elsp02/cubes-platformIO/firmware/src/firmware_baseplate/README.md

main_baseplate_feedback2.cpp: mit predefined feedback data, kein pc steuerung und debug möglichkeit
uart_main_baseplate.cpp: mit originalem feedback data, pc steuerung, keine debug möglichkeit - fuktioniert
state_machine.cpp: baseplate als state machine
state_machine_debug: ohne pc control und mit vordifiniertem feedback payload
