elsp02/cubes-platformIO/docs/fehler.md

predefined: 3 laufen -> also sowohl payload korrekt als auch led
normal: die drei laufen auch nicht 
debug: alle laufen 

feedback payload len
