elsp02/cubes-platformIO/doc/firmware.md

#content
Ablaufdiagramm und Struktur der Software von baseplate

---
## generell
### child polling
### vlt auch main loop und frame reception

## baseplate
was macht die basplate im code?
###  role
The baseplate is the root of the system. It starts the communication and receives the complete serialized cube tree.

### main loop
1. Release all lines.
2. Send CMD_STATUS to child.
3. Wait for ACK_BUSY.
4. Receive DATA_FRAME.
5. Validate frame.
6. Parse payload.
7. Output tree.
### baseplate flowchart -optional

```mermaid
flowchart TD
    A[Start loop] --> B[Release child line]
    B --> C[Send CMD_STATUS]
    C --> D[Wait for ACK_BUSY]
    D -->|No ACK| A
    D -->|ACK received| E[Receive DATA_FRAME]
    E -->|Invalid frame| A
    E -->|Valid frame| F[Parse payload]
    F --> G[Print / forward tree]
    G --> A
```
### (frame reception and) payload parsing

### error behavior??

### pseudocode
void loop()
{
    send_status_command(child_0);

    if (!receive_ack_busy(child_0)) {
        return;
    }

    if (!receive_frame(child_0, payload, MAX_PAYLOAD_LEN, &payload_len)) {
        return;
    }

    parse_payload_to_tree(payload, payload_len, &root_index);
}
### payload parsing
nicht die Theorie, sondern wann die Baseplate den Parser benutzt.

After the baseplate receives and validates a complete data frame, it passes only the payload to the tree parser. The parser reconstructs the n-ary tree recursively.
---
## cube
### role
Each cube acts as a child toward its parent and as a parent toward its own children.

### state machine diagram
```mermaid
stateDiagram-v2
    [*] --> IDLE
    IDLE --> ORIENTATION_SCAN
    ORIENTATION_SCAN --> RECEIVE_CMD: LOW detected
    RECEIVE_CMD --> IDLE: byte != CMD_STATUS
    RECEIVE_CMD --> SEND_ACK: byte == CMD_STATUS
    SEND_ACK --> POLL_CHILDREN
    POLL_CHILDREN --> BUILD_PAYLOAD
    BUILD_PAYLOAD --> SEND_FRAME_UPSTREAM
    SEND_FRAME_UPSTREAM --> RELEASE_LINES
    RELEASE_LINES --> IDLE
```

### main loop

### pseudo code

```mermaid
sequenceDiagram
    participant P as Parent Cube / Baseplate
    participant C as Cube Node
    participant CC as Child Cubes

    P->>C: CMD_STATUS
    P-->>C: Release line

    C->>C: Detect active upstream pin
    C->>C: Store orientation
    C->>P: ACK_BUSY

    loop For each retry round and child port
        C->>CC: CMD_STATUS
        CC->>C: ACK_BUSY
        CC->>C: DATA_FRAME
        C->>C: Store child payload
    end

    C->>C: Build own payload
    C->>P: DATA_FRAME<br/>SYNC | LEN | PAYLOAD | CHECKSUM
```
