elsp02/cubes-platformIO/thesis/figures/blockdiagramm-baseplate.pdf

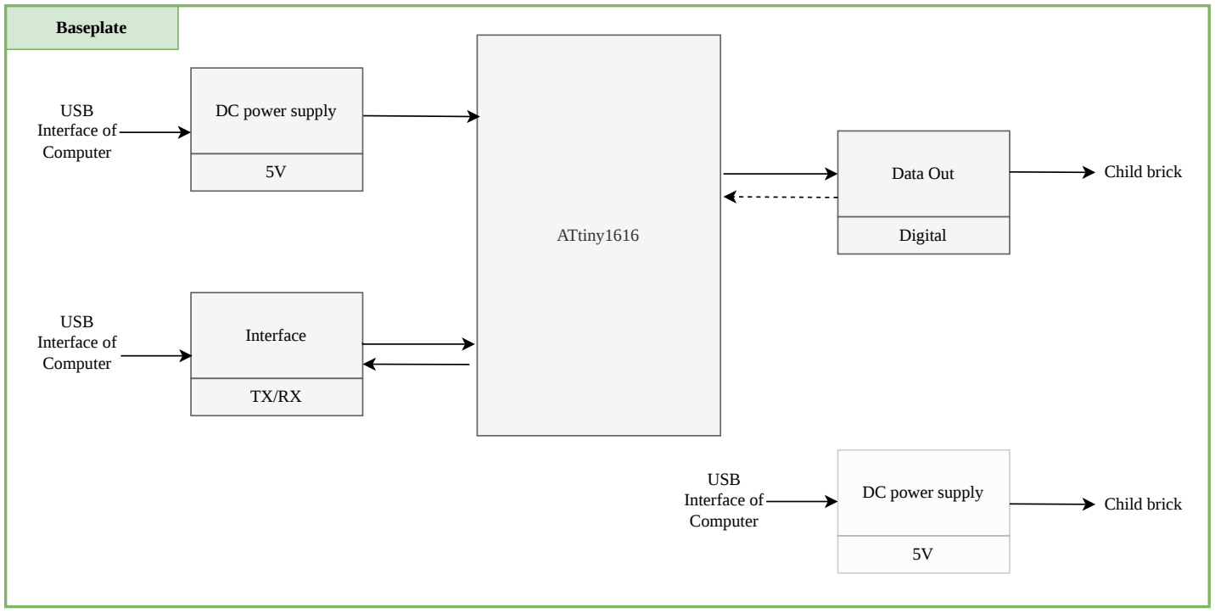
[picture p5: figure]
ATtiny1616; Data Out; DC power supply; Digital; USB Interface of Computer; Child brick; Interface; Baseplate
