elsp02/cubes-platformIO/thesis/figures/blockdiagramm-brick.pdf

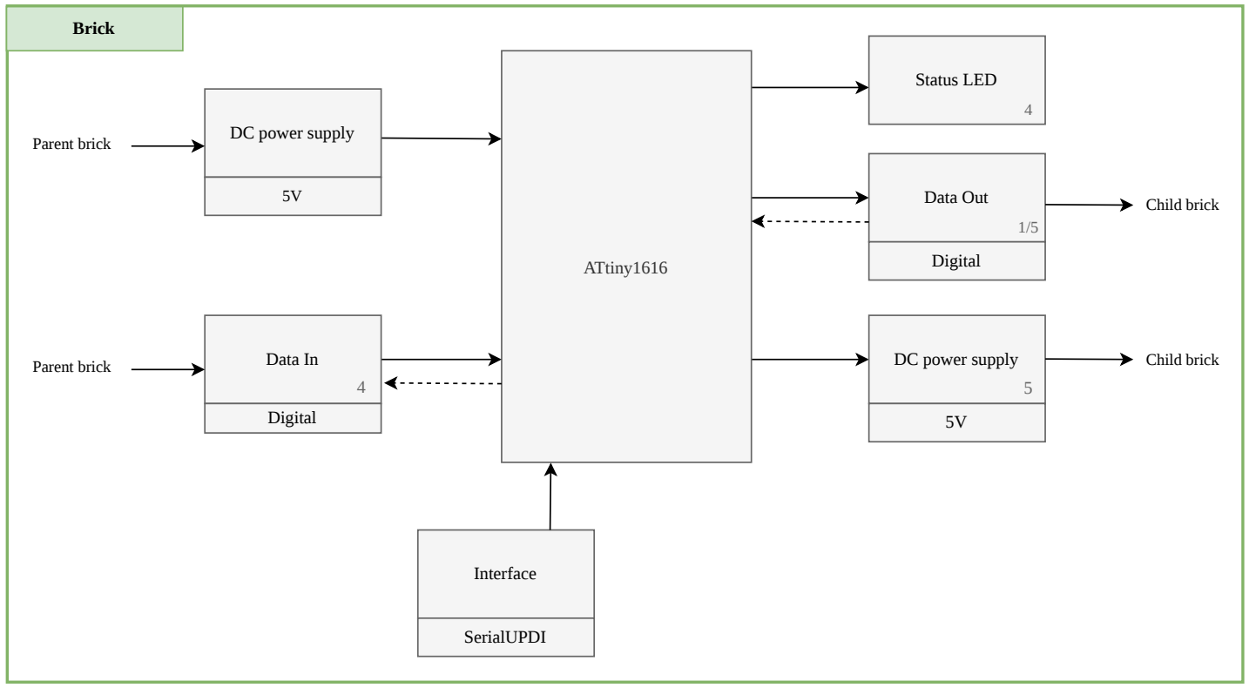
[picture p6: figure]
ATtiny1616; Status LED; Data Out; Data In; DC power supply; Digital; Interface; SerialUPDI; Parent brick; Child brick; Brick
