elsp02/cubes-platformIO/thesis/figures/concept-blockdiagramm.pdf

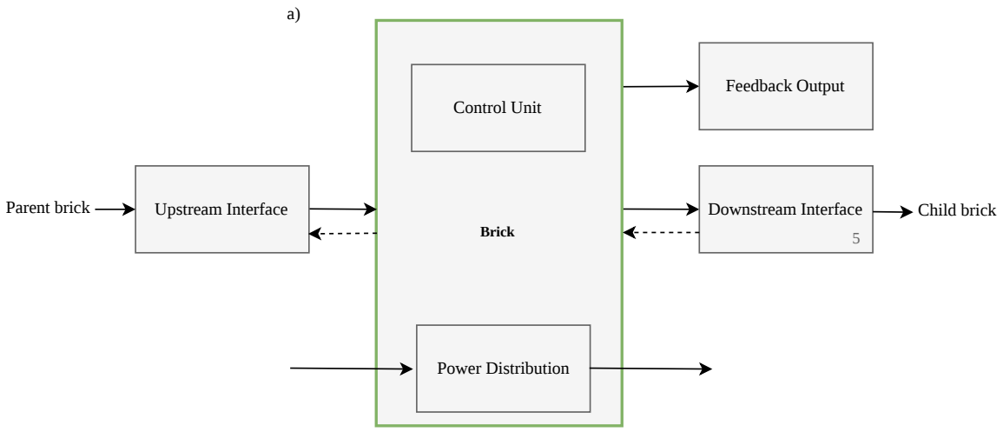
[picture p7: figure]
Feedback Output; Upstream Interface; Downstream Interface; Parent brick; Power Distribution; Control Unit; Brick; Child brick
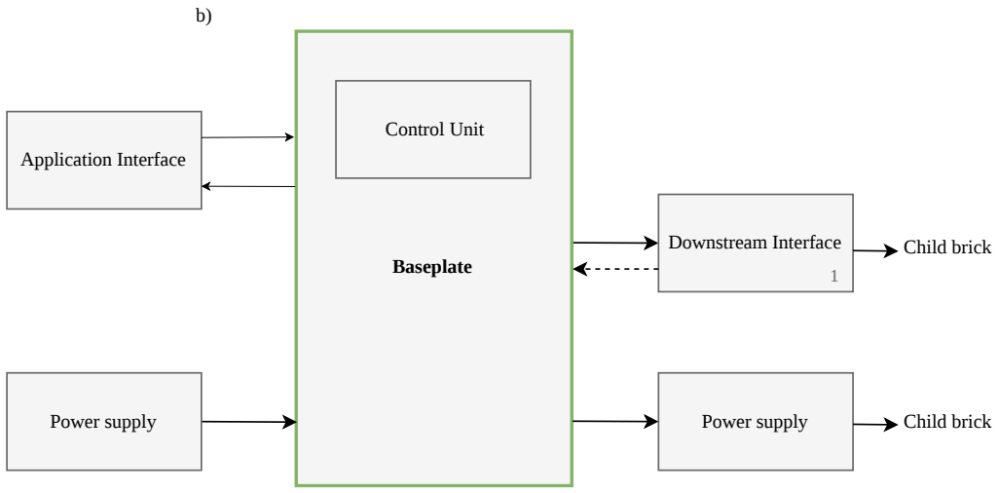
[picture p8: figure]
Downstream Interface; Child brick; Control Unit; Baseplate; Application Interface; Power supply
