elsp02/cubes-platformIO/comments/pdf/config.pdf

include\config.h

1 // Define configuration constants for the project 2 #ifndef CONFIG_H
3 #define CONFIG_H
4
5 #include <Arduino.h>
6 #include <avr/io.h>
7 #include <stdint.h>
8 #include <stdbool.h>
9
10 #ifndef F_CPU
11 | #define F_CPU 20000000UL | // better to define in .ini file: build_flags = -DF_CPU=20000000UL/board_build.f_cpu = 20000000L
12 #endif
13
14 // ----------------------------------------------------------
15 // Timing
16 // ----------------------------------------------------------17
18 | #define BAUD_US | 104
19 | #define TURNAROUND_US | (BAUD_US * 3)
20 | #define CHILD_TIMEOUT_US | 15000
21 | #define PARENT_TIMEOUT_US | 15000
22 | #define FRAME_TIMEOUT_US | 15000
23
24 // ----------------------------------------------------------25 // Counts / Limits
26 // ----------------------------------------------------------
27 | #define CHILD_COUNT | 2
28 | #define CHILD_RETRIES | 3
29 | #define UPSTREAM_FAIL_LIMIT | 3
30
31 // ???????????
32 | #define NODE_HEADER_LEN | 3
config.h | http://localhost:54352/4e486bd0-b9ec-40f0-b269-f2023e1451f3/
1 von 2 | 06.06.2026, 12:30

33 //macht so nicht so viel sinn, weil letztes child in upstream reihe ja eigentliche alle payloads von allen anderen bekommt -> child payload lenght kann nicht einfach so mit max_length durch anzahl kinder berechnet werden
34 | #define MAX_PAYLOAD_LEN | 128 // must be <256 for 1 byte LEN field, but should also be limited to avoid long transmission
times and large buffers. For prototype_v3, we can set it to 128 as a reasonable limit for testing.
35 | #define MAX_CHILD_PAYLOAD_LEN | 128 //I don´t need this
36
37 // ----------------------------------------------------------
38 // Protocol bytes
39 // ----------------------------------------------------------40
41 | #define CMD_STATUS | 0xAA
42 | #define ACK_BUSY | 0x55
43 | #define DATA_BYTE | 0x42
44 | #define SYNC_BYTE | 0xA5
45
46 // ----------------------------------------------------------47 // Node data
48 // ----------------------------------------------------------49
50 | #define NODE_ID | 0x10
51
52 #endif // CONFIG_H
config.h | http://localhost:54352/4e486bd0-b9ec-40f0-b269-f2023e1451f3/
2 von 2 | 06.06.2026, 12:30
