elsp02/cubes-platformIO/firmware/src/firmware_cube/README.md

old_uart_main_cube.cpp: sollte so sein wie in code_improved branch
final_uart_main_cube.cpp: angepasst auf code_improved branch und aktueller firmware struktur (aufgeteilt in unterordner) - funktioniert
