elsp02/cubes-platformIO/doc/visualization.md

# Visualization
(noch zu machen)

## Data Pipeline

Serialized payload
→ Parsed tree
→ Coordinate/orientation interpreter
→ JSON structure
→ Three.js or MeshCat visualization

## Coordinate Interpreter

The absolute position of a cube is calculated recursively from the parent position, parent rotation, child port direction, and local orientation.

## visualization und gaming -> bedürfnisse von special needs kindern berücksichtigen (tui designanforderungen)
physische representation der steine/abstrakheit
- die bausteine schauen physisch als auch visualiziert gleich aus

komplexität:
- Design zu einfach (langweilig) vs Design zu komplex (überfordernd)
