elsp02/cubes-platformIO/thesis/figures/systemarchitektur_komponenten.pdf

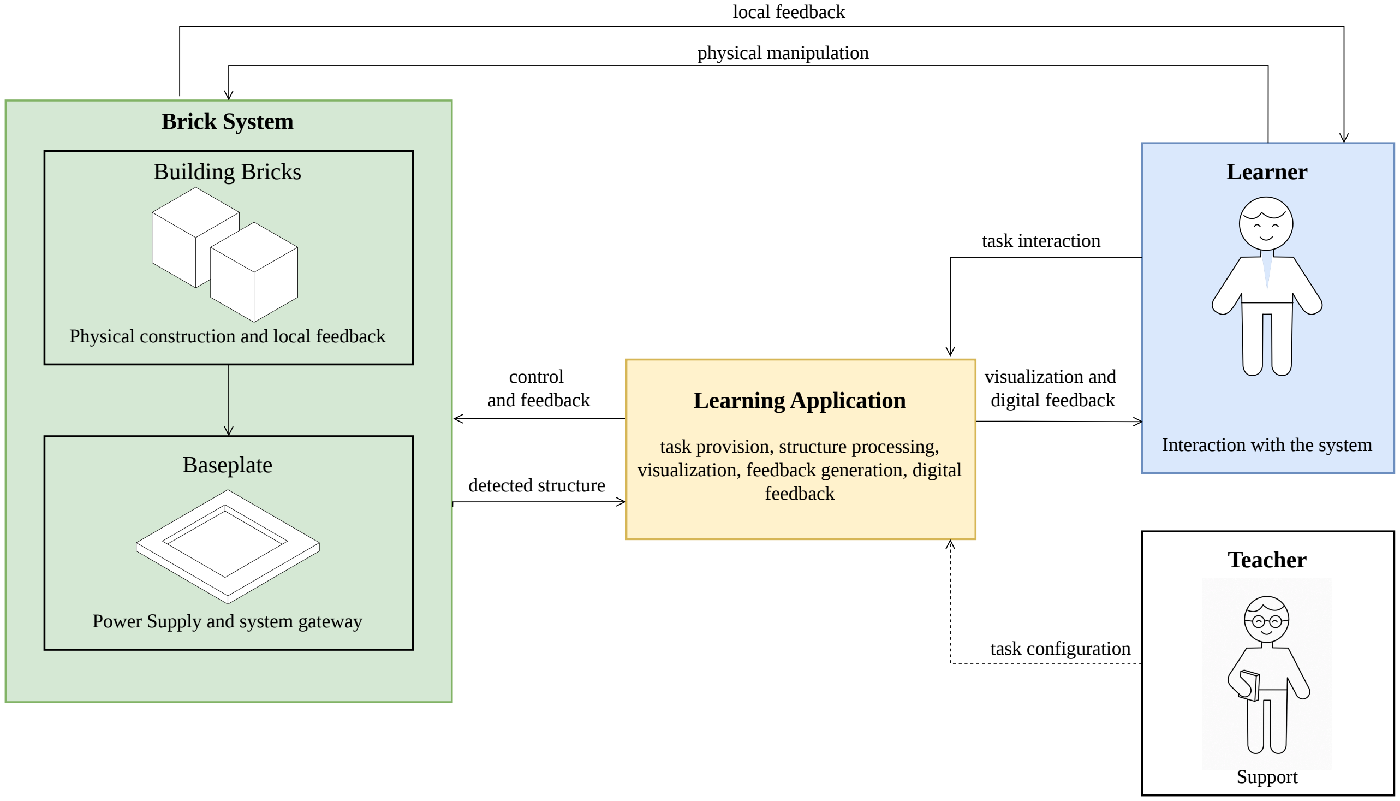
[picture p9: figure]
task configuration; Power Supply and system gateway; Baseplate; Building Bricks; Learning Application; task provision, structure processing,; feedback; Interaction with the system; physical manipulation; Learner; local feedback; task interaction; visualization and digital feedback; detected structure; control and feedback; Brick System; Teacher; Support

Physical construction and local feedback

visualization, feedback generation, digital
