elsp02/cubes-platformIO/doc/diagrams/generated/systemarchitecture_diagramm_v2_preview.png

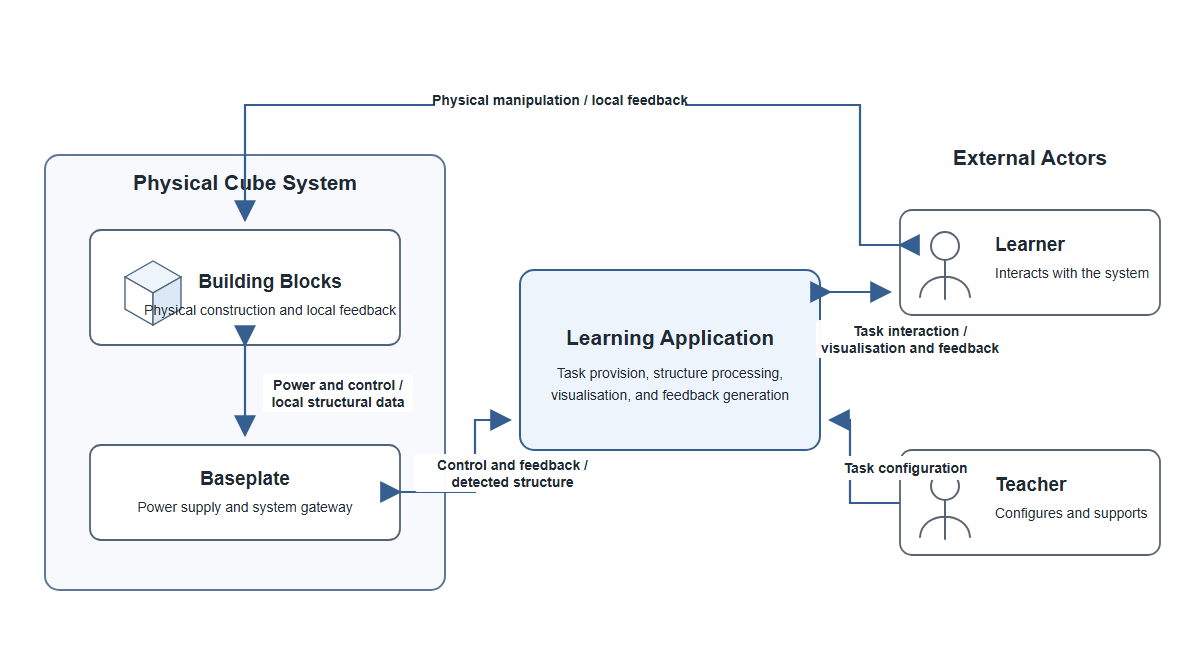
doc/diagrams/generated/systemarchitecture_diagramm_v2_preview.png
