elsp02/cubes-platformIO/figures/brick-orientation.jpg

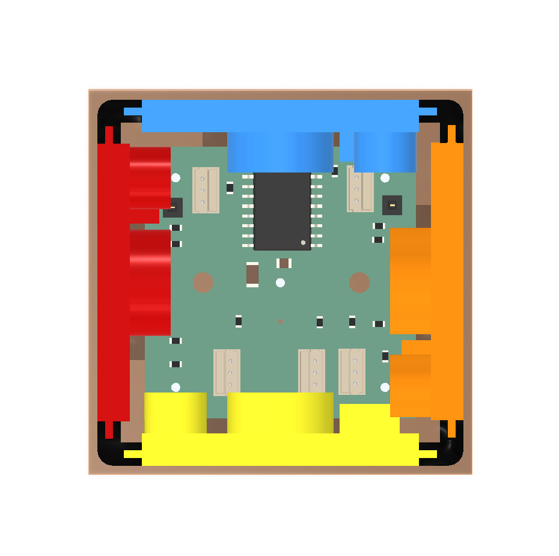
figures/brick-orientation.jpg
