elsp02/cubes-platformIO/figures/faces-ohne-hintergrund.png

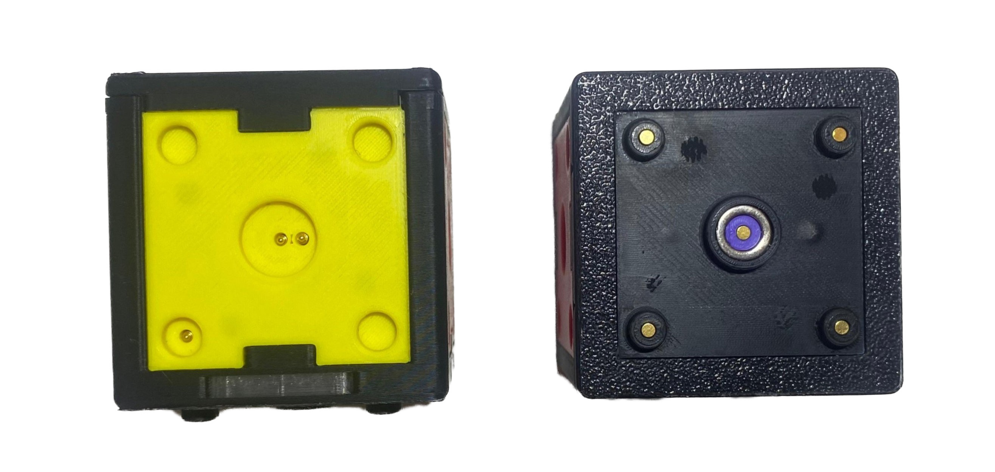
figures/faces-ohne-hintergrund.png
