elsp02/cubes-platformIO/figures/Hintergrund.jpg

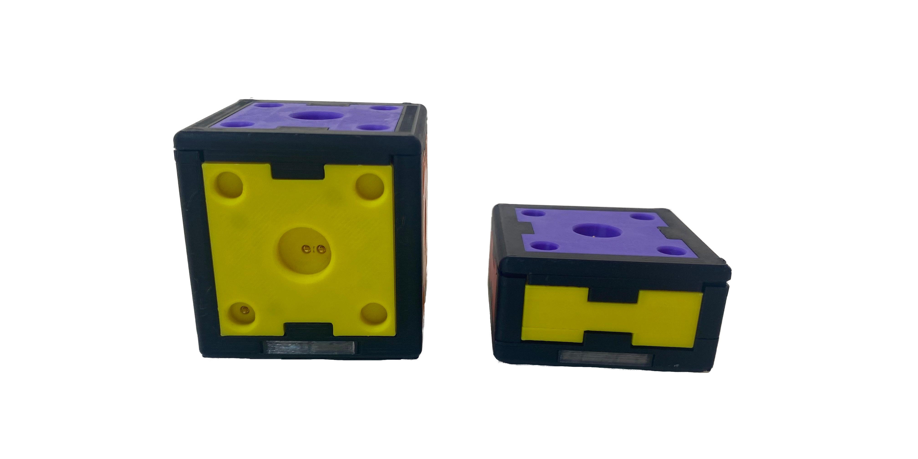
figures/Hintergrund.jpg
