elsp02/cubes-platformIO/software/threejs_visualization/frontend/img/gif/brick_loader.gif

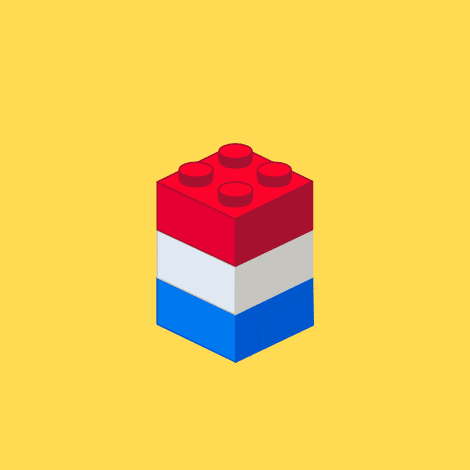
software/threejs_visualization/frontend/img/gif/brick_loader.gif
