elsp02/cubes-platformIO/thesis/figures/activecube.png

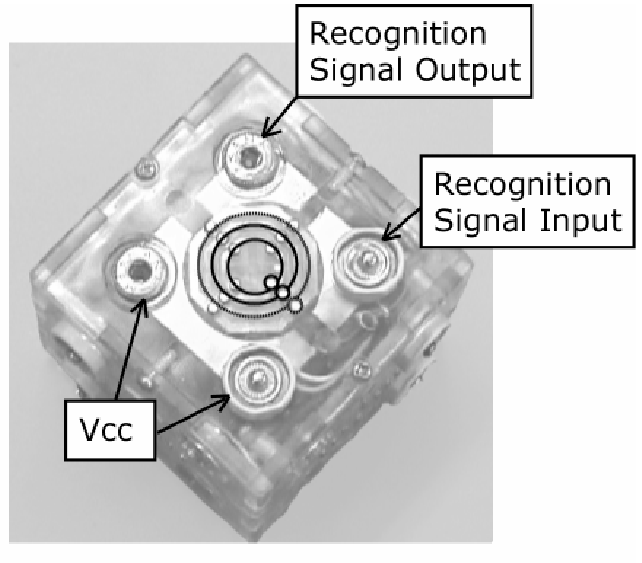
thesis/figures/activecube.png
