elsp02/cubes-platformIO/thesis/figures/baseplate.jpg

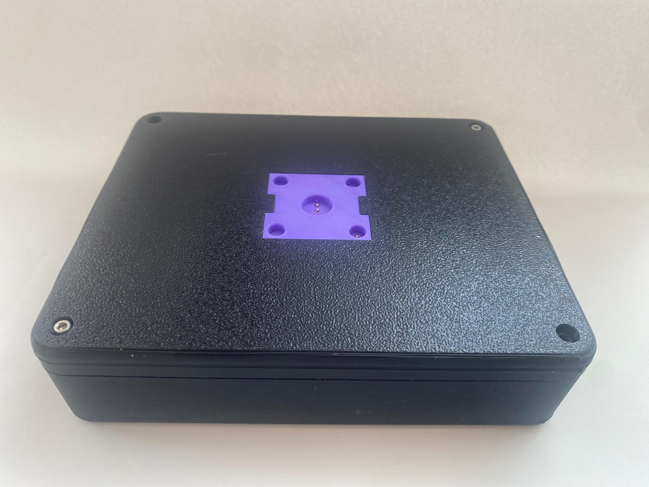
thesis/figures/baseplate.jpg
