elsp02/cubes-platformIO/thesis/figures/baseplate@3x.png

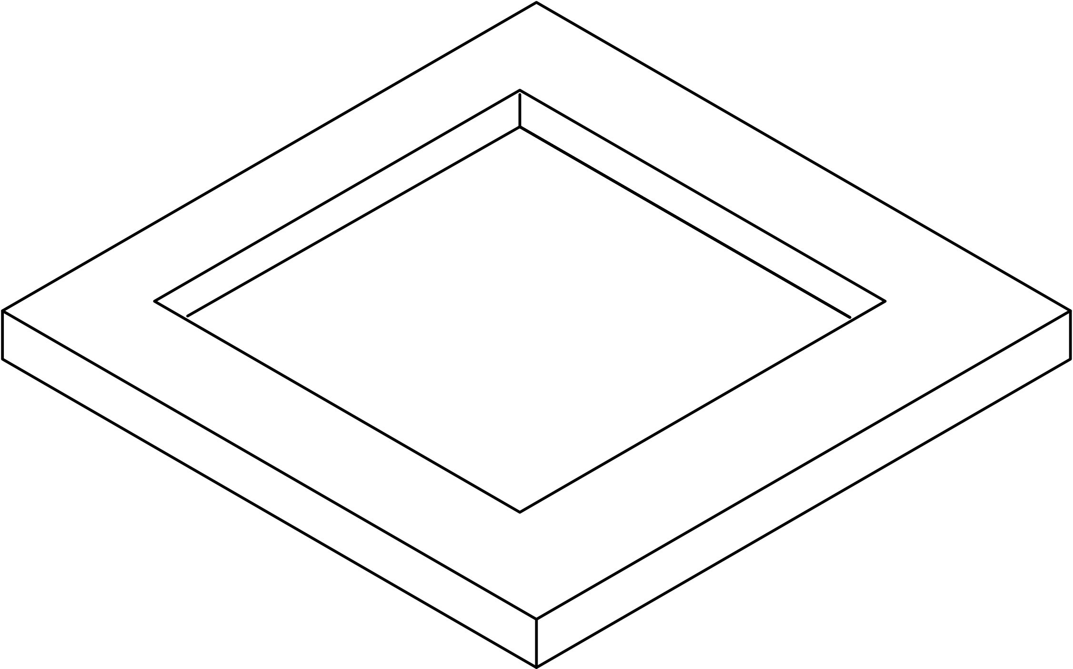
thesis/figures/baseplate@3x.png
