elsp02/cubes-platformIO/thesis/figures/bauen2.png

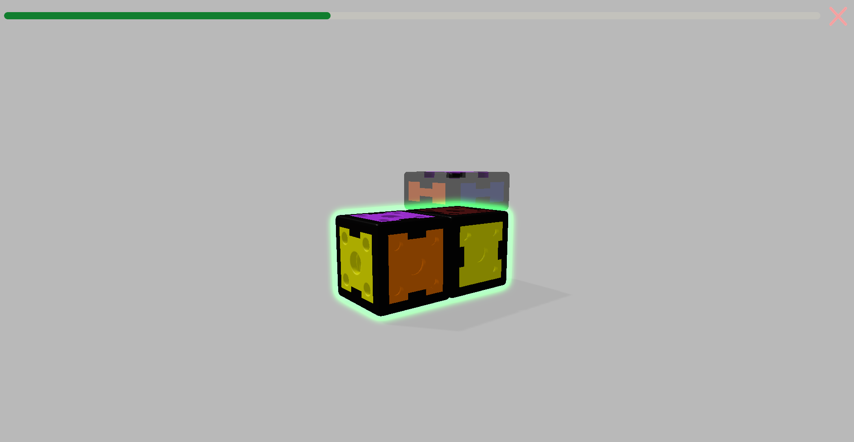
thesis/figures/bauen2.png
