elsp02/cubes-platformIO/thesis/figures/bricks-and-visualization.jpg

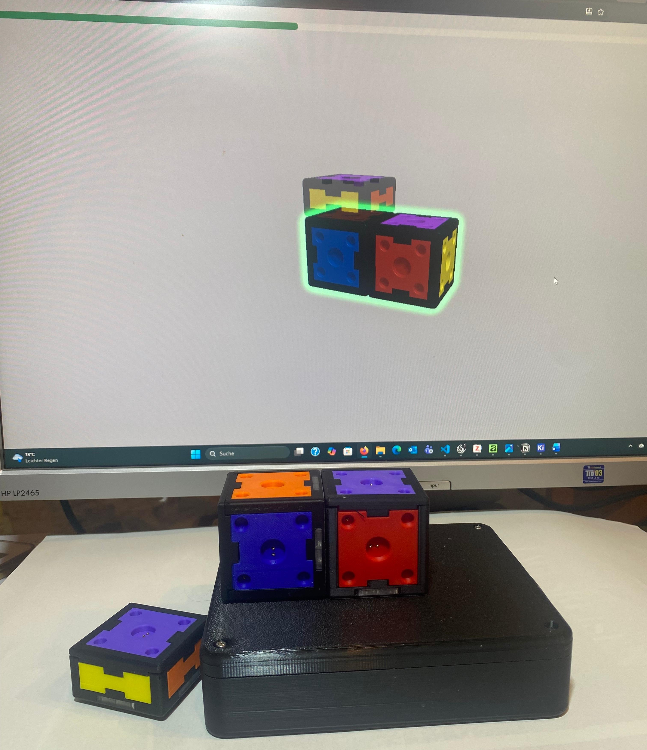
thesis/figures/bricks-and-visualization.jpg
