elsp02/cubes-platformIO/thesis/figures/bricks-konstruktion.jpg

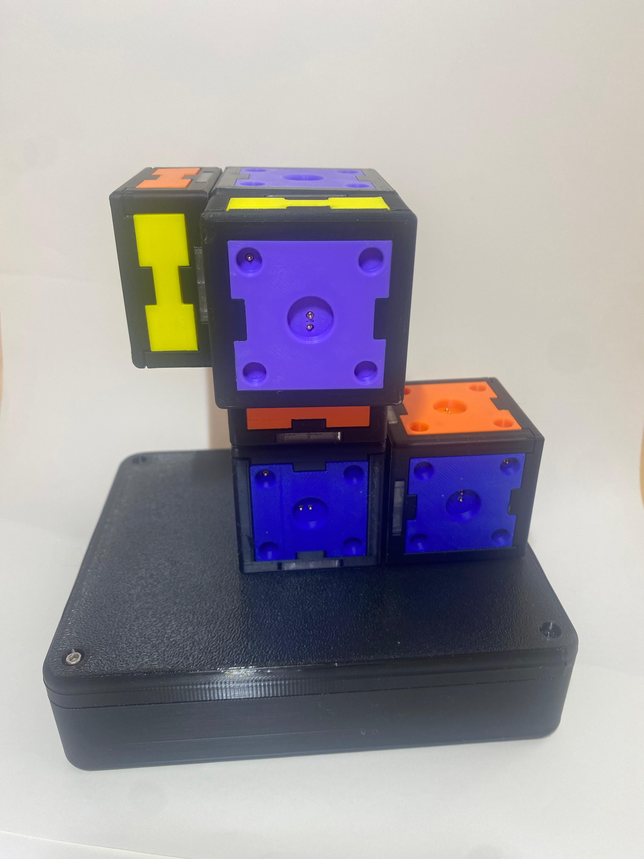
thesis/figures/bricks-konstruktion.jpg
