elsp02/cubes-platformIO/thesis/figures/bricks-physisch.jpg

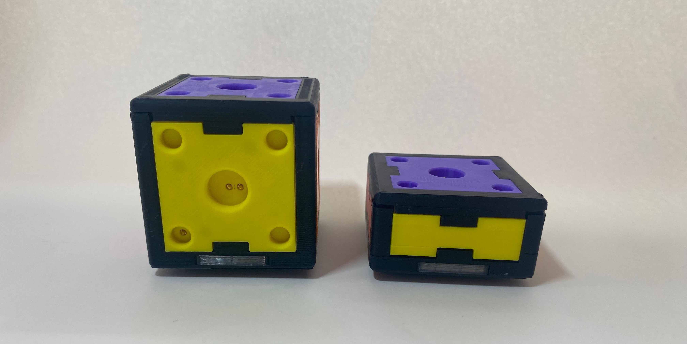
thesis/figures/bricks-physisch.jpg
