elsp02/cubes-platformIO/thesis/figures/bricks.png

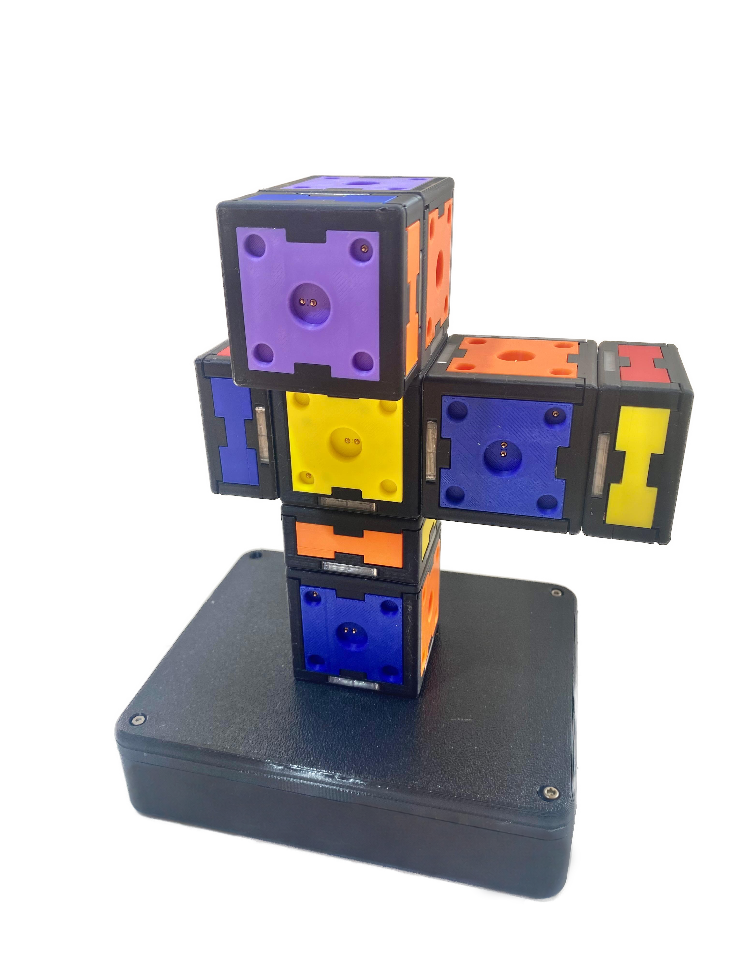
thesis/figures/bricks.png
