elsp02/cubes-platformIO/thesis/figures/contact-arrangement@3x.png

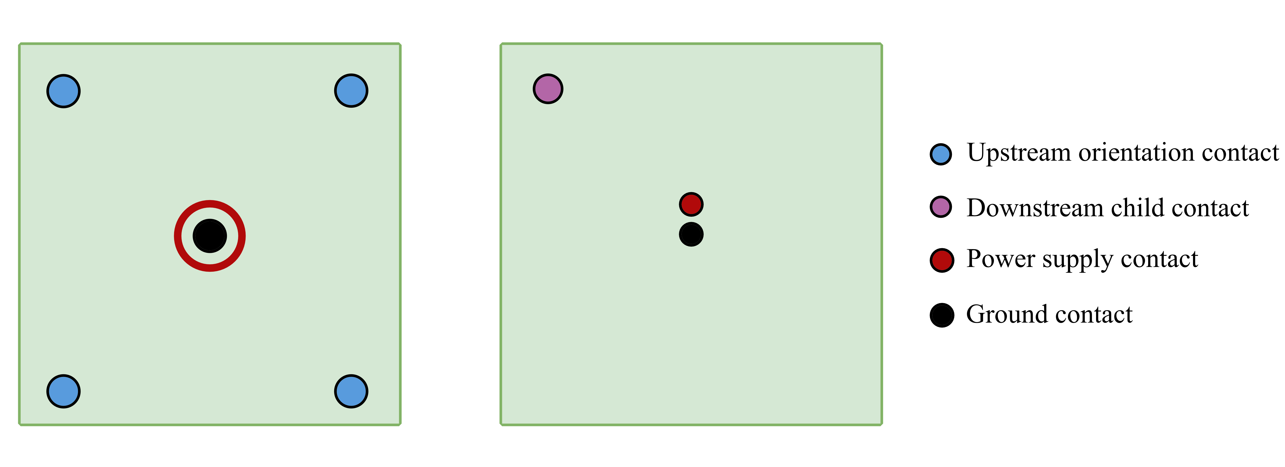
thesis/figures/contact-arrangement@3x.png
