elsp02/cubes-platformIO/thesis/figures/correct-brick.png

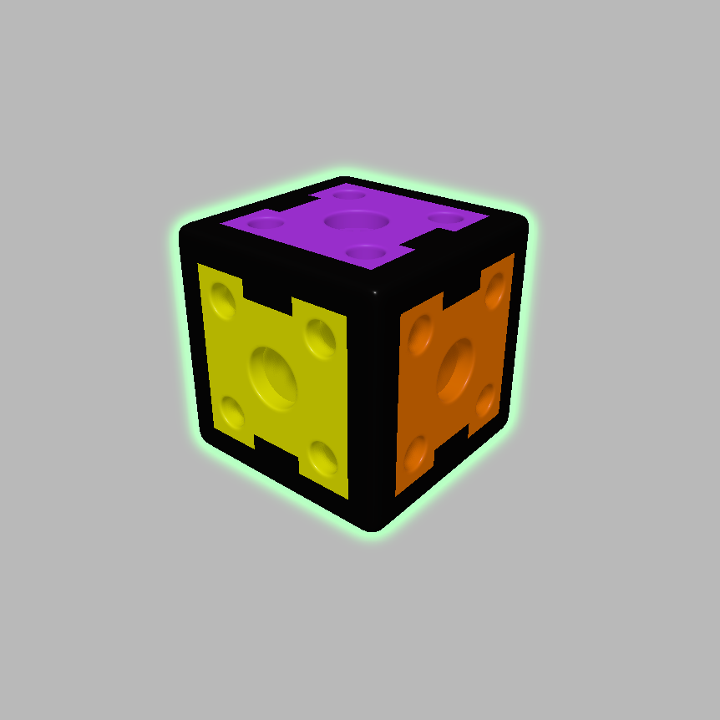
thesis/figures/correct-brick.png
