elsp02/cubes-platformIO/thesis/figures/coupling@3x.png

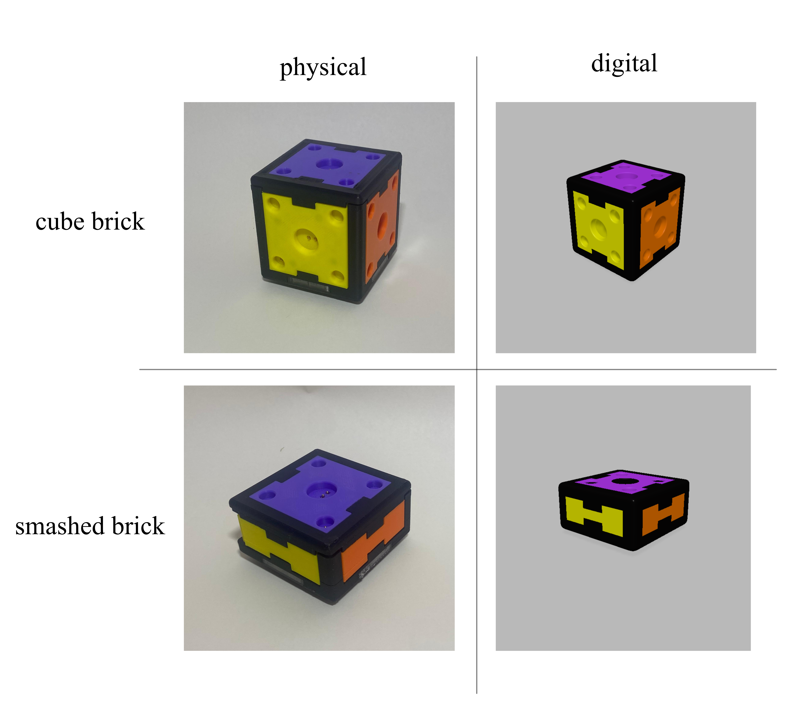
thesis/figures/coupling@3x.png
