elsp02/cubes-platformIO/thesis/figures/cube-brick2.png

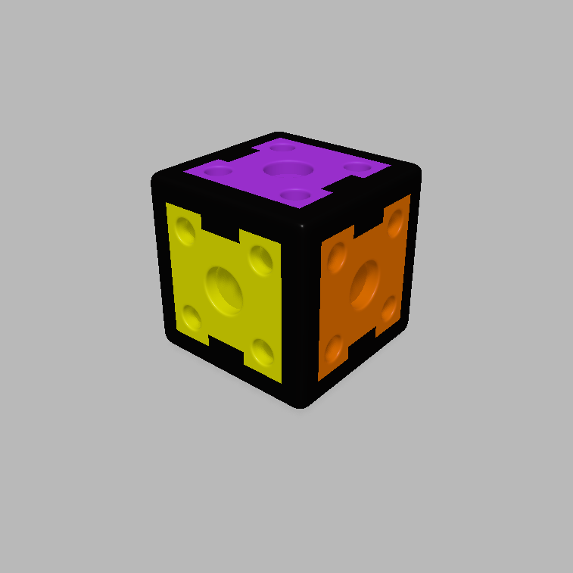
thesis/figures/cube-brick2.png
