elsp02/cubes-platformIO/thesis/figures/cube-brick-physisch.jpg

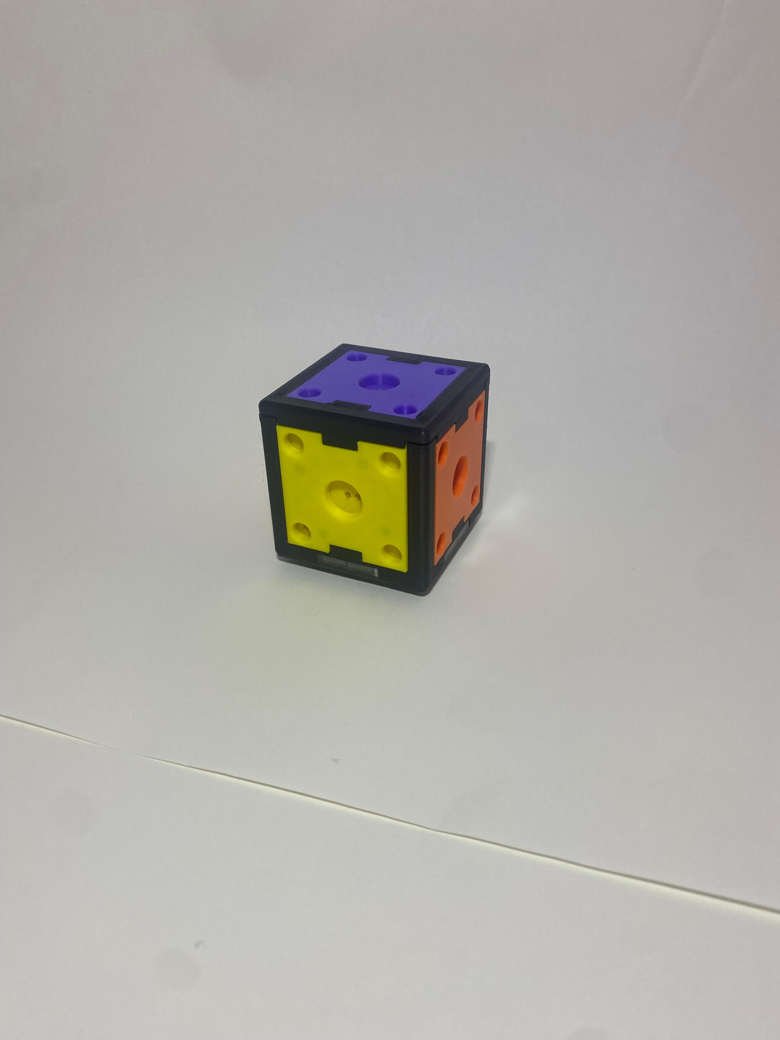
thesis/figures/cube-brick-physisch.jpg
