elsp02/cubes-platformIO/thesis/figures/cube-exploded.jpg

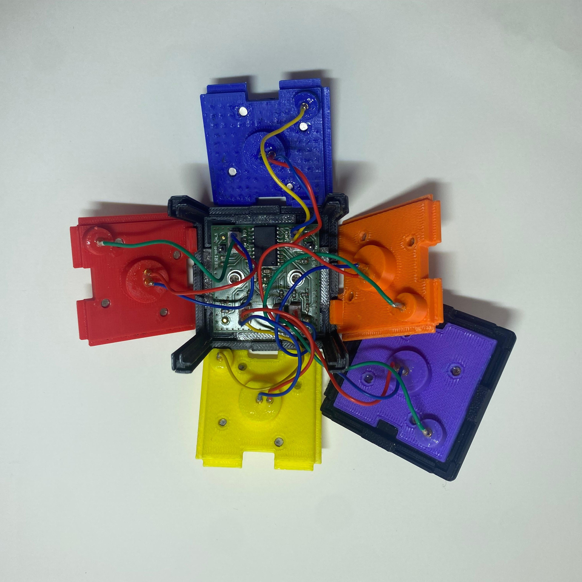
thesis/figures/cube-exploded.jpg
