elsp02/cubes-platformIO/thesis/figures/cube@3x.png

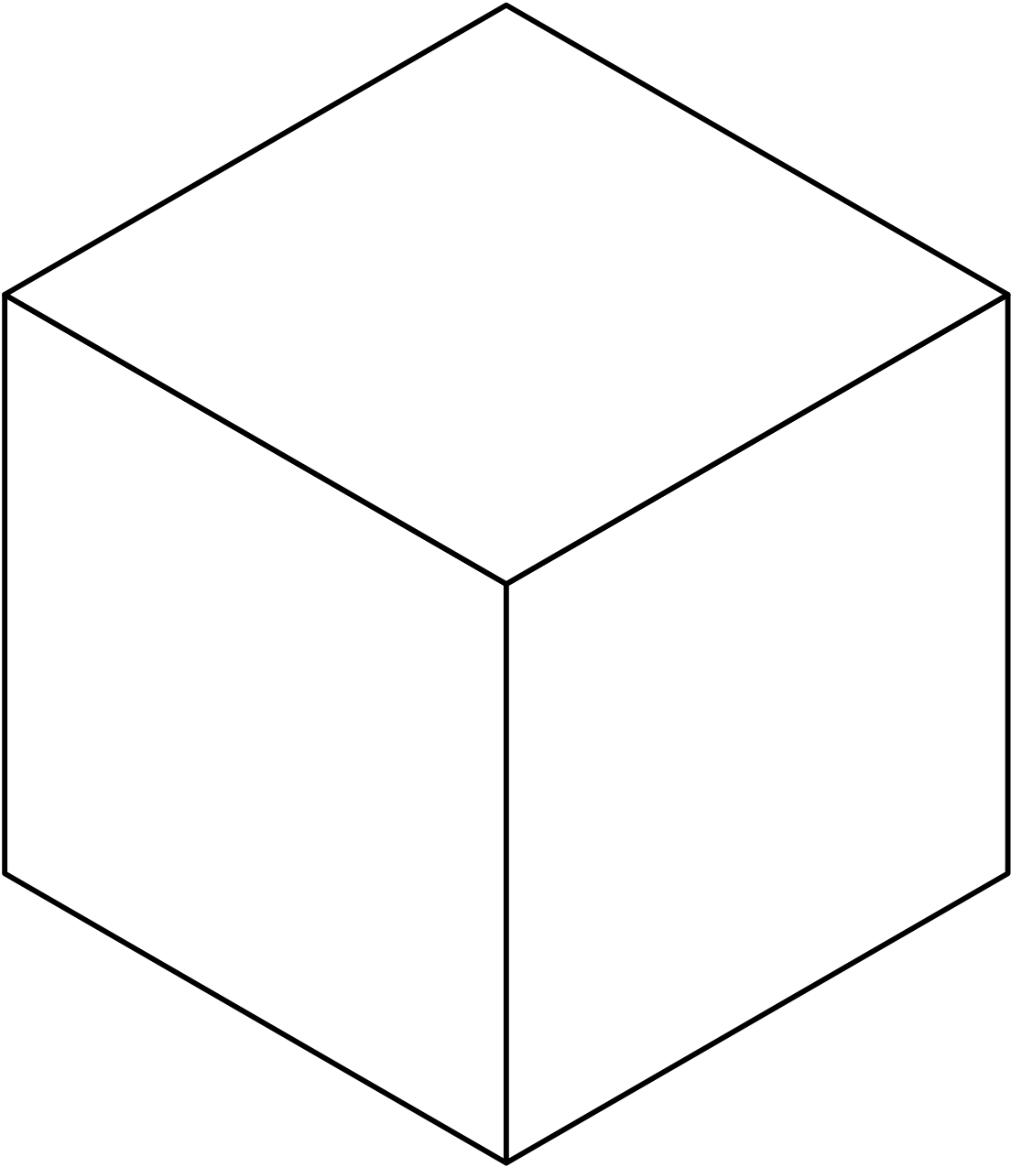
thesis/figures/cube@3x.png
