elsp02/cubes-platformIO/thesis/figures/digital-feedback@3x.png

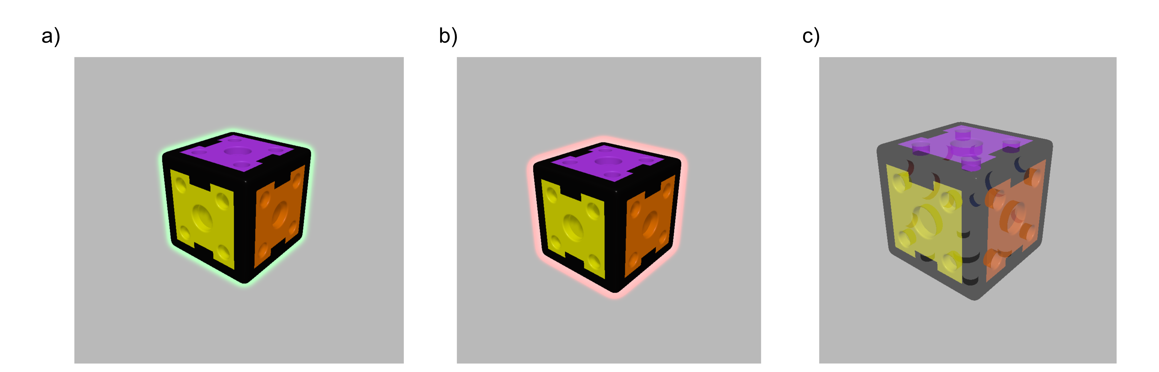
thesis/figures/digital-feedback@3x.png
