elsp02/cubes-platformIO/thesis/figures/exploded@3x.png

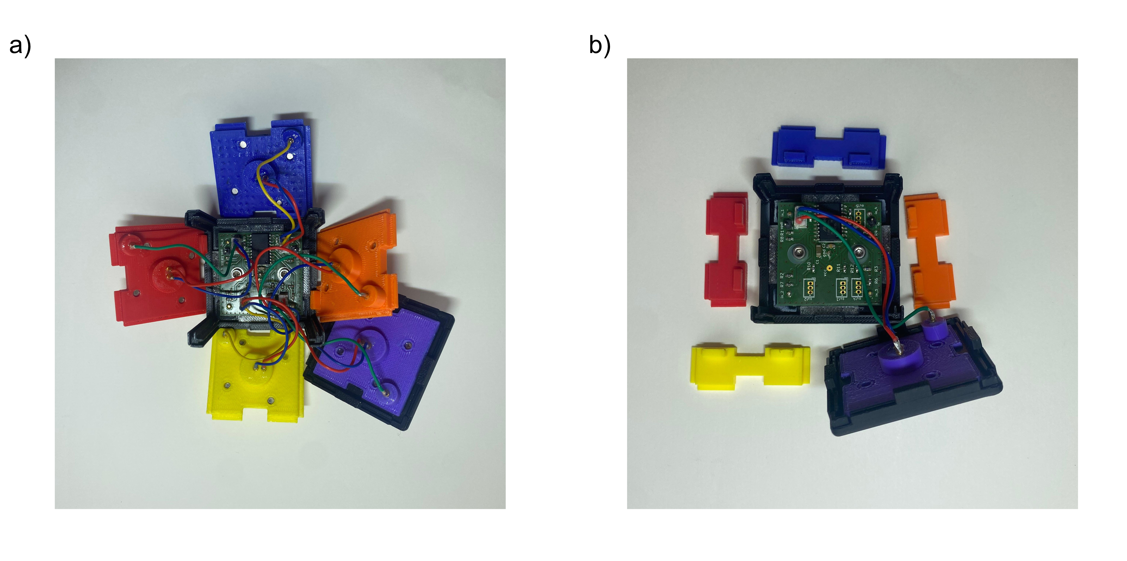
thesis/figures/exploded@3x.png
