elsp02/cubes-platformIO/thesis/figures/gui-vs-tui.jpg

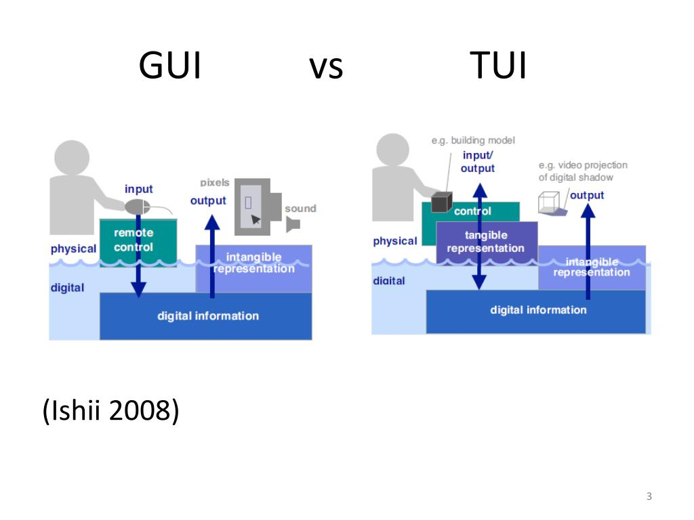
thesis/figures/gui-vs-tui.jpg
