elsp02/cubes-platformIO/thesis/figures/i-cube.png

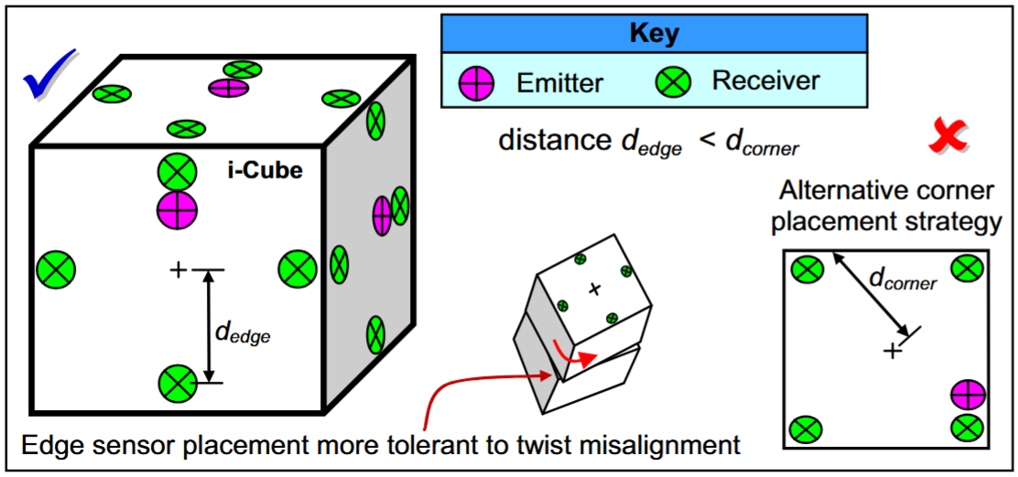
thesis/figures/i-cube.png
