elsp02/cubes-platformIO/thesis/figures/incorrect-brick.png

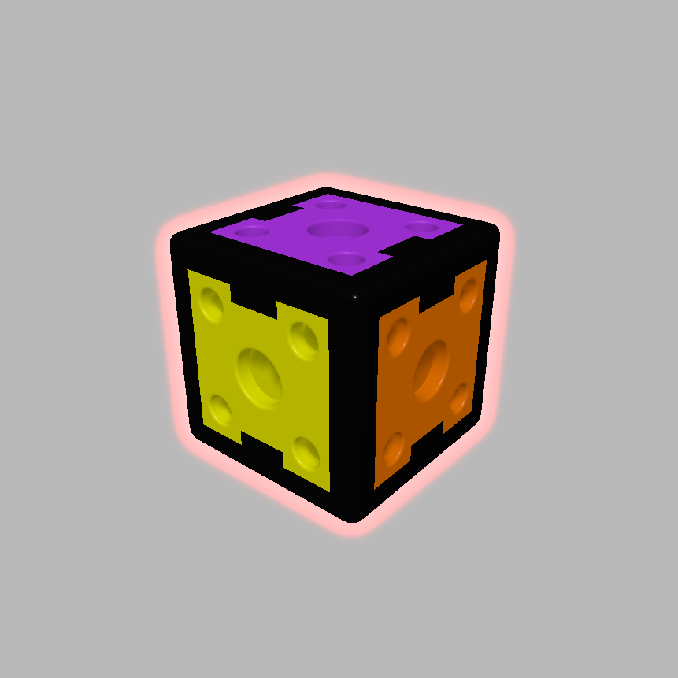
thesis/figures/incorrect-brick.png
