elsp02/cubes-platformIO/thesis/figures/kontakt-arrangement.jpg

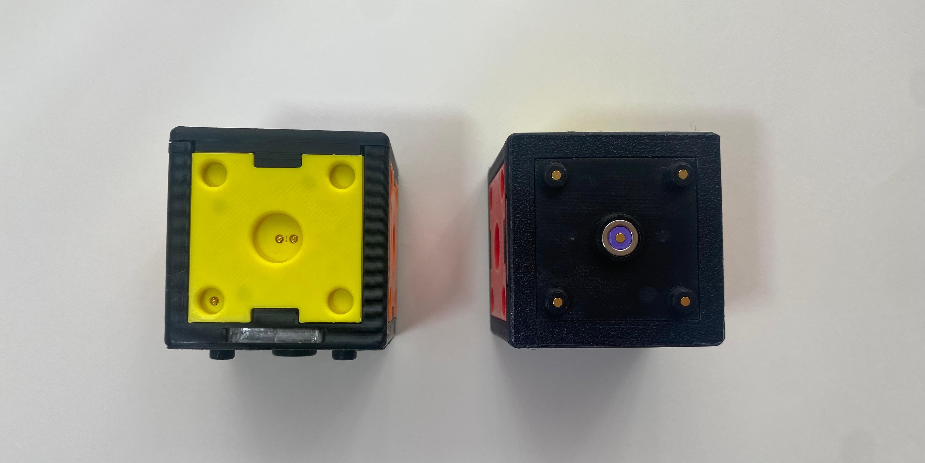
thesis/figures/kontakt-arrangement.jpg
