elsp02/cubes-platformIO/thesis/figures/learner@3x.png

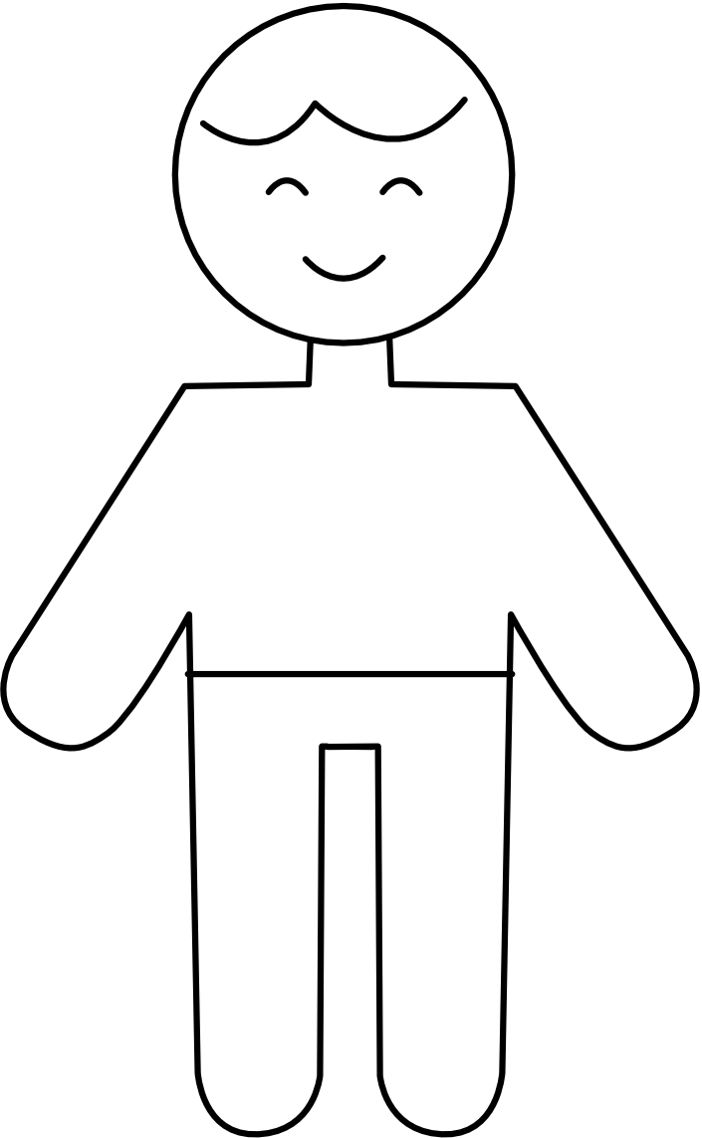
thesis/figures/learner@3x.png
