elsp02/cubes-platformIO/thesis/figures/learners1.jpg

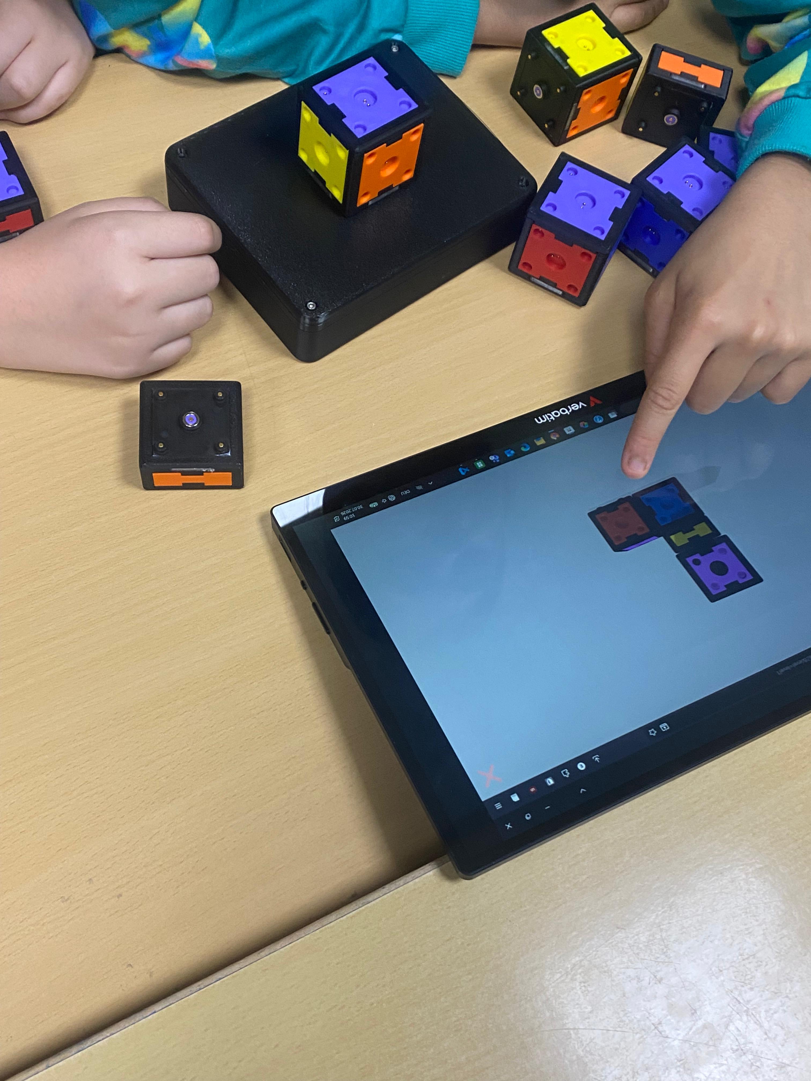
thesis/figures/learners1.jpg
