elsp02/cubes-platformIO/thesis/figures/learners.jpg

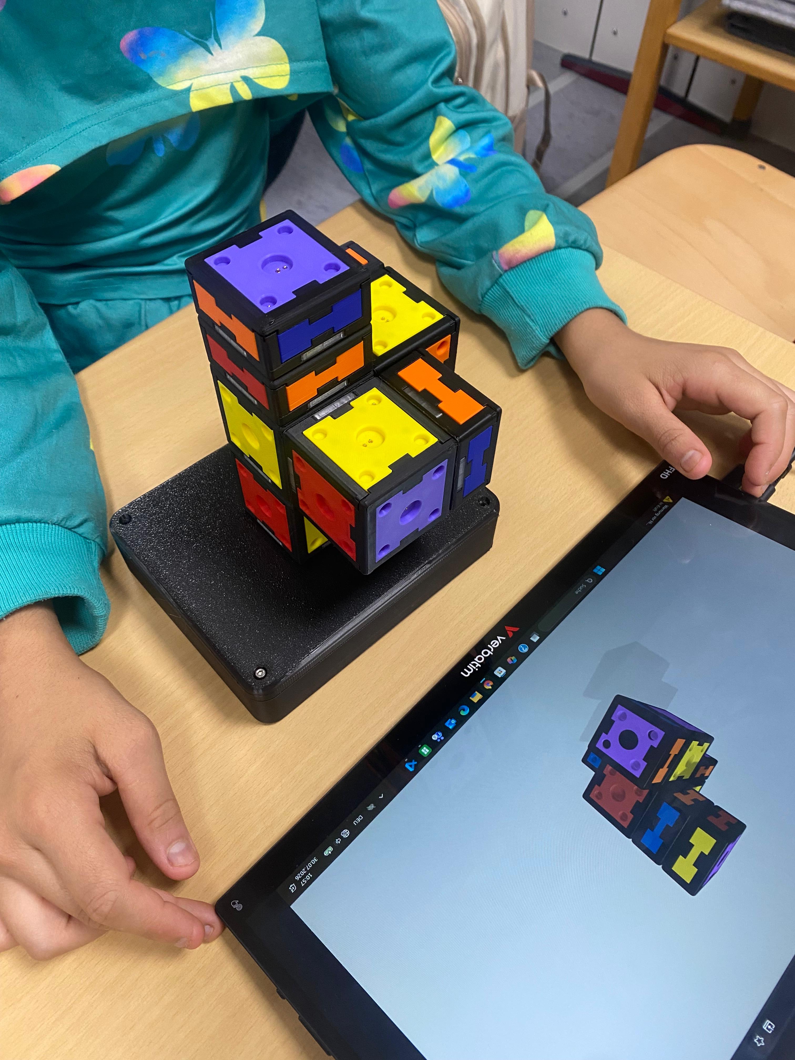
thesis/figures/learners.jpg
