elsp02/cubes-platformIO/thesis/figures/learners@3x.png

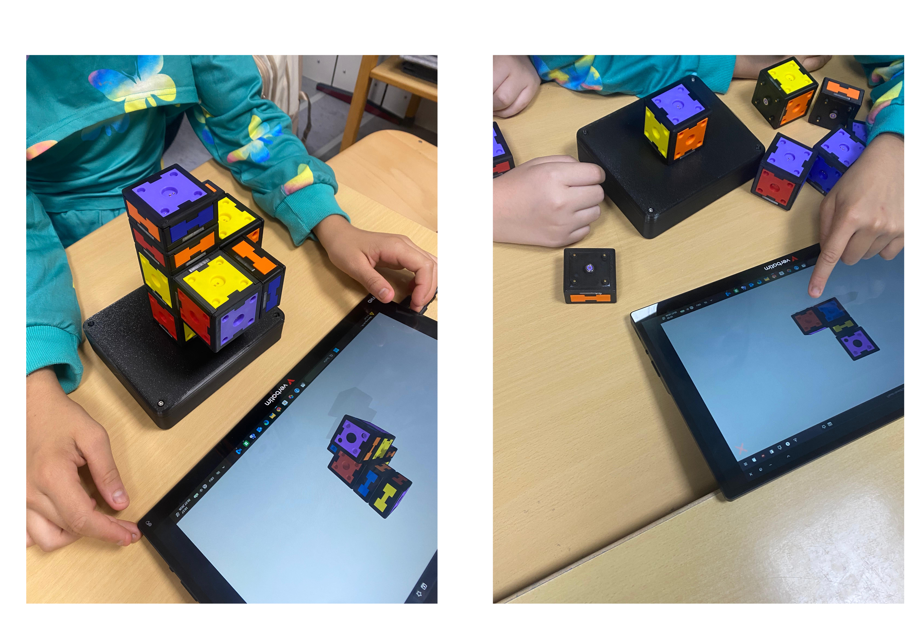
thesis/figures/learners@3x.png
