elsp02/cubes-platformIO/thesis/figures/lehrer-weisser-hintergrund.png

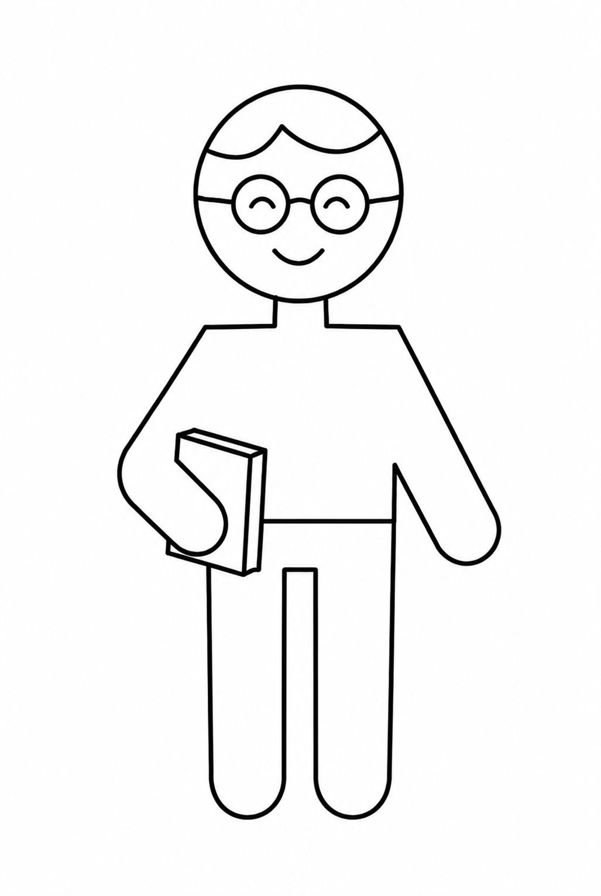
thesis/figures/lehrer-weisser-hintergrund.png
