elsp02/cubes-platformIO/thesis/figures/level-easy.png

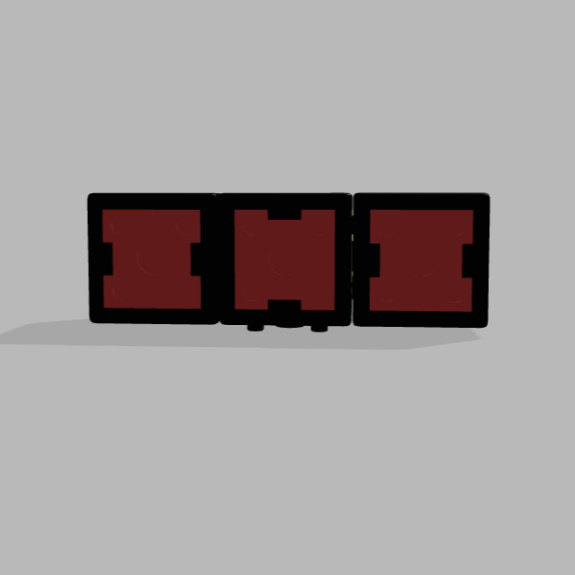
thesis/figures/level-easy.png
