elsp02/cubes-platformIO/thesis/figures/level-komplex.png

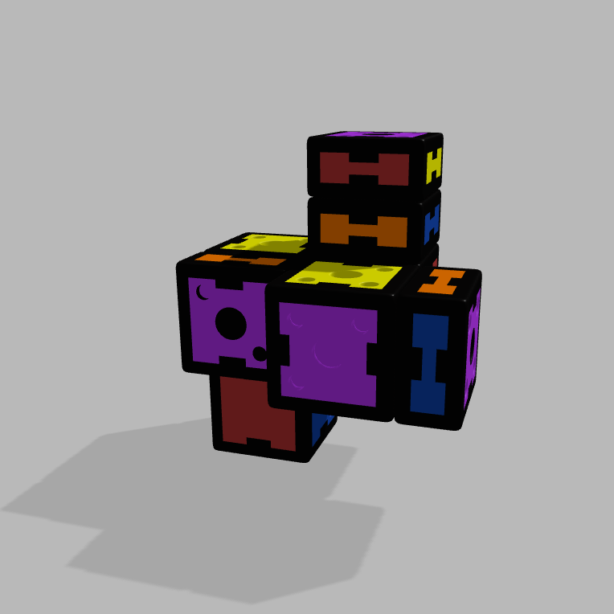
thesis/figures/level-komplex.png
