elsp02/cubes-platformIO/thesis/figures/level-middle.png

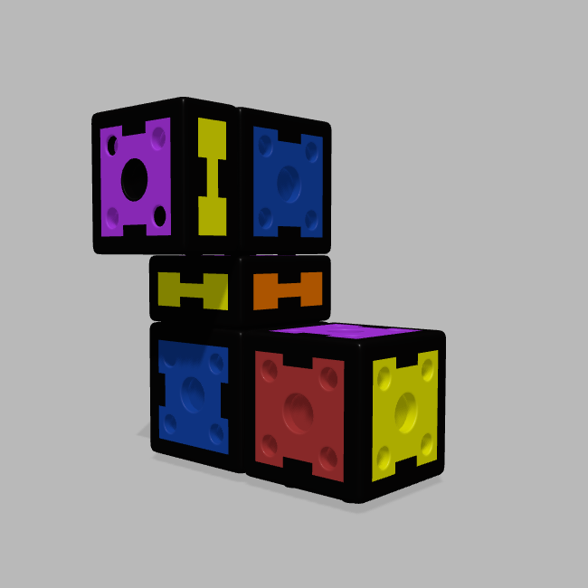
thesis/figures/level-middle.png
