elsp02/cubes-platformIO/thesis/figures/level@3x.png

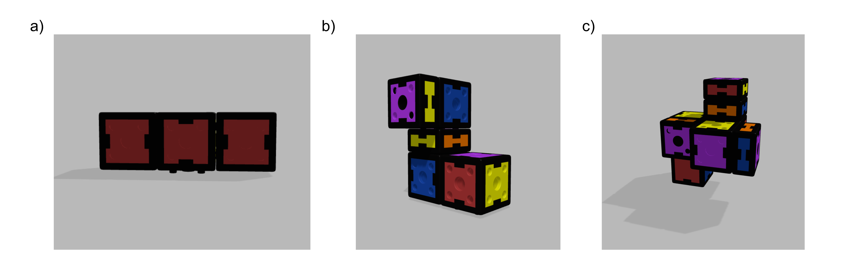
thesis/figures/level@3x.png
