elsp02/cubes-platformIO/thesis/figures/MVC-MCRpd-Model.png

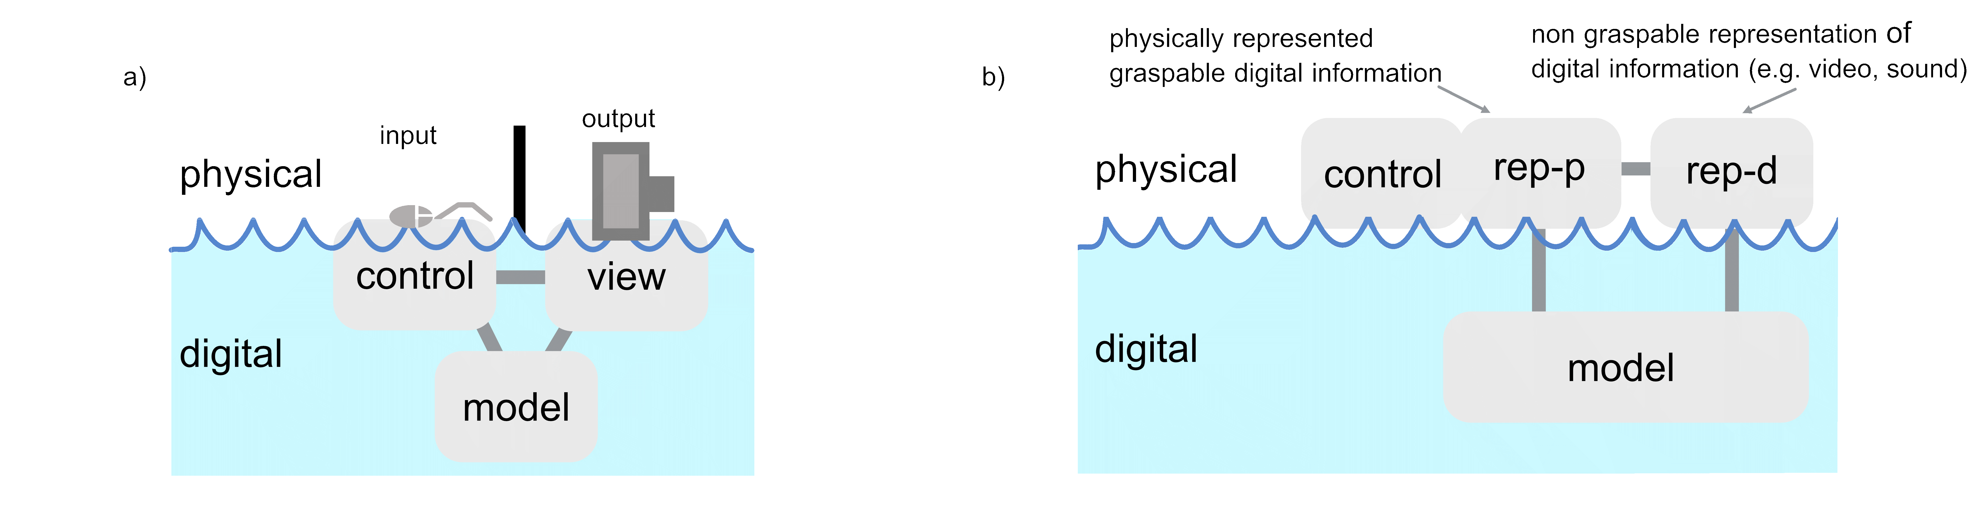
thesis/figures/MVC-MCRpd-Model.png
