elsp02/cubes-platformIO/thesis/figures/preview2.png

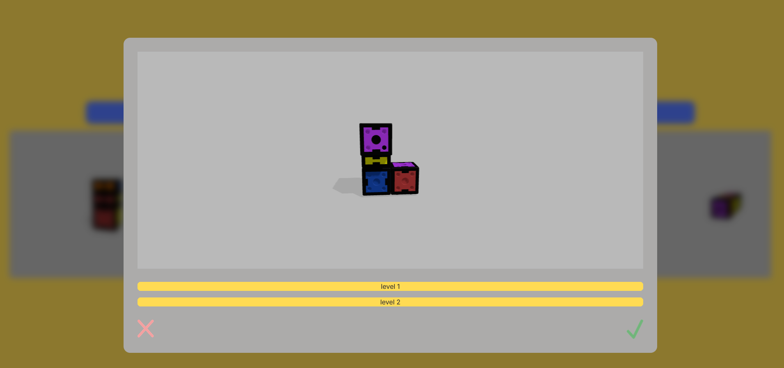
thesis/figures/preview2.png
