elsp02/cubes-platformIO/thesis/figures/preview.png

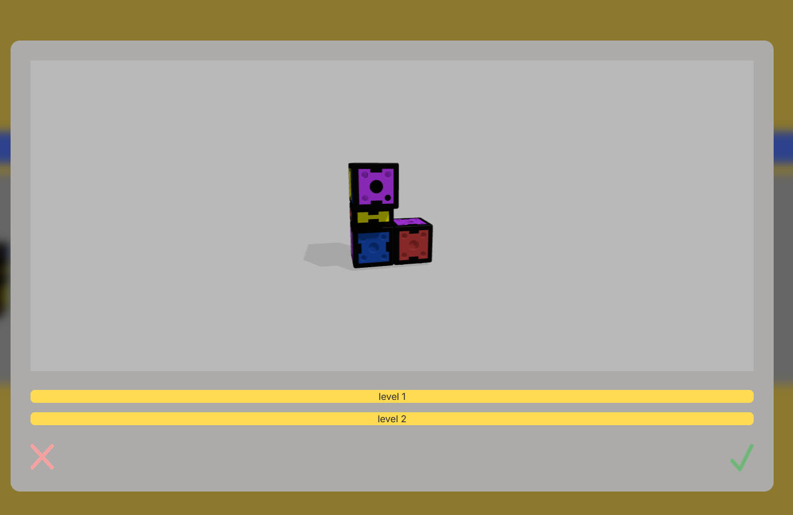
thesis/figures/preview.png
