elsp02/cubes-platformIO/thesis/figures/probrick2.jpg

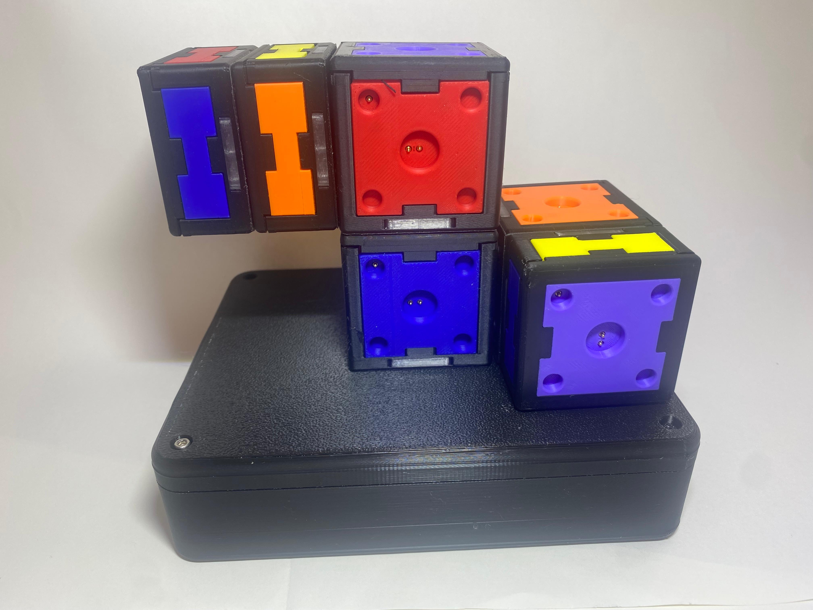
thesis/figures/probrick2.jpg
