elsp02/cubes-platformIO/thesis/figures/probrick.jpg

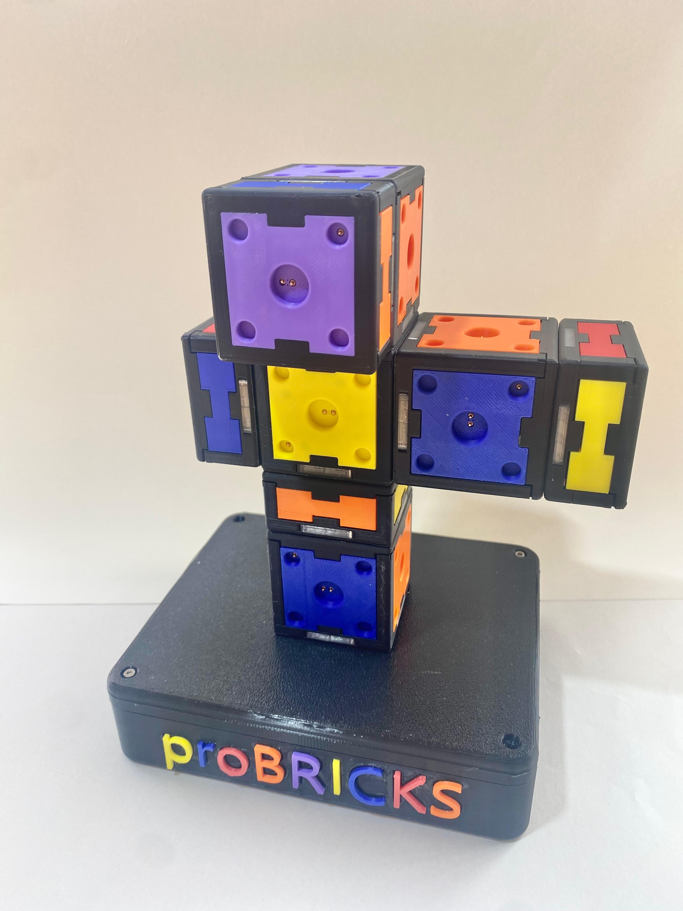
thesis/figures/probrick.jpg
