elsp02/cubes-platformIO/thesis/figures/quadrat@3x.png

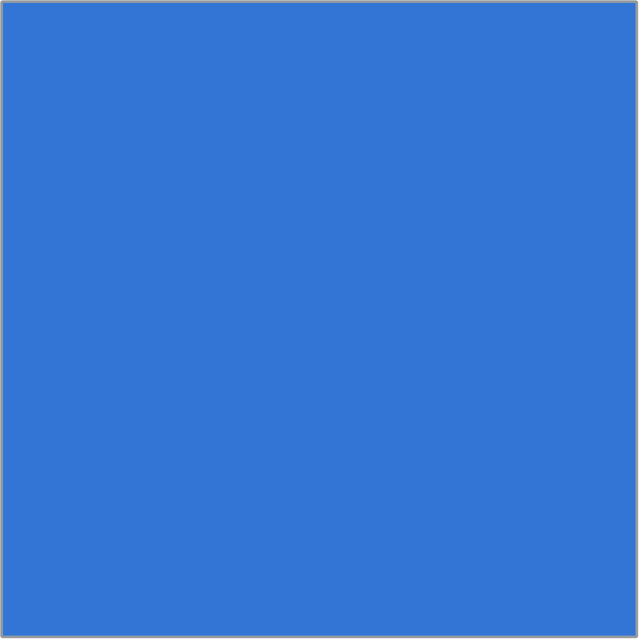
thesis/figures/quadrat@3x.png
