elsp02/cubes-platformIO/thesis/figures/rechteck_hoch@3x.png

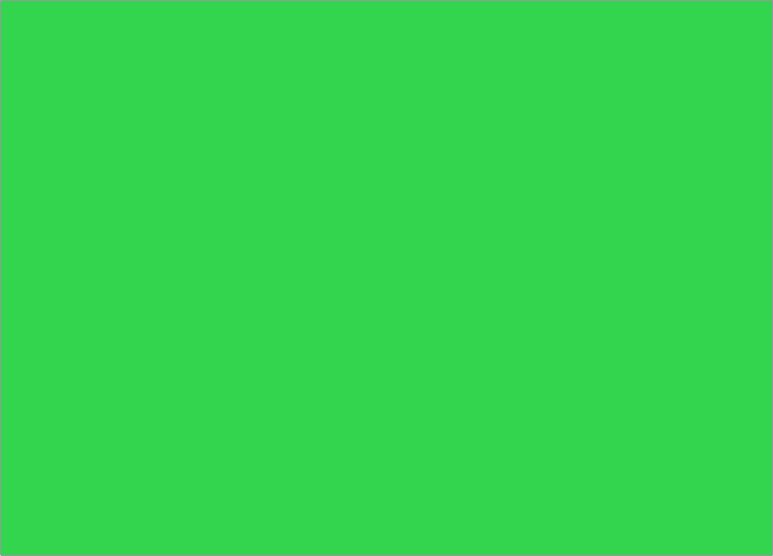
thesis/figures/rechteck_hoch@3x.png
