elsp02/cubes-platformIO/thesis/figures/related-work@3x.png

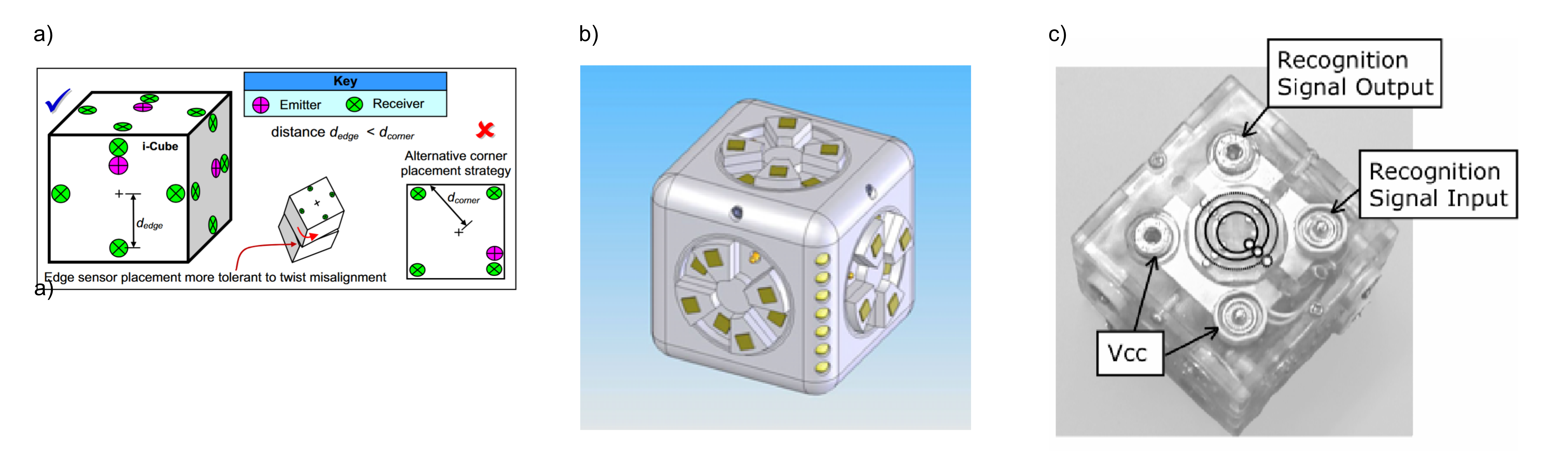
thesis/figures/related-work@3x.png
