elsp02/cubes-platformIO/thesis/figures/roblock.png

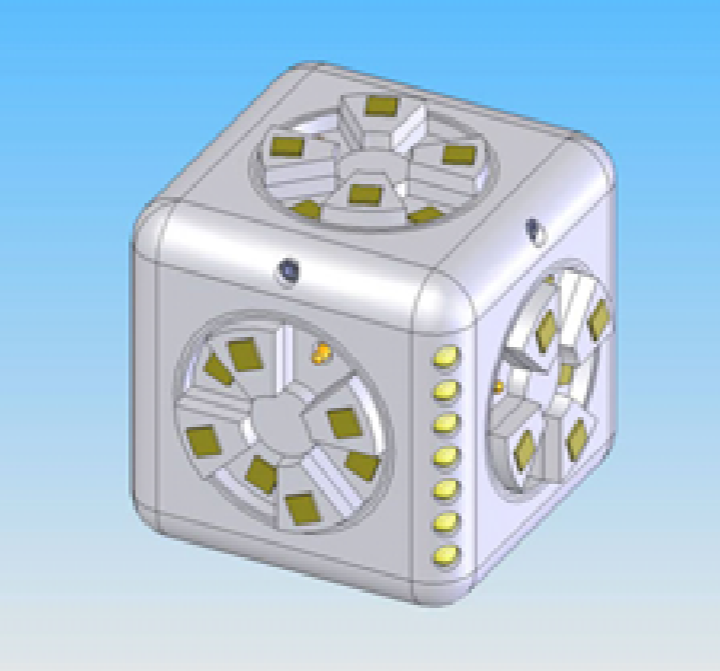
thesis/figures/roblock.png
