elsp02/cubes-platformIO/thesis/figures/smashed-exploded.jpg

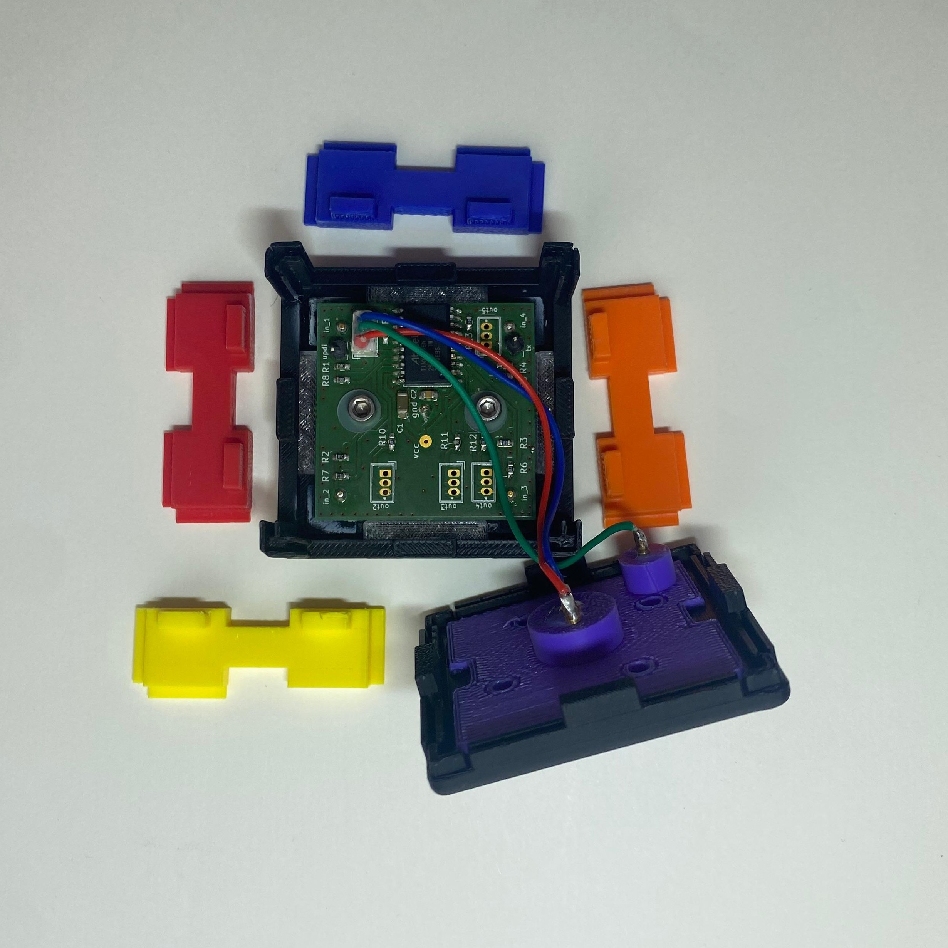
thesis/figures/smashed-exploded.jpg
