elsp02/cubes-platformIO/thesis/figures/smashed_brick.png

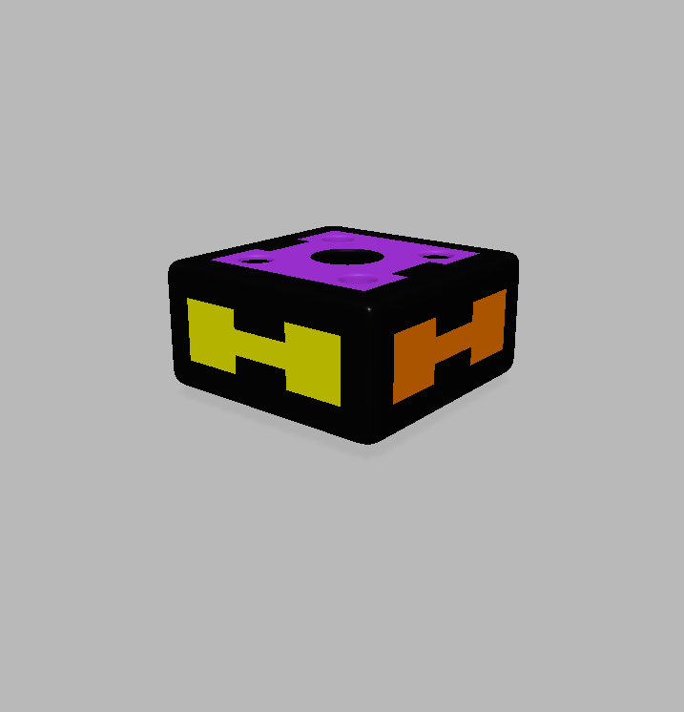
thesis/figures/smashed_brick.png
