elsp02/cubes-platformIO/thesis/figures/smashed_brick_physisch.jpg

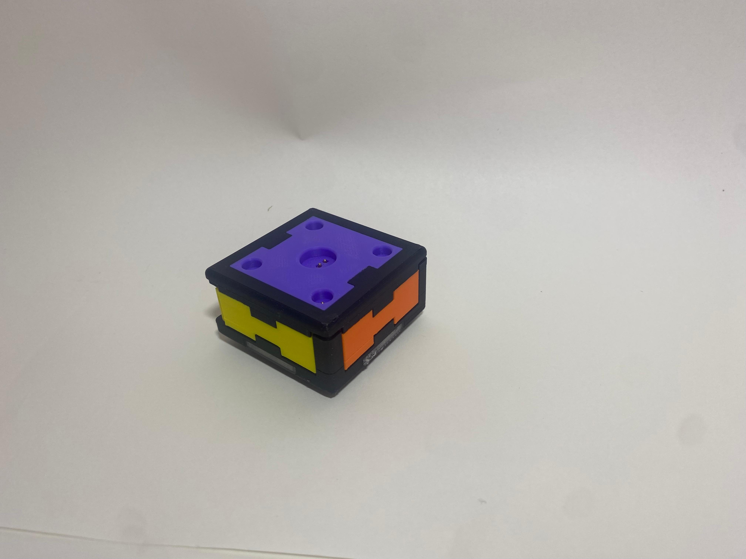
thesis/figures/smashed_brick_physisch.jpg
