elsp02/cubes-platformIO/thesis/figures/target-selection.png

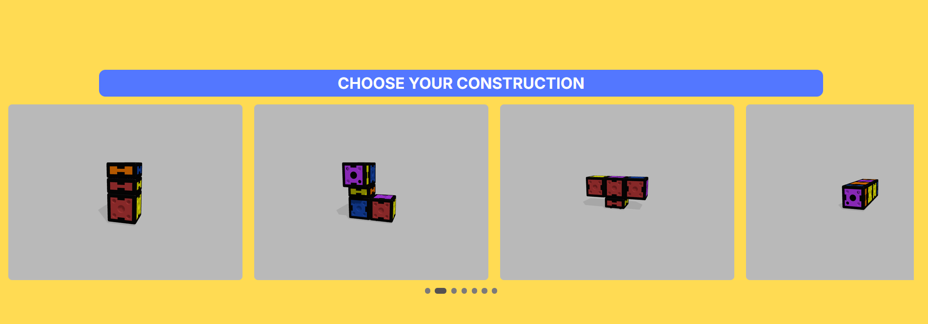
thesis/figures/target-selection.png
