elsp02/cubes-platformIO/thesis/figures/target.png

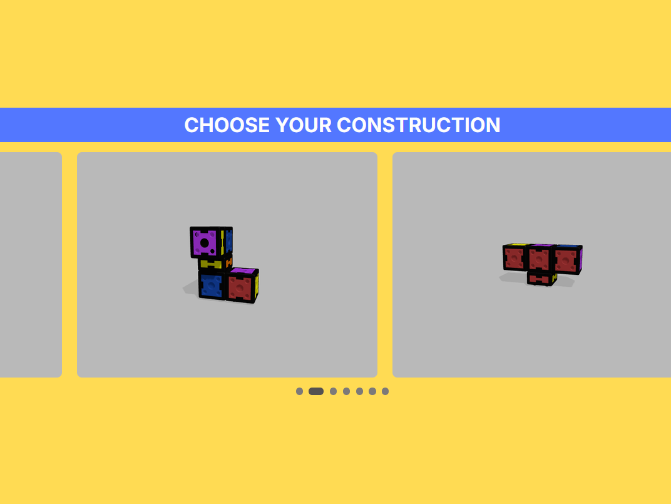
thesis/figures/target.png
