elsp02/cubes-platformIO/thesis/figures/token-constraint-physical-syntax-v2.png

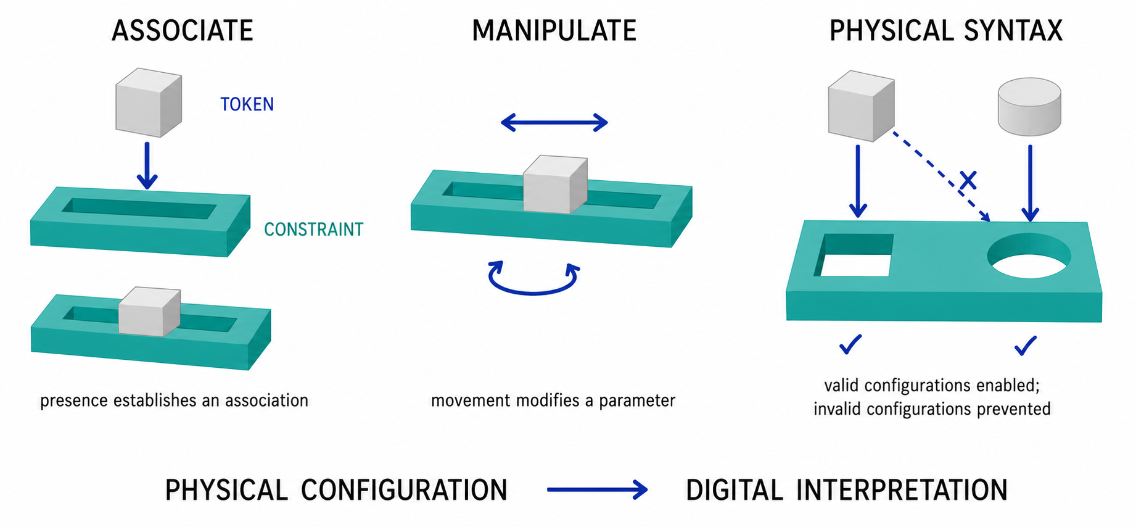
thesis/figures/token-constraint-physical-syntax-v2.png
