elsp02/cubes-platformIO/thesis/figures/token-constraint-physical-syntax.png

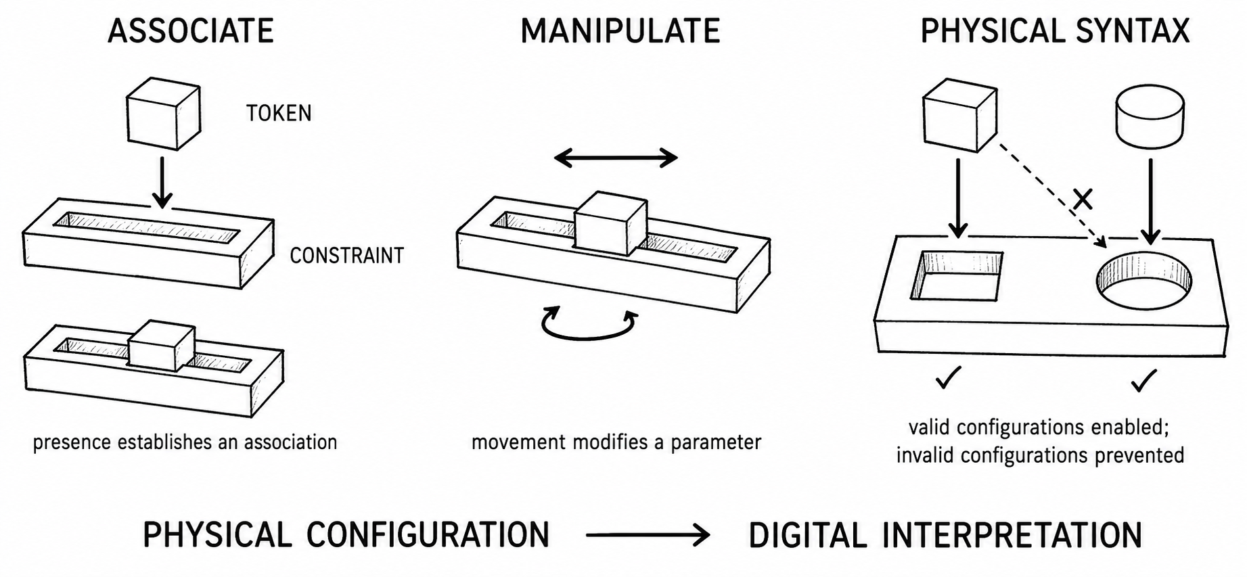
thesis/figures/token-constraint-physical-syntax.png
