elsp02/cubes-platformIO/thesis/figures/tree@3x.png

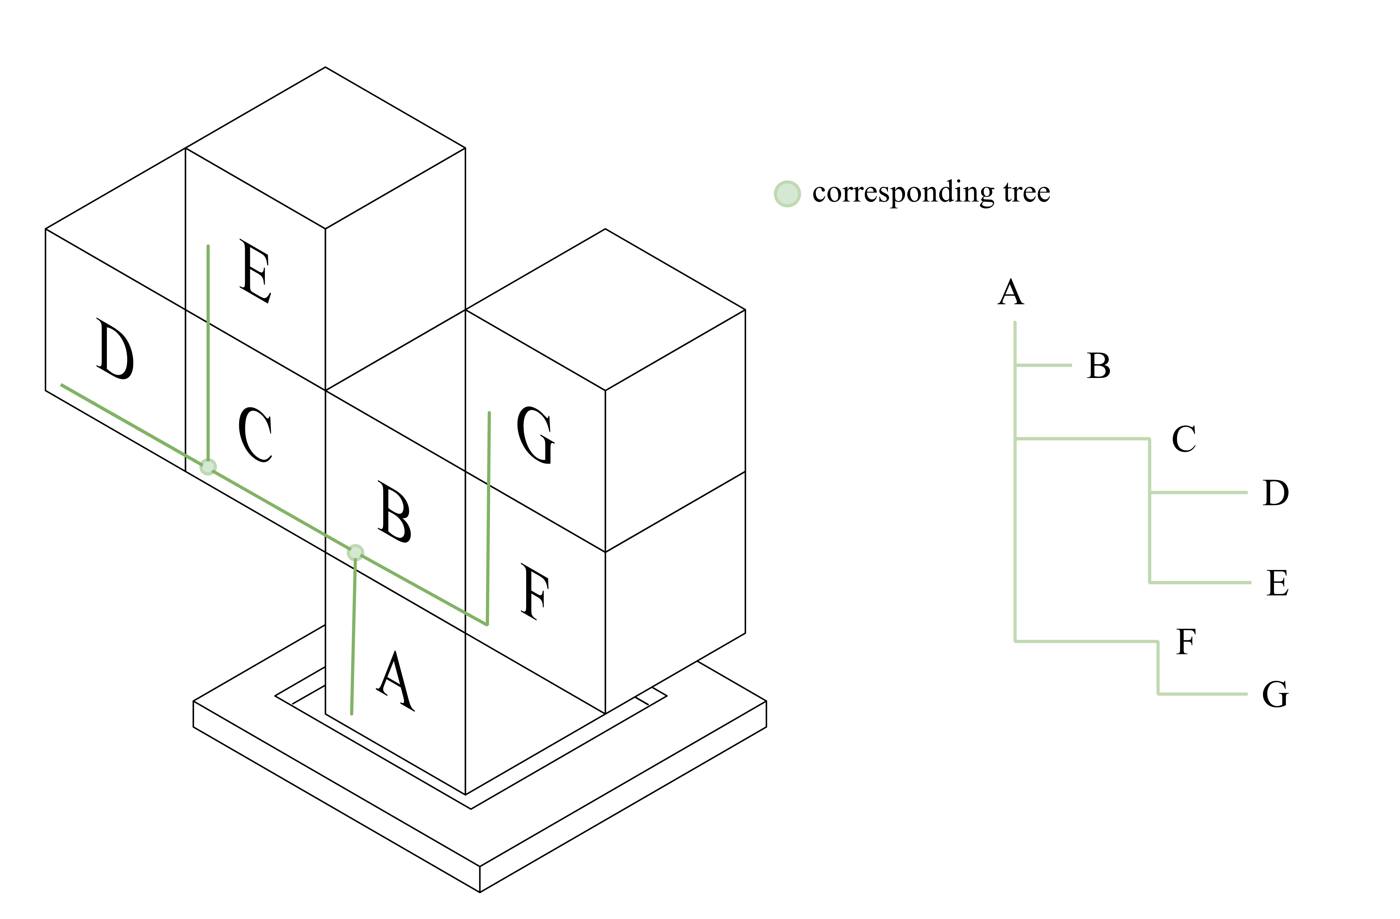
thesis/figures/tree@3x.png
