elsp02/cubes-platformIO/hardware/pcb_files/baseplate/14-09-26_baseplate_BOM_total.xlsx

Sheet: baseplate_circuit_diagram
Reference | Qty | Value | Footprint | Datasheet
C2 | 1 | 100nF | Capacitor_SMD:C_0805_2012Metric_Pad1.18x1.45mm_HandSolder
J1-PC-Interface1 | 1 | - | Connector_PinHeader_2.54mm:PinHeader_1x04_P2.54mm_Vertical | https://www.we-online.com/components/products/datasheet/61300311821.pdf
J2-VCC1 | 1 | VCC | Connector_PinSocket_2.54mm:PinSocket_1x01_P2.54mm_Vertical | https://www.we-online.com/components/products/datasheet/61300111121.pdf
J3 | 1 | DATA_OUT1_for_1_Wire_Communication | Connector_PinHeader_2.54mm:PinHeader_1x03_P2.54mm_Vertical | https://www.we-online.com/components/products/datasheet/61300311821.pdf
R1 | 1 | 33 | Resistor_SMD:R_0603_1608Metric_Pad0.98x0.95mm_HandSolder
U1 | 1 | ATtiny1616-S | Package_SO:SOIC-20W_7.5x12.8mm_P1.27mm | http://ww1.microchip.com/downloads/en/DeviceDoc/ATtiny3216_ATtiny1616-data-sheet-40001997B.pdf

Sheet: baseplate_BOM
Reference | Qty | Value | DNP | Exclude from BOM | Exclude from Board | Footprint | Datasheet
C2 | 1 | 100nF |  |  |  | Capacitor_SMD:C_0805_2012Metric_Pad1.18x1.45mm_HandSolder
J1-PC-Interface? | 1
J2-VCC? | 1 | PC Interface?
J3 | 1 | DATA_OUT1_for_1_Wire_Communication
R1 | 1 | 33
U1 | 1 | ATtiny1616-S |  |  |  | Package_SO:SOIC-20W_7.5x12.8mm_P1.27mm | http://ww1.microchip.com/downloads/en/DeviceDoc/ATtiny3216_ATtiny1616-data-sheet-40001997B.pdf
