elsp02/cubes-platformIO/hardware/pcb_files/brick/brick_BOM.csv

Reference | Qty | Value | DNP | Exclude from BOM | Exclude from Board | Footprint | Datasheet
C1 | 1 | 100uF |  |  |  | Capacitor_SMD:C_1206_3216Metric_Pad1.33x1.80mm_HandSolder
C2,C3,C4,C5,C6 | 5 | 100nF |  |  |  | Capacitor_SMD:C_0805_2012Metric_Pad1.18x1.45mm_HandSolder
D1,D2,D3,D4 | 4 | grb |  |  |  | ICLED_SMD_Wurth:U_Wurth_WL-ICLED_1313210530000 | https://cdn.sparkfun.com/datasheets/Components/LED/COM-12877.pdf
J1 | 1 | UPDI |  |  |  | Connector_PinSocket_2.54mm:PinSocket_1x01_P2.54mm_Vertical
J2 | 1 | TX |  |  |  | Connector_PinSocket_2.54mm:PinSocket_1x01_P2.54mm_Vertical
J_GND1 | 1 | GND |  |  |  | BA_footprint_Library:pogo_pad_IN
J_IN1 | 1 | DATA_IN1 |  |  |  | BA_footprint_Library:pogo_pad_IN
J_IN2 | 1 | DATA_IN2 |  |  |  | BA_footprint_Library:pogo_pad_IN
J_IN3 | 1 | DATA_IN3 |  |  |  | BA_footprint_Library:pogo_pad_IN
J_IN4 | 1 | DATA_IN4 |  |  |  | BA_footprint_Library:pogo_pad_IN
J_OUT1 | 1 | DATA_OUT1_for_1_Wire_Communication2 |  |  |  | BA_footprint_Library:Wuerth_WR-WTB_64800311622_1x03_P1.50mm_Vertical
J_OUT2 | 1 | DATA_OUT2_for_1_Wire_Communication2 |  |  |  | BA_footprint_Library:Wuerth_WR-WTB_64800311622_1x03_P1.50mm_Vertical
J_OUT3 | 1 | DATA_OUT3_for_1_Wire_Communication2 |  |  |  | BA_footprint_Library:Wuerth_WR-WTB_64800311622_1x03_P1.50mm_Vertical
J_OUT5 | 1 | DATA_OUT5_for_1_Wire_Communication2 |  |  |  | BA_footprint_Library:Wuerth_WR-WTB_64800311622_1x03_P1.50mm_Vertical
J_OUT_4 | 1 | DATA_OUT4_for_1_Wire_Communication2 |  |  |  | BA_footprint_Library:Wuerth_WR-WTB_64800311622_1x03_P1.50mm_Vertical
J_VCC1 | 1 | VCC_IN |  |  |  | BA_footprint_Library:pogo_pin_magnet
J_VCC2 | 1 | VCC_IN_smd |  |  |  | BA_footprint_Library:pogo_pin_smd
R1,R2,R3,R4 | 4 | 10k |  |  |  | Resistor_SMD:R_0603_1608Metric_Pad0.98x0.95mm_HandSolder
R5,R6,R7,R8,R9,R10,R11,R12,R13,R14,R15,R16,R17 | 13 | 33 |  |  |  | Resistor_SMD:R_0603_1608Metric_Pad0.98x0.95mm_HandSolder
U1 | 1 | ATtiny1616-S |  |  |  | Package_SO:SOIC-20W_7.5x12.8mm_P1.27mm | http://ww1.microchip.com/downloads/en/DeviceDoc/ATtiny3216_ATtiny1616-data-sheet-40001997B.pdf
