elsp02/cubes-platformIO/hardware/pcb_files/brick/brick_kicad/production/bom.csv

Designator | Footprint | Quantity | Value | LCSC Part #
AT1616 | SOIC-20W_7.5x12.8mm_P1.27mm | 1 | ATtiny1616-S
C1 | 0805 | 1 | 100uF
C2 | 0805 | 1 | 100nF
D1, D2, D3, D4 | 0603 | 4 | LED_Small
J_GND1 | pogo_pad_IN | 1 | GND
J_IN1 | pogo_pad_IN | 1 | DATA_IN1
J_IN2 | pogo_pad_IN | 1 | DATA_IN2
J_IN3 | pogo_pad_IN | 1 | DATA_IN3
J_IN4 | pogo_pad_IN | 1 | DATA_IN4
J_OUT1 | PinHeader_1x03_P2.54mm_Vertical | 1 | DATA_OUT1_for_1_Wire_Communication2
J_OUT2 | PinHeader_1x03_P2.54mm_Vertical | 1 | DATA_OUT2_for_1_Wire_Communication2
J_OUT3 | PinHeader_1x03_P2.54mm_Vertical | 1 | DATA_OUT3_for_1_Wire_Communication2
J_OUT5 | PinHeader_1x03_P2.54mm_Vertical | 1 | DATA_OUT5_for_1_Wire_Communication2
J_OUT_4 | PinHeader_1x03_P2.54mm_Vertical | 1 | DATA_OUT4_for_1_Wire_Communication2
J_VCC1 | pogo_pin_magnet | 1 | VCC_IN
R1, R2, R3, R4 | 0603 | 4 | 10k
R10, R11, R12, R13, R5, R6, R7, R8, R9 | 0603 | 9 | 33
R14, R15, R16, R17 | 0603 | 4 | R
