elsp02/cubes-platformIO/hardware/CAD_files/baseplate_files/baseplate-deckel_17-09_v4.stp

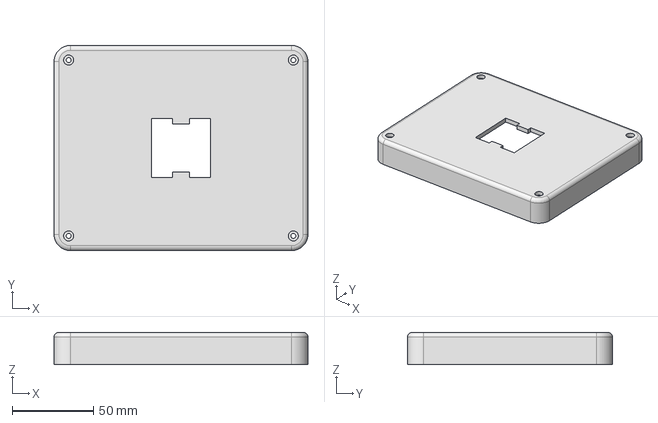
[picture p62: CAD file, 2026-09-21]
hardware/CAD_files/baseplate_files/baseplate-deckel_17-09_v4.stp
156.0 x 126.0 x 19.9 mm
