elsp02/cubes-platformIO/hardware/CAD_files/brick_files/both/magnethalter_23-09-26.stp

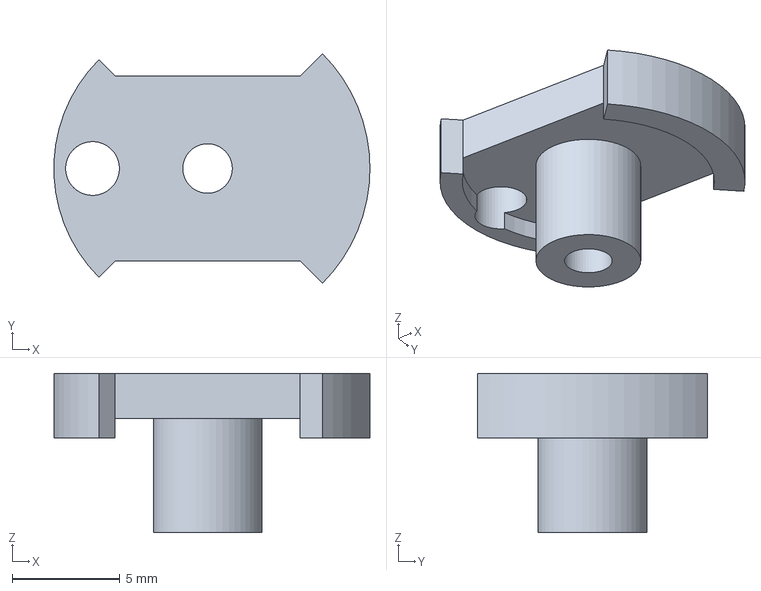
[picture p63: CAD file, 2026-09-27]
hardware/CAD_files/brick_files/both/magnethalter_23-09-26.stp
14.7 x 10.7 x 7.40 mm
