elsp02/cubes-platformIO/hardware/CAD_files/brick_files/cube/wand_andere-orientierung_29-08.stp

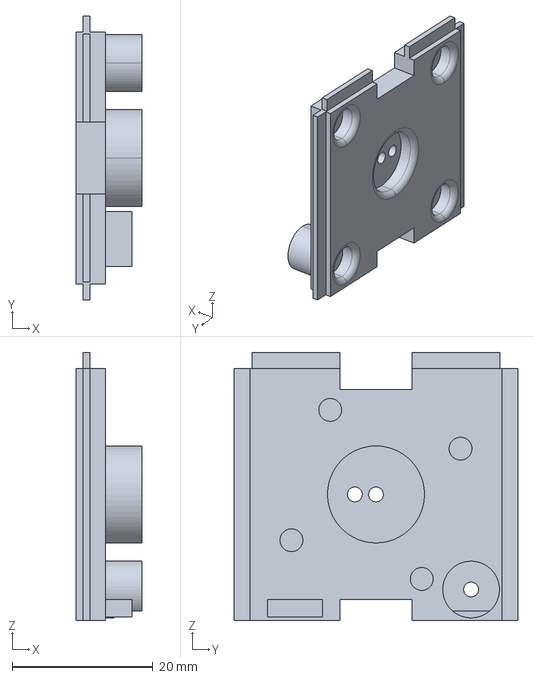
[picture p64: CAD file, 2026-09-05]
hardware/CAD_files/brick_files/cube/wand_andere-orientierung_29-08.stp
9.43 x 40.3 x 38.1 mm
