elsp02/cubes-platformIO/hardware/CAD_files/brick_files/smashed/rahmen_27_07_geteilt_rahmen_transparent.stp

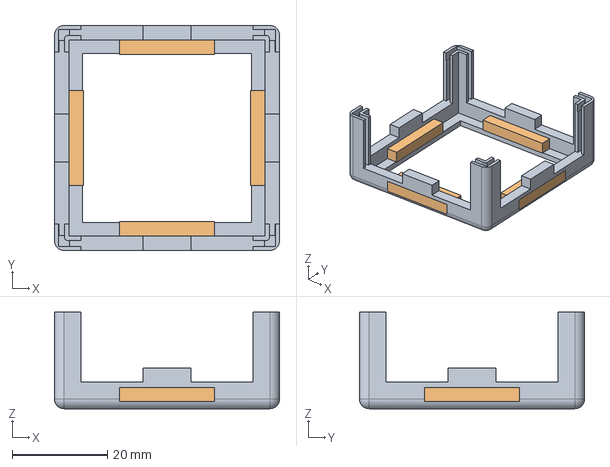
[picture p65: CAD file, 2026-09-05]
hardware/CAD_files/brick_files/smashed/rahmen_27_07_geteilt_rahmen_transparent.stp
47.2 x 47.2 x 20.2 mm
