elsp02/cubes-platformIO/hardware/pcb_files/brick/15-09-26_brick_pcb_v4.step

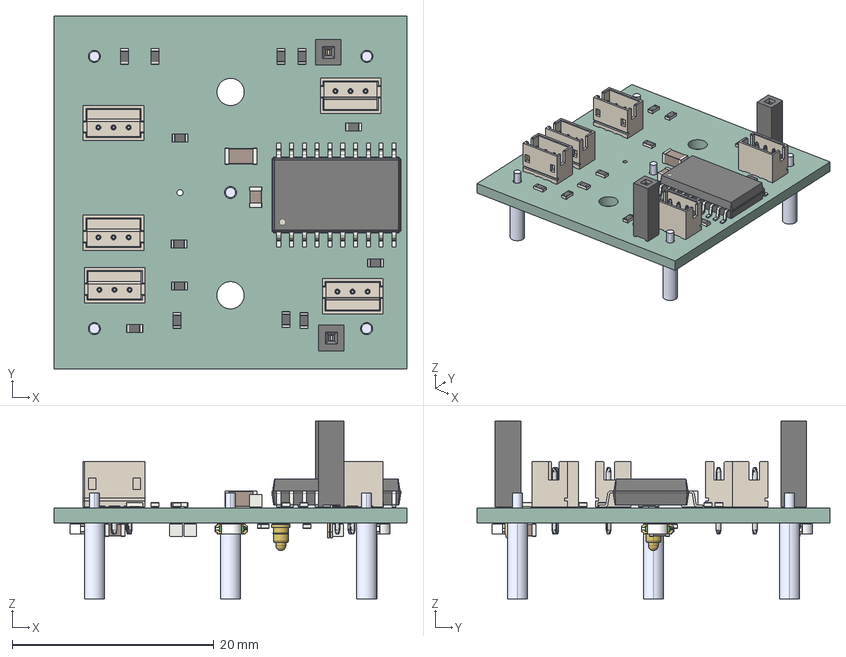
[picture p66: CAD file, 2026-09-27]
hardware/pcb_files/brick/15-09-26_brick_pcb_v4.step
35.0 x 35.0 x 17.6 mm
PinSocket_1x01_P2.54mm_Vertical x 2
R_0603_1608Metric x 17
6480xx11622_PIN x 15
6480xx11622_PIN2 x 15
C_1206_3216Metric
SOIC-20W_7.5x12.8mm_P1.27mm
C_0805_2012Metric x 5
Same_Sky_CPG-04-N-B x 5
Contacts x 48
Resin x 4
Same_Sky_CPG-64-SMT-B
brick_kicad_PCB
