elsp02/cubes-platformIO/hardware/pcb_files/connectors_WR-WTB_1.50/connectors_WR-WTB-1.5_064800311622 (rev1).stp

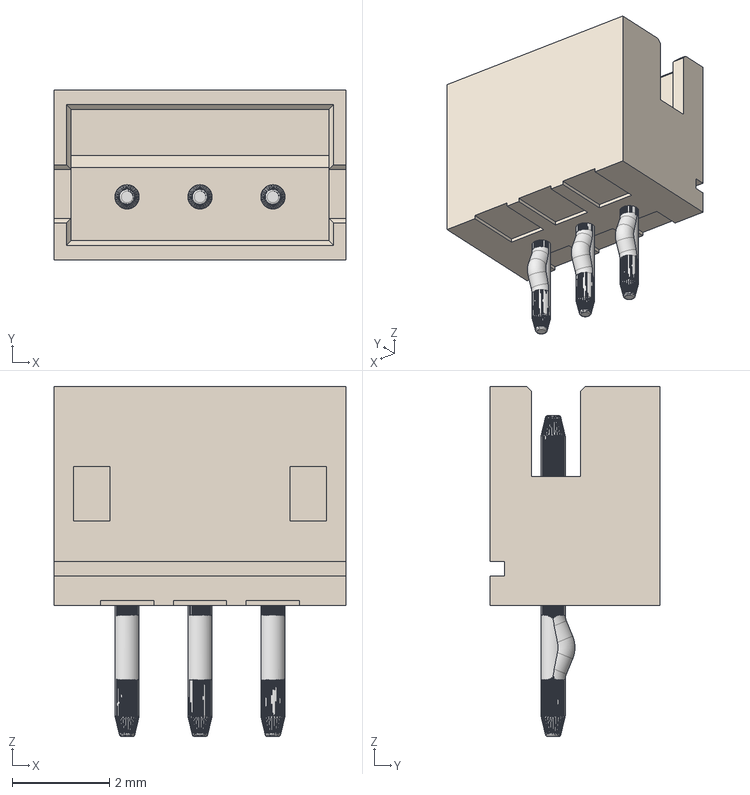
[picture p68: CAD file, 2026-08-31]
hardware/pcb_files/connectors_WR-WTB_1.50/connectors_WR-WTB-1.5_064800311622 (rev1).stp
6.00 x 3.50 x 7.20 mm
6480xx11622_PIN x 3
6480xx11622_PIN2 x 3
