elsp02/cubes-platformIO/hardware/pcb_files/female_pogo_pin_LIB_CPG-04-N-B/CPG-04-N-B.stp

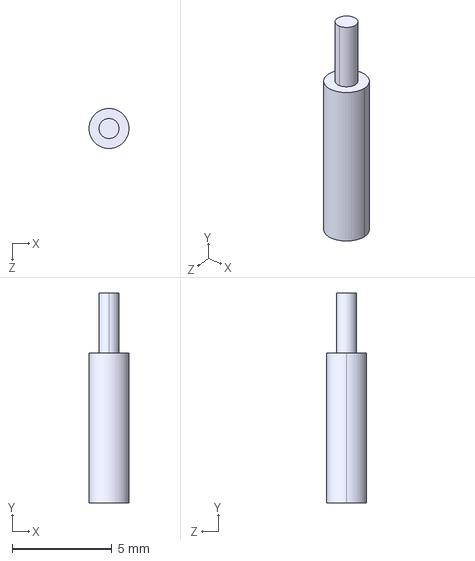
[picture p69: CAD file, 2026-08-31]
hardware/pcb_files/female_pogo_pin_LIB_CPG-04-N-B/CPG-04-N-B.stp
2.00 x 10.5 x 2.00 mm
