elsp02/cubes-platformIO/hardware/pcb_files/smd_pogo_pin_LIB_CPG-64-SMT-B/CPG-64-SMT-B.stp

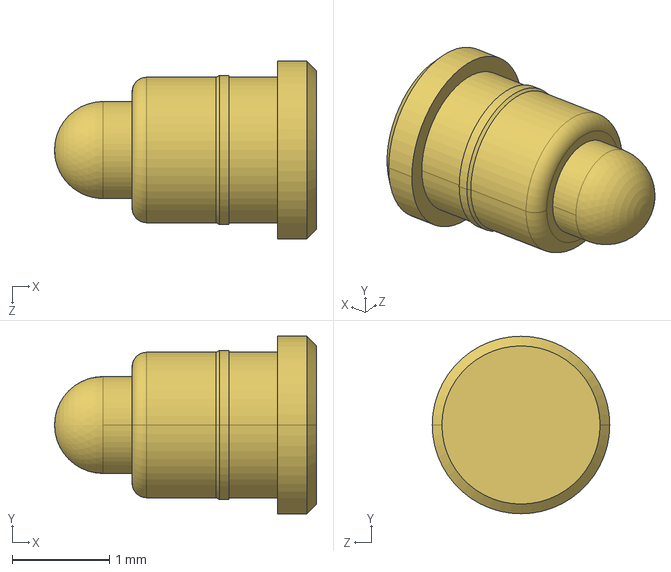
[picture p70: CAD file, 2026-08-31]
hardware/pcb_files/smd_pogo_pin_LIB_CPG-64-SMT-B/CPG-64-SMT-B.stp
2.70 x 1.83 x 1.83 mm
