elsp02/cubes-platformIO/hardware/pcb_files/solder_cup_pogo_pin_LIB_0933-0-15-20-75-14-11-0(1)/0933-0-15-20-75-14-11-0.stp

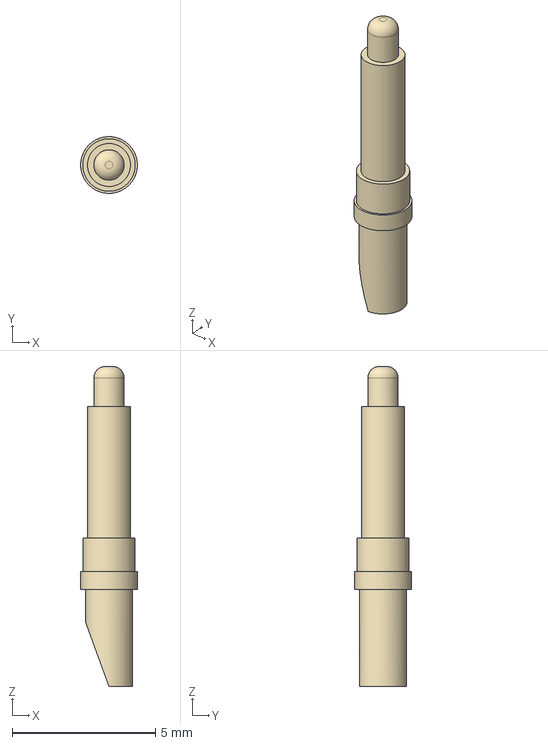
[picture p71: CAD file, 2026-08-31]
hardware/pcb_files/solder_cup_pogo_pin_LIB_0933-0-15-20-75-14-11-0(1)/0933-0-15-20-75-14-11-0.stp
1.98 x 1.98 x 11.2 mm
