elsp02/cubes-platformIO/hardware/pcb_files/WL-ICLED_wuerth/WL-ICLED_1313210530000.stp

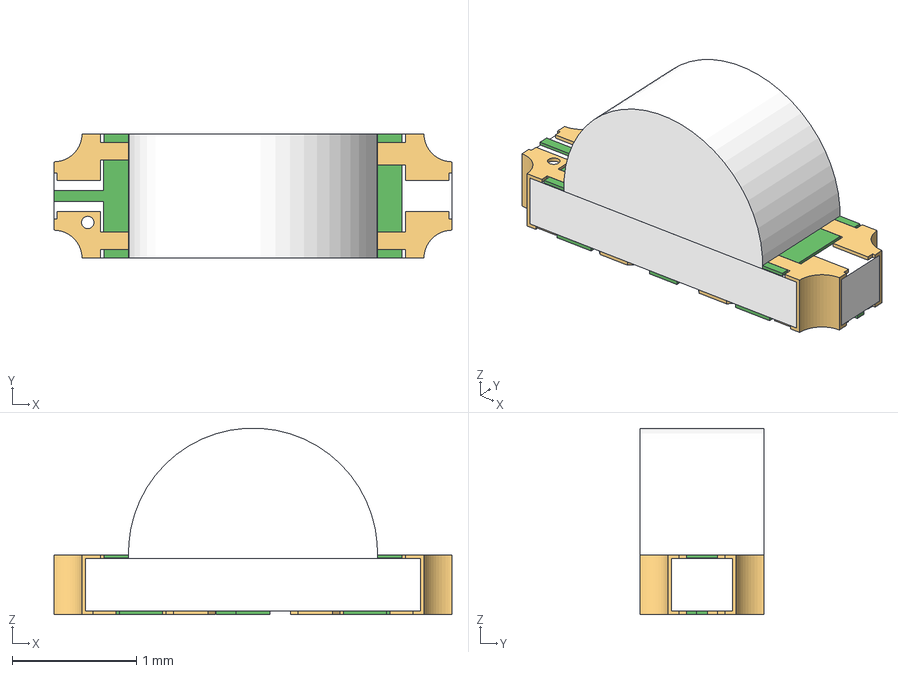
[picture p72: CAD file, 2026-09-18]
hardware/pcb_files/WL-ICLED_wuerth/WL-ICLED_1313210530000.stp
3.20 x 1.00 x 1.50 mm
Contacts x 12
Resin
