elsp02/cubes-platformIO/hardware/CAD_files/baseplate_files/updi_halter.stp

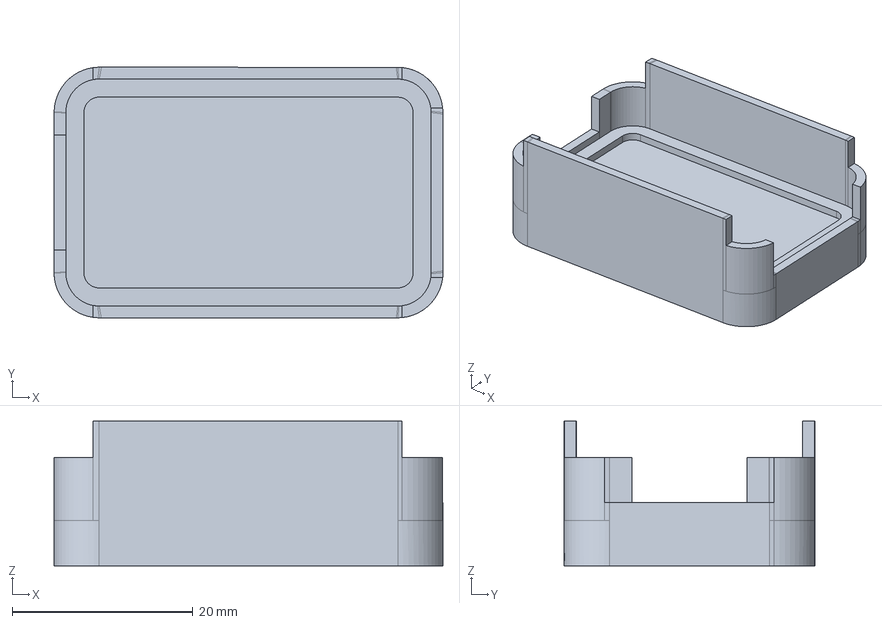
[picture p73: CAD file, 2026-09-07]
hardware/CAD_files/baseplate_files/updi_halter.stp
43.0 x 27.7 x 16.0 mm
