elsp02/cubes-platformIO/hardware/CAD_files/brick_files/both/baseplate-deckel_17-09.stp

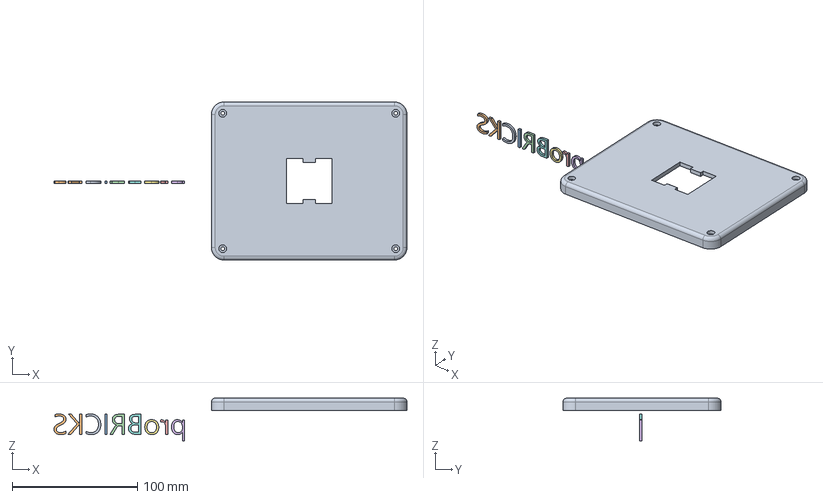
[picture p74: CAD file, 2026-09-18]
hardware/CAD_files/brick_files/both/baseplate-deckel_17-09.stp
281.5 x 126.0 x 34.1 mm
