elsp02/cubes-platformIO/hardware/CAD_files/brick_files/cube/wand_22.07.stp

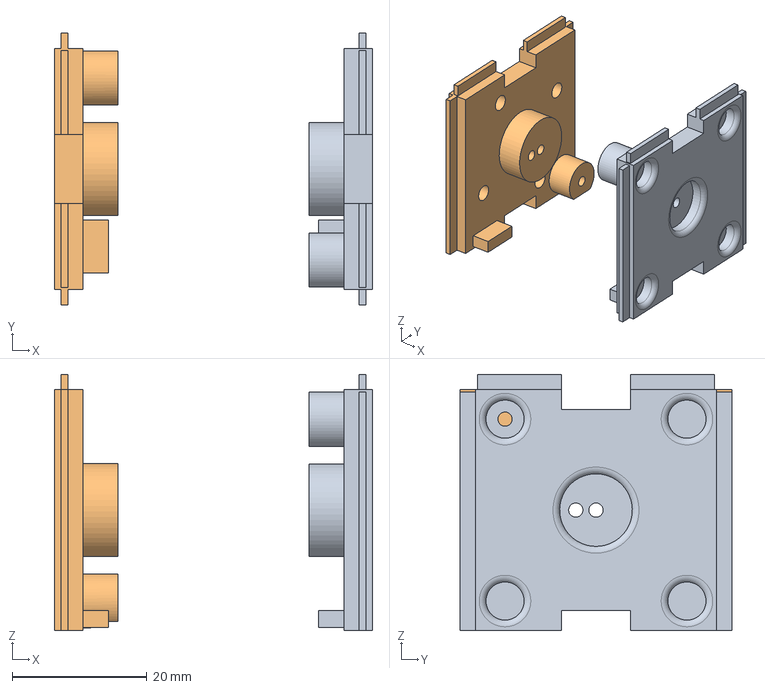
[picture p75: CAD file, 2026-09-05]
hardware/CAD_files/brick_files/cube/wand_22.07.stp
47.2 x 40.3 x 38.1 mm
