elsp02/cubes-platformIO/hardware/CAD_files/brick_files/smashed/wand_21_07.stp

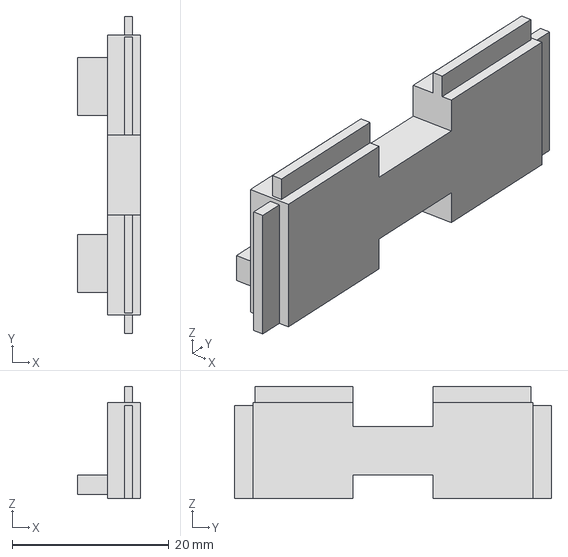
[picture p76: CAD file, 2026-09-05]
hardware/CAD_files/brick_files/smashed/wand_21_07.stp
8.00 x 40.5 x 14.3 mm
