elsp02/cubes-platformIO/hardware/CAD_files/baseplate_files/baseplate_deckel.stp

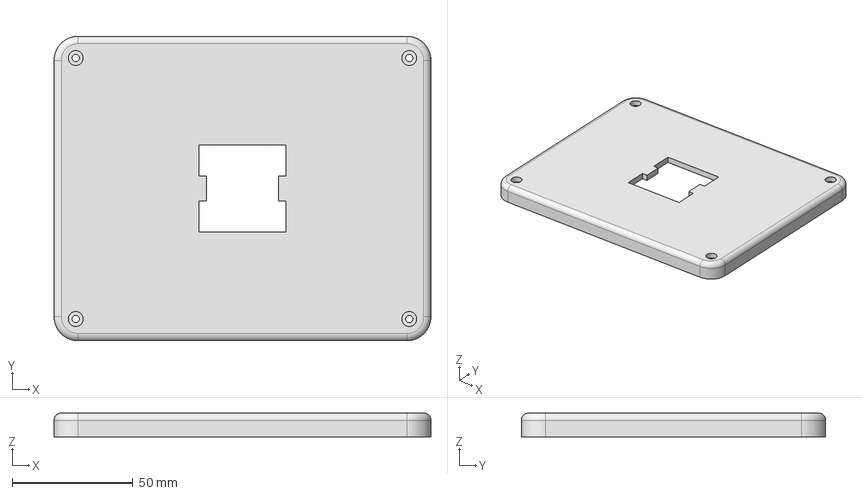
[picture p77: CAD file, 2026-09-07]
hardware/CAD_files/baseplate_files/baseplate_deckel.stp
156.0 x 126.0 x 9.90 mm
