elsp02/cubes-platformIO/hardware/CAD_files/brick_files/both/deckel_26-07_geteilt_rahmen.stp

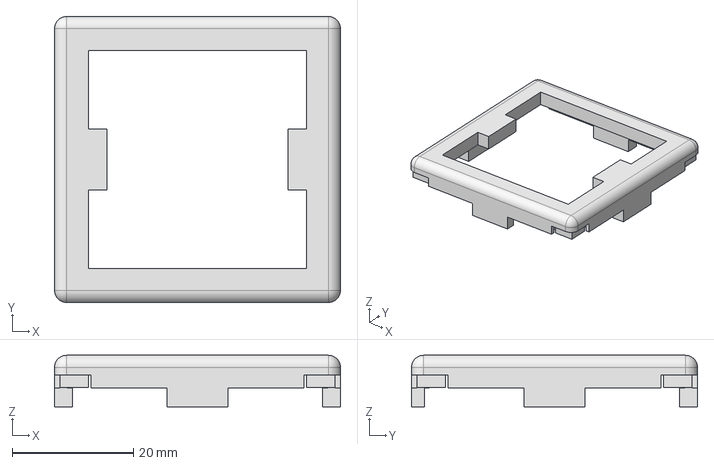
[picture p78: CAD file, 2026-09-05]
hardware/CAD_files/brick_files/both/deckel_26-07_geteilt_rahmen.stp
47.2 x 47.2 x 8.50 mm
