elsp02/cubes-platformIO/hardware/CAD_files/brick_files/cube/rahmen_27_07_geteilt_transparenz.stp

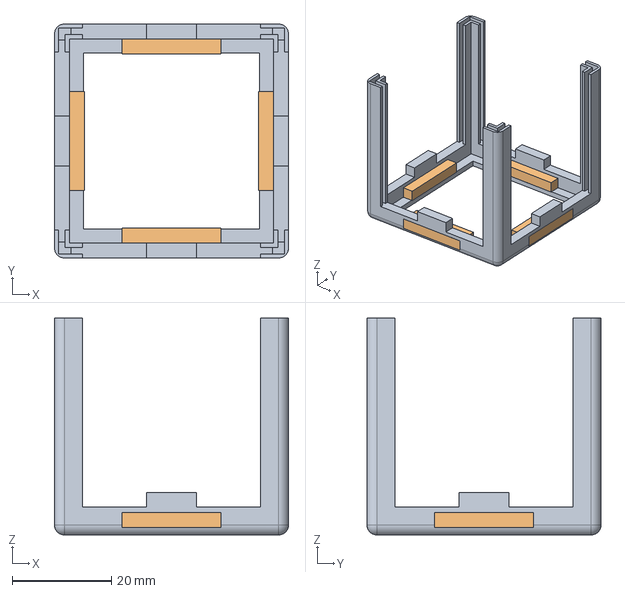
[picture p79: CAD file, 2026-09-05]
hardware/CAD_files/brick_files/cube/rahmen_27_07_geteilt_transparenz.stp
47.2 x 47.2 x 43.8 mm
