elsp02/cubes-platformIO/hardware/CAD_files/baseplate_files/baseplate_28_07.stp

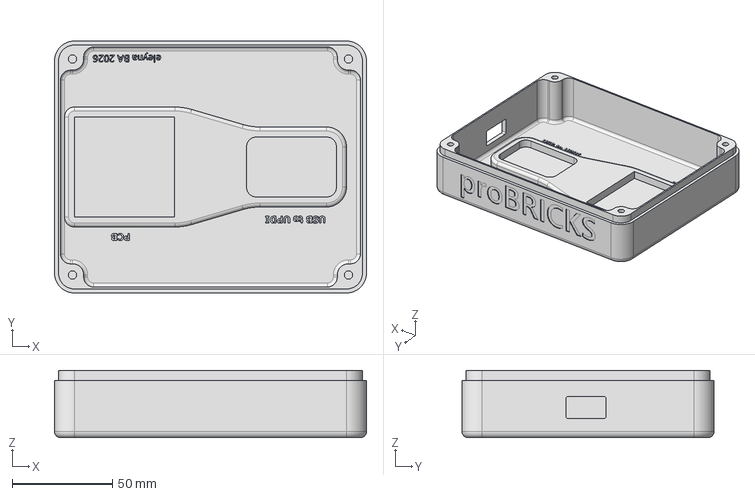
[picture p80: CAD file, 2026-09-07]
hardware/CAD_files/baseplate_files/baseplate_28_07.stp
156.0 x 126.0 x 33.6 mm
