elsp02/cubes-platformIO/hardware/CAD_files/brick_files/both/rahmen_28_07_geteilt_wand.stp

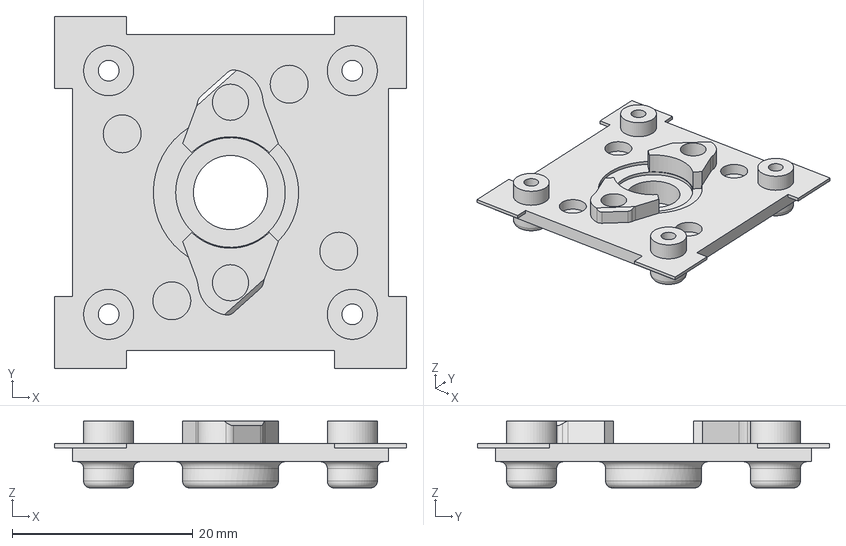
[picture p81: CAD file, 2026-09-05]
hardware/CAD_files/brick_files/both/rahmen_28_07_geteilt_wand.stp
39.0 x 39.0 x 7.40 mm
