elsp02/cubes-platformIO/hardware/CAD_files/brick_files/both/deckel_27-07_geteilt_wand.stp

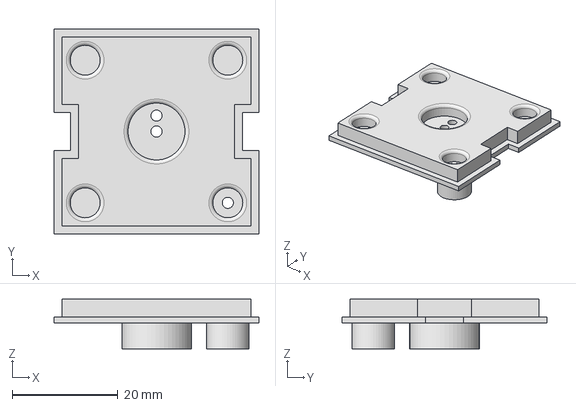
[picture p82: CAD file, 2026-09-05]
hardware/CAD_files/brick_files/both/deckel_27-07_geteilt_wand.stp
38.8 x 38.8 x 9.43 mm
