elsp02/cubes-platformIO/(list of files, cad)

Other CAD files:
hardware/CAD_files/brick_files/both/magnethalter_23-09-26/magnethalter_23-09-26/magnethalter_23-09-26.ipt
hardware/pcb_files/brick/15-09-26_brick_pcb_v4/15-09-26_brick_pcb_v4/15-09-26_brick_pcb_v4.iam
hardware/pcb_files/brick/15-09-26_brick_pcb_v4/15-09-26_brick_pcb_v4/64800311622.ipt
hardware/pcb_files/brick/15-09-26_brick_pcb_v4/15-09-26_brick_pcb_v4/6480xx11622.iam
hardware/pcb_files/brick/15-09-26_brick_pcb_v4/15-09-26_brick_pcb_v4/6480xx11622_PIN.ipt
hardware/pcb_files/brick/15-09-26_brick_pcb_v4/15-09-26_brick_pcb_v4/6480xx11622_PIN2.ipt
hardware/pcb_files/brick/15-09-26_brick_pcb_v4/15-09-26_brick_pcb_v4/Assem1.iam
hardware/pcb_files/brick/15-09-26_brick_pcb_v4/15-09-26_brick_pcb_v4/Body.ipt
hardware/pcb_files/brick/15-09-26_brick_pcb_v4/15-09-26_brick_pcb_v4/CPG-04-N-B.iam
hardware/pcb_files/brick/15-09-26_brick_pcb_v4/15-09-26_brick_pcb_v4/CPG-64-SMT-B.iam
hardware/pcb_files/brick/15-09-26_brick_pcb_v4/15-09-26_brick_pcb_v4/C_0805_2012Metric.iam
hardware/pcb_files/brick/15-09-26_brick_pcb_v4/15-09-26_brick_pcb_v4/C_0805_2012Metric.ipt
hardware/pcb_files/brick/15-09-26_brick_pcb_v4/15-09-26_brick_pcb_v4/C_1206_3216Metric.iam
hardware/pcb_files/brick/15-09-26_brick_pcb_v4/15-09-26_brick_pcb_v4/C_1206_3216Metric.ipt
hardware/pcb_files/brick/15-09-26_brick_pcb_v4/15-09-26_brick_pcb_v4/Contacts.ipt
hardware/pcb_files/brick/15-09-26_brick_pcb_v4/15-09-26_brick_pcb_v4/Contacts_1.ipt
hardware/pcb_files/brick/15-09-26_brick_pcb_v4/15-09-26_brick_pcb_v4/Contacts_10.ipt
hardware/pcb_files/brick/15-09-26_brick_pcb_v4/15-09-26_brick_pcb_v4/Contacts_11.ipt
hardware/pcb_files/brick/15-09-26_brick_pcb_v4/15-09-26_brick_pcb_v4/Contacts_2.ipt
hardware/pcb_files/brick/15-09-26_brick_pcb_v4/15-09-26_brick_pcb_v4/Contacts_3.ipt
hardware/pcb_files/brick/15-09-26_brick_pcb_v4/15-09-26_brick_pcb_v4/Contacts_4.ipt
hardware/pcb_files/brick/15-09-26_brick_pcb_v4/15-09-26_brick_pcb_v4/Contacts_5.ipt
hardware/pcb_files/brick/15-09-26_brick_pcb_v4/15-09-26_brick_pcb_v4/Contacts_6.ipt
hardware/pcb_files/brick/15-09-26_brick_pcb_v4/15-09-26_brick_pcb_v4/Contacts_7.ipt
hardware/pcb_files/brick/15-09-26_brick_pcb_v4/15-09-26_brick_pcb_v4/Contacts_8.ipt
hardware/pcb_files/brick/15-09-26_brick_pcb_v4/15-09-26_brick_pcb_v4/Contacts_9.ipt
hardware/pcb_files/brick/15-09-26_brick_pcb_v4/15-09-26_brick_pcb_v4/PinSocket_1x01_P2.54mm_Vertical.iam
hardware/pcb_files/brick/15-09-26_brick_pcb_v4/15-09-26_brick_pcb_v4/PinSocket_1x01_P2.54mm_Vertical.ipt
hardware/pcb_files/brick/15-09-26_brick_pcb_v4/15-09-26_brick_pcb_v4/R_0603_1608Metric.iam
hardware/pcb_files/brick/15-09-26_brick_pcb_v4/15-09-26_brick_pcb_v4/R_0603_1608Metric.ipt
hardware/pcb_files/brick/15-09-26_brick_pcb_v4/15-09-26_brick_pcb_v4/Resin.ipt
hardware/pcb_files/brick/15-09-26_brick_pcb_v4/15-09-26_brick_pcb_v4/SOIC-20W_7.5x12.8mm_P1.27mm.iam
hardware/pcb_files/brick/15-09-26_brick_pcb_v4/15-09-26_brick_pcb_v4/SOIC-20W_7.5x12.8mm_P1.27mm.ipt
hardware/pcb_files/brick/15-09-26_brick_pcb_v4/15-09-26_brick_pcb_v4/Same_Sky_CPG-04-N-B.ipt
hardware/pcb_files/brick/15-09-26_brick_pcb_v4/15-09-26_brick_pcb_v4/Same_Sky_CPG-64-SMT-B.ipt
hardware/pcb_files/brick/15-09-26_brick_pcb_v4/15-09-26_brick_pcb_v4/WL-ICLED_1313210530000.iam
hardware/pcb_files/brick/15-09-26_brick_pcb_v4/15-09-26_brick_pcb_v4/brick_kicad_PCB.ipt
hardware/pcb_files/brick/15-09-26_brick_pcb_v4/15-09-26_brick_pcb_v4/connectors_WR-WTB-1.5_064800311622 (rev1).iam
hardware/pcb_files/solder_cup_pogo_pin_LIB_0933-0-15-20-75-14-11-0(1)/0933-0-15-20-75-14-11-0/3D/0933-0-15-20-75-14-11-0/0933-0-15-20.ipt
hardware/pcb_files/solder_cup_pogo_pin_LIB_0933-0-15-20-75-14-11-0(1)/0933-0-15-20-75-14-11-0/3D/0933-0-15-20-75-14-11-0/OldVersions/0933-0-15-20.0001.ipt
hardware/pcb_files/solder_cup_pogo_pin_LIB_0933-0-15-20-75-14-11-0(1)/0933-0-15-20-75-14-11-0/3D/0933-0-15-20-75-14-11-0/OldVersions/0933-0-15-20.0002.ipt
