elsp02/cubes-platformIO/hardware/CAD_files/3D-print_settings.md

# 3D Printing Settings
- **Printers:** Bambu Lab H2D and H2S
- **Nozzle:** 0.4 mm
- **Support material:** PETG
- **Layer height:** 0.1 mm
- **Wall order:** Outer → inner
