elsp02/cubes-platformIO/tools/threejs_visualization/frontend/test/ideas.md

### ideas
- es soll sich von selber langsam drehen und sobald man einmal berührt hat soll es aufhören
- zuerst ganzes construct und dan nirgendwie ok, dann geht es zu fenster links unten und zegit irgendwie auch imm den aktuellen cube an/bzw die aktuellen (hebt sie hervor) und man kann auf das fenster drauf klicken, dann sieht man links die konstruktion und rechts dreht sich der cube den man grad dran machen soll (vlt noch ein vertgleich, also target cube und actual cube)
- fenster mit wirklich beenden
- fenster mit hast du auseinandergebaut 
- auswahlmöglichekien lego
