elsp02/cubes-platformIO/software/threejs_visualization/frontend/test/img/arrow_left.png

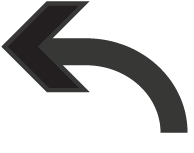
software/threejs_visualization/frontend/test/img/arrow_left.png
