elsp02/cubes-platformIO/software/threejs_visualization/frontend/test/img/pongo_dance.gif

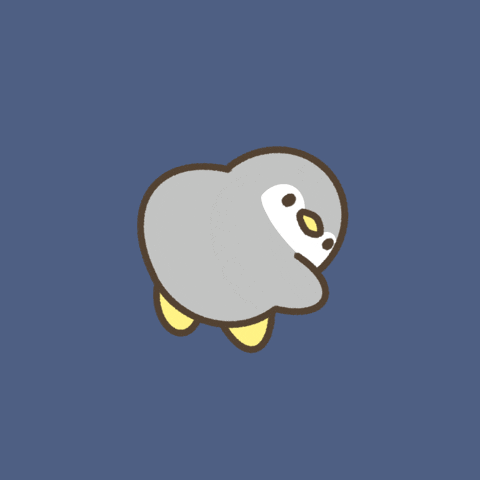
software/threejs_visualization/frontend/test/img/pongo_dance.gif
