elsp02/cubes-platformIO/thesis/Schaltplan.pdf

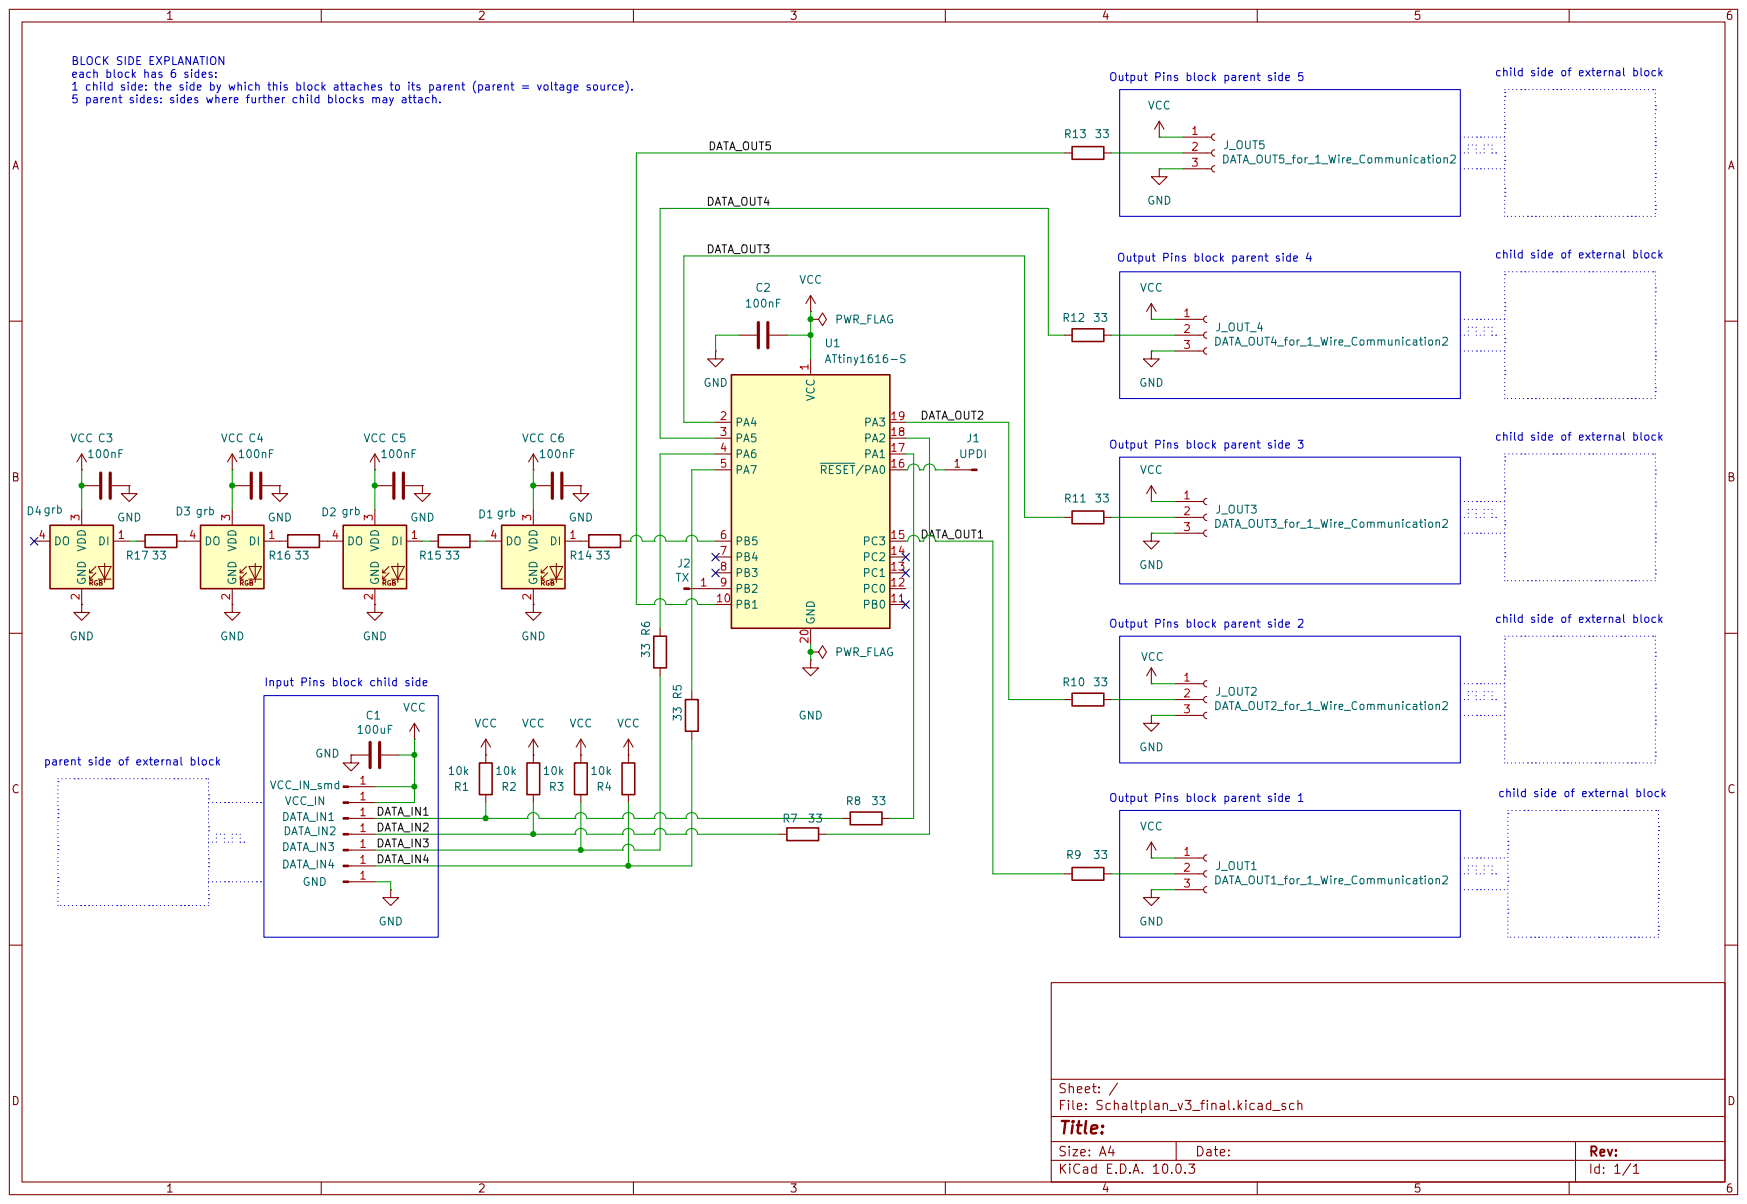
[picture p85: page 1]
