elsp02/cubes-platformIO/thesis/figures/gesamt-kommunikationssequenz.drawio.pdf

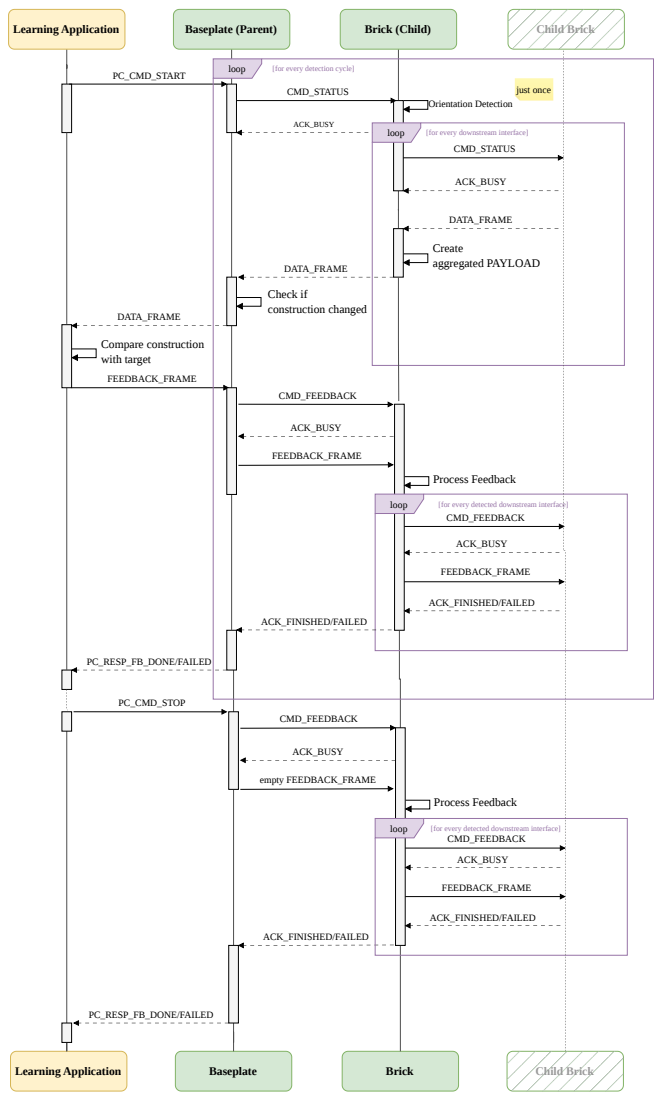
[picture p86: page 1]
Baseplate (Parent); Brick (Child); Child Brick; Baseplate; Brick; Learning Application; PC_CMD_START; CMD_STATUS; Orientation Detection; just once; ACK_BUSY; loop; [for every downstream interface]; DATA_FRAME; Create aggregated PAYLOAD DATA_FRAME; Check if construction changed DATA_FRAME; Compare construction with target; FEEDBACK_FRAME; CMD_FEEDBACK; Process Feedback; [for every detected downstream interface]; ACK_FINISHED/FAILED; PC_RESP_FB_DONE/FAILED; PC_CMD_STOP; empty FEEDBACK_FRAME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
