elsp02/cubes-platformIO/thesis/figures/aktivitätsdiagramm.pdf

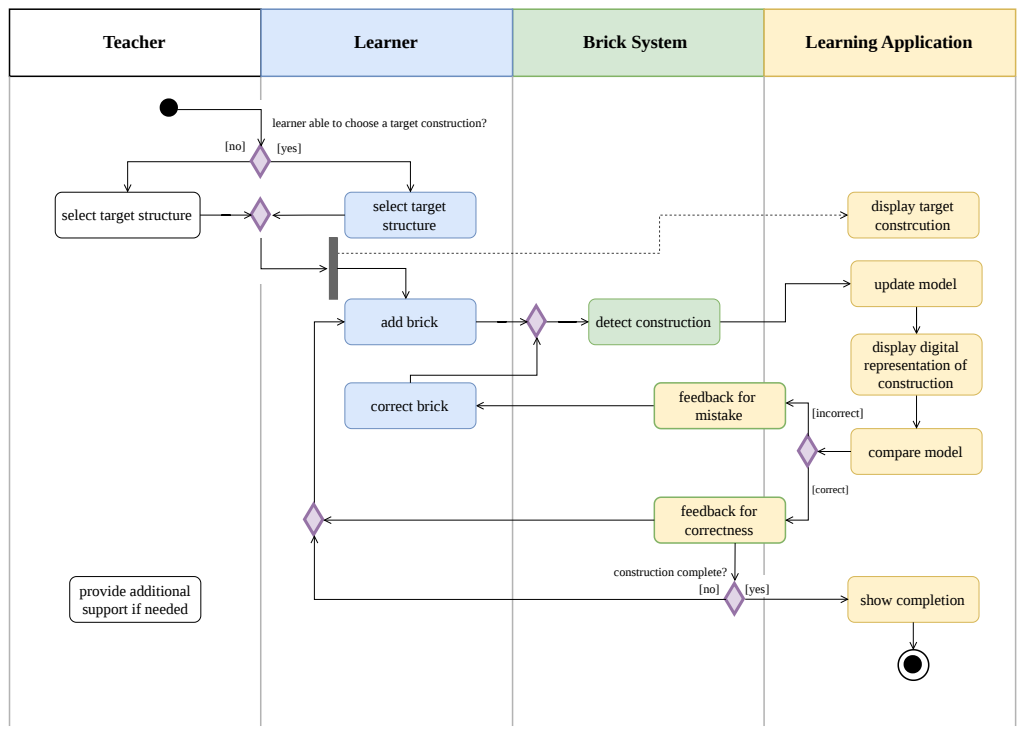
[picture p87: page 1]
Teacher; Learner; Brick System; Learning Application; display target constrcution; select target structure; add brick; detect construction; update model; compare model; feedback for mistake; feedback for correctness; show completion; correct brick; [correct]; [incorrect]; [yes]; construction complete?; display digital representation of construction

learner able to choose a target construction?
[yes]

select target structure

provide additional
support if needed
