elsp02/cubes-platformIO/thesis/figures/architektur-sequenzdiagramm.pdf

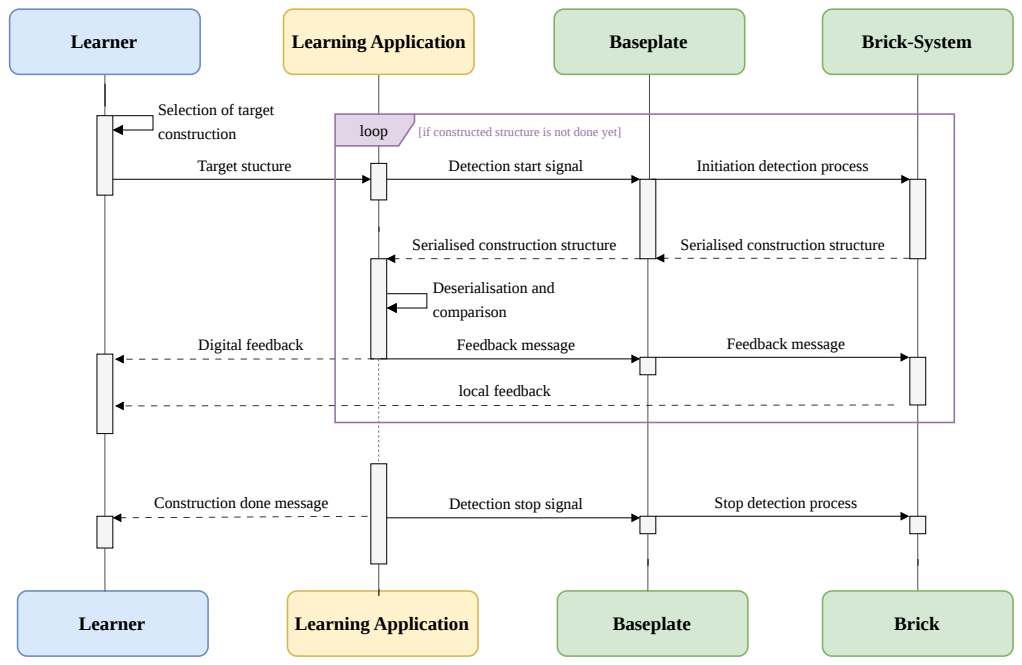
[picture p88: page 1]
Learner; Learning Application; Baseplate; Brick-System; Detection start signal; Initiation detection process; Serialised construction structure; Deserialisation and comparison; Digital feedback; Feedback message; local feedback; Construction done message; Detection stop signal; Stop detection process; Brick; loop; [if constructed structure is not done yet]

Selection of target
construction
Target stucture
