elsp02/cubes-platformIO/thesis/figures/zustandsdiagram-baseplate.pdf

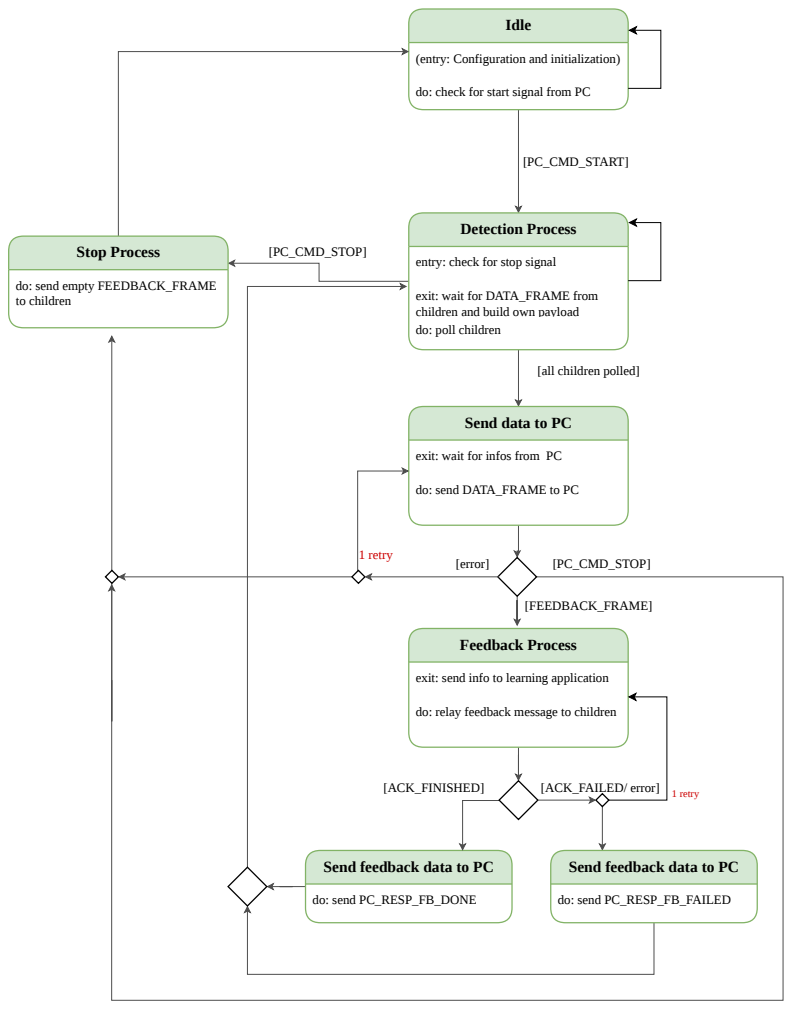
[picture p89: page 1]
Idle; Detection Process; [PC_CMD_START]; Feedback Process; [FEEDBACK_FRAME]; do: send PC_RESP_FB_DONE; do: send PC_RESP_FB_FAILED; [ACK_FINISHED]; [ACK_FAILED/ error] 1 retry; 1 retry; Stop Process; [PC_CMD_STOP]; [error]

(entry: Configuration and initialization)

do: check for start signal from PC

entry: check for stop signal

do: send empty FEEDBACK_FRAME
to children

exit: wait for DATA_FRAME from
children and build own payload
do: poll children

[all children polled]

Send data to PC

exit: wait for infos from PC

do: send DATA_FRAME to PC

exit: send info to learning application

do: relay feedback message to children

Send feedback data to PC
