elsp02/cubes-platformIO/thesis/figures/zustandsdiagram-brick.pdf

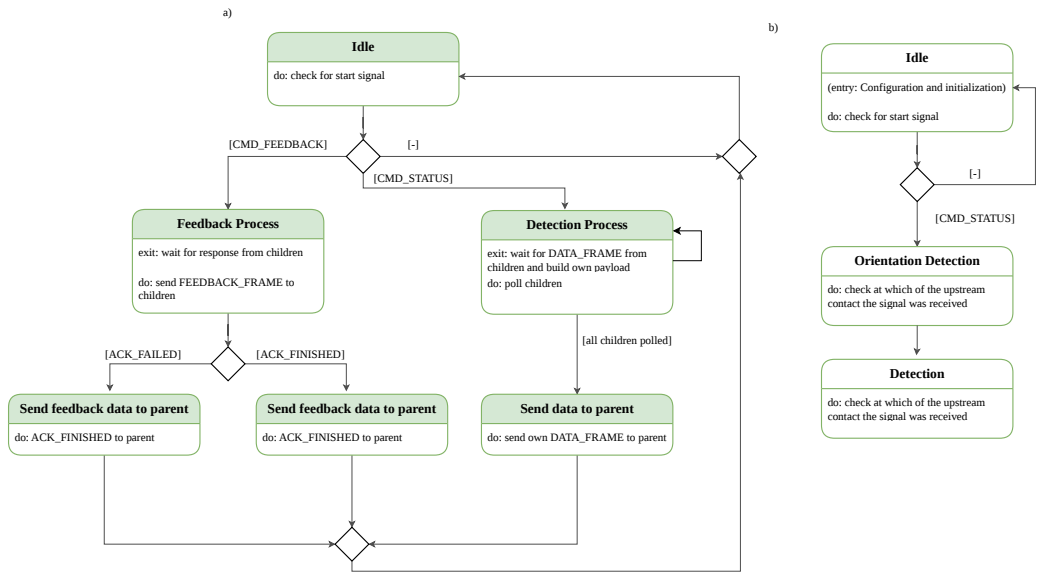
[picture p90: page 1]
Idle; Detection Process; Feedback Process; [ACK_FAILED]; [ACK_FINISHED]; [CMD_STATUS]; [CMD_FEEDBACK]; Orientation Detection; Detection

do: check for start signal

(entry: Configuration and initialization)

exit: wait for response from children

exit: wait for DATA_FRAME from
children and build own payload
do: poll children

do: send FEEDBACK_FRAME to
children

do: check at which of the upstream
contact the signal was received

[all children polled]

Send feedback data to parent

Send data to parent

do: ACK_FINISHED to parent

do: send own DATA_FRAME to parent
