elsp02/cubes-platformIO/hardware/pcb_files/baseplate/14-09-26_baseplate_circuit_schematic.pdf

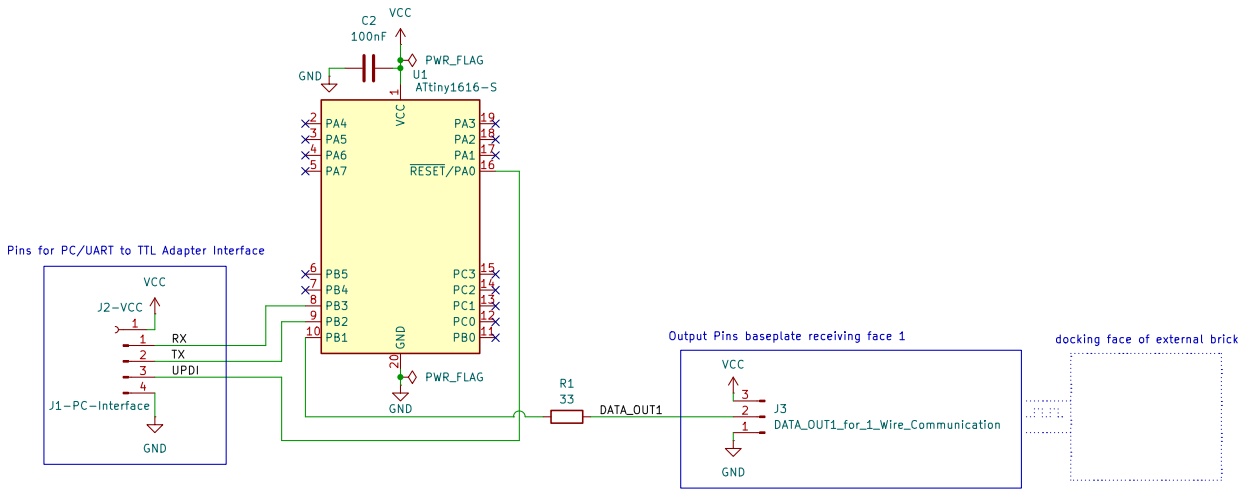
[picture p91: page 1]
