elsp02/cubes-platformIO/hardware/pcb_files/brick/14-09-26_brick_circuit_schematic.pdf

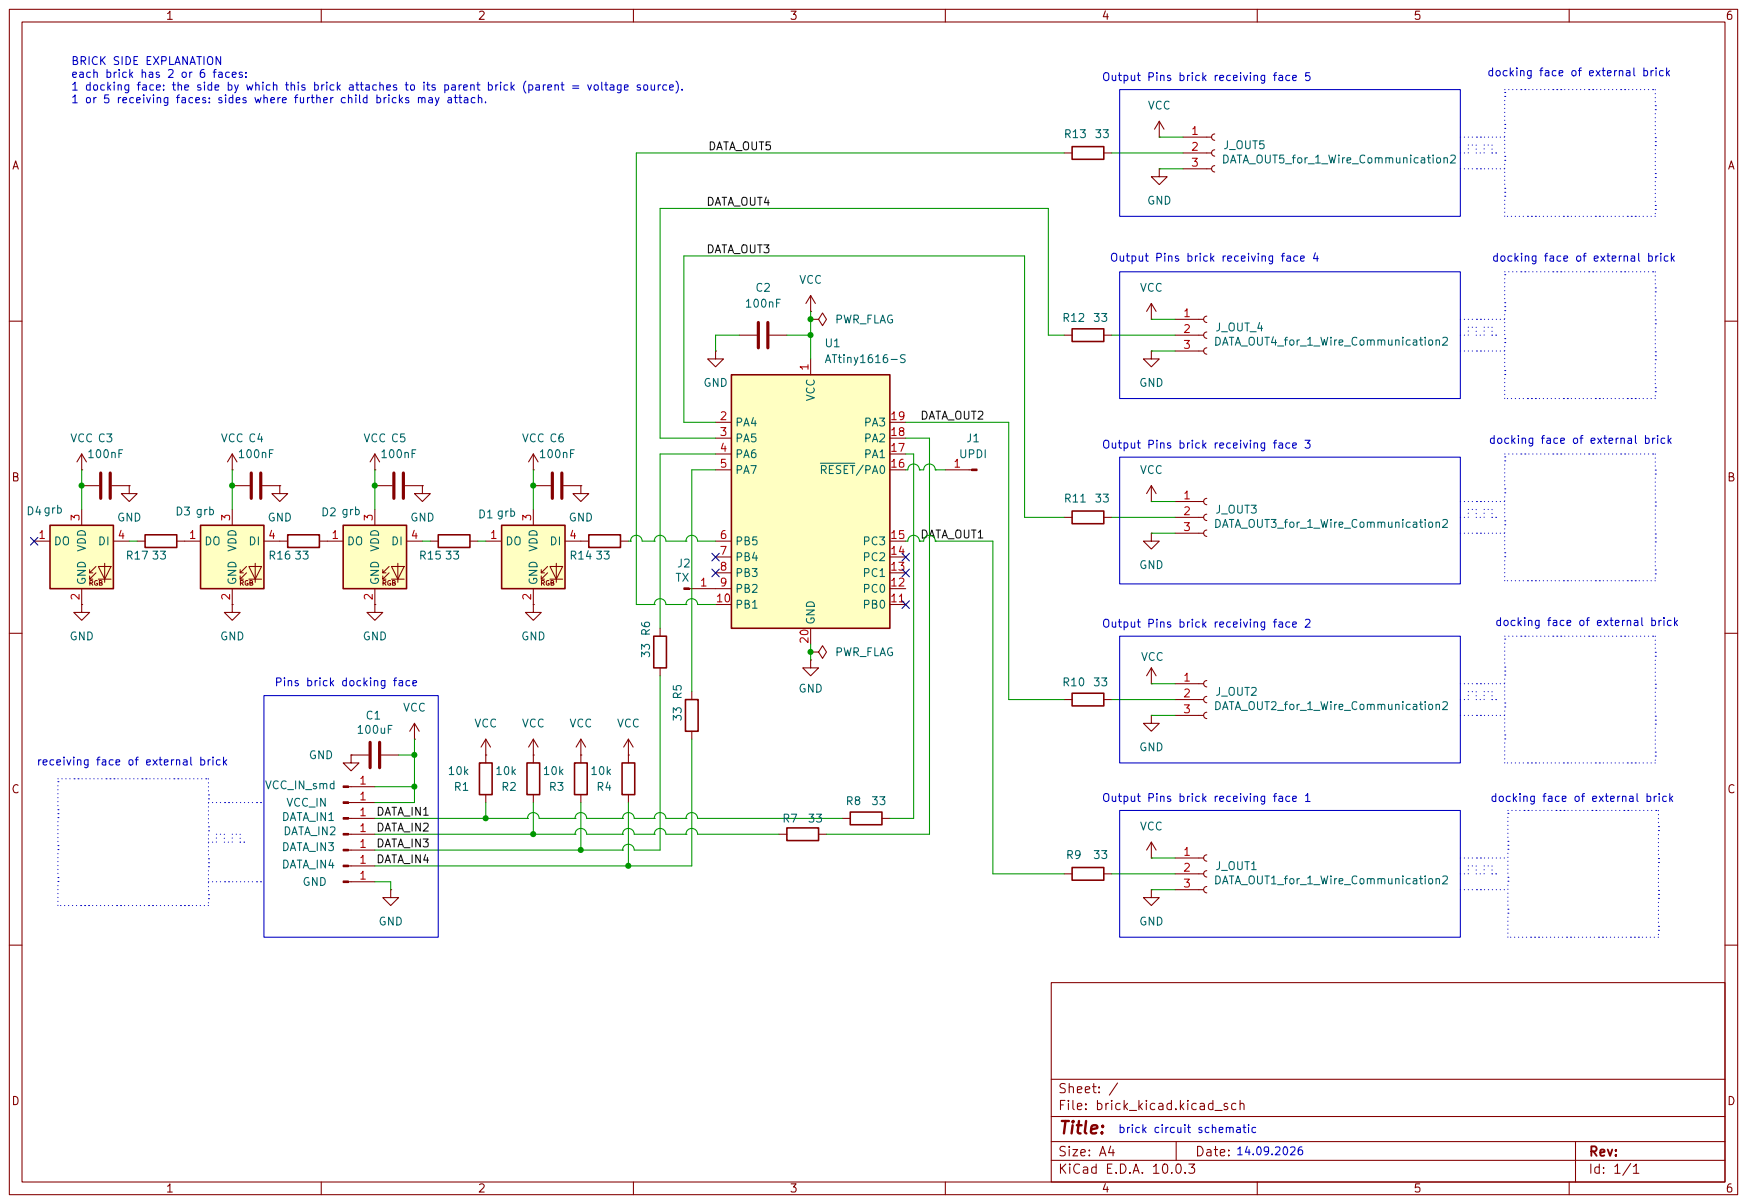
[picture p92: page 1]
