elsp02/cubes-platformIO/hardware/pcb_files/baseplate/baseplate_circuit_diagram.pdf

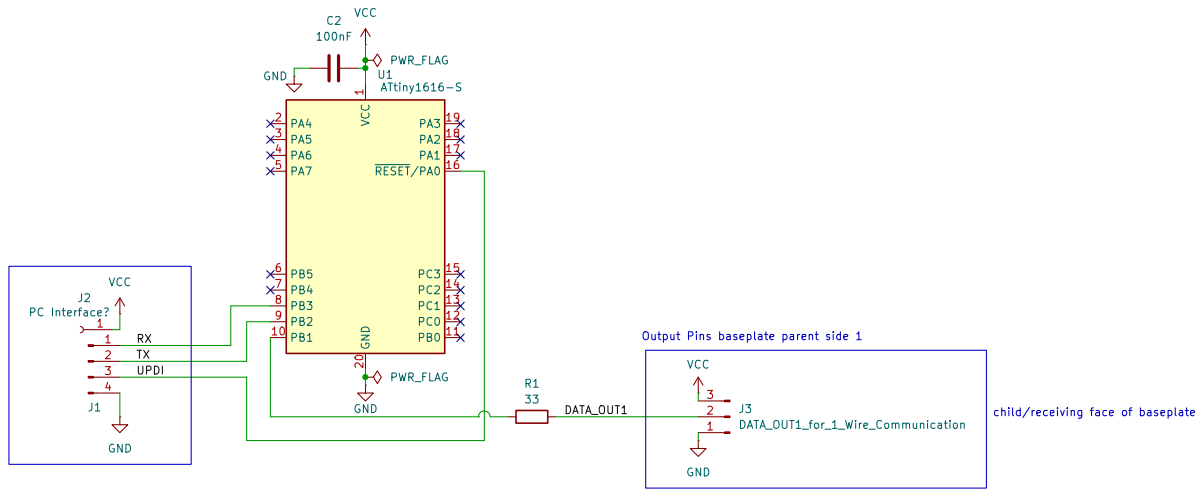
[picture p93: page 1]
