elsp02/cubes-platformIO/hardware/pcb_files/brick/brick_circuit_diagram.pdf

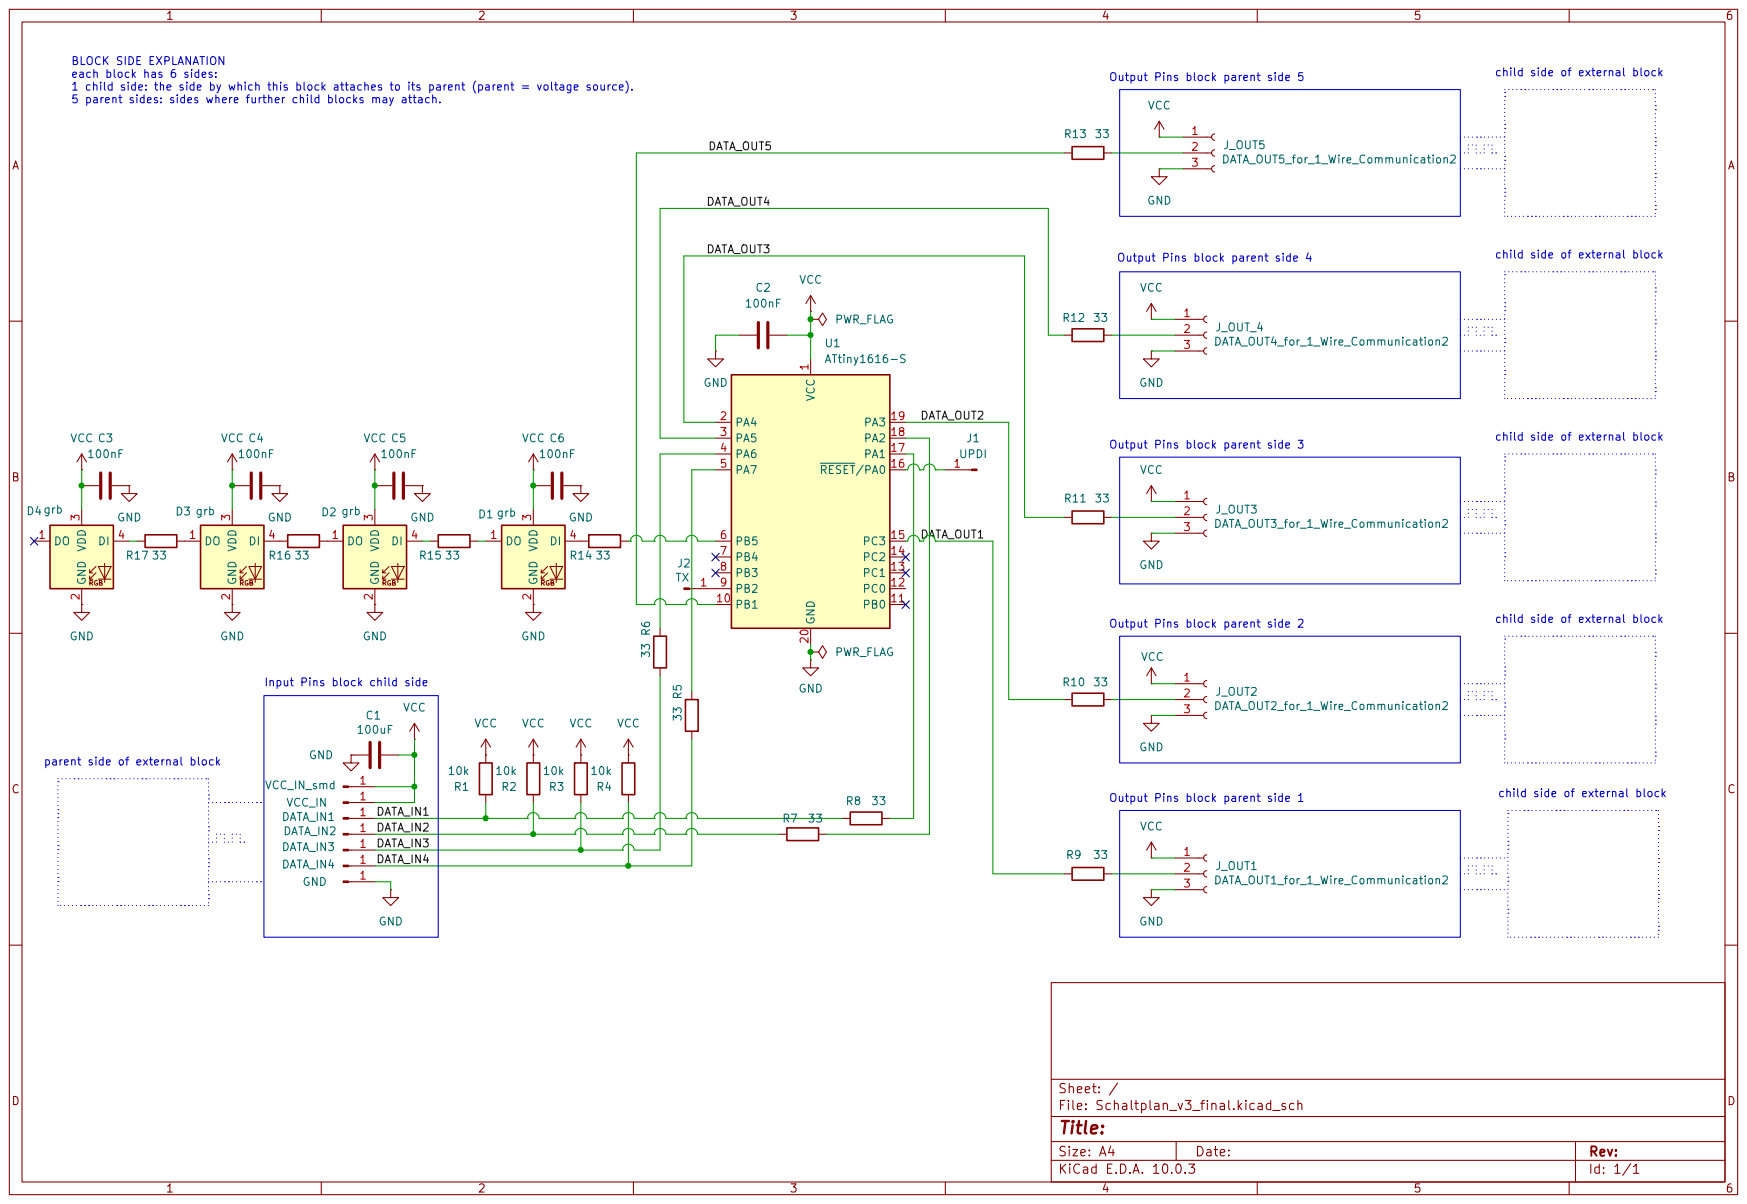
[picture p94: page 1]
