elsp02/cubes-platformIO/hardware/pcb_files/brick/brick_kicad/brick_kicad.kicad_pcb

## KiCad design hardware/pcb_files/brick/brick_kicad/brick_kicad.kicad_pcb (2026-09-18)

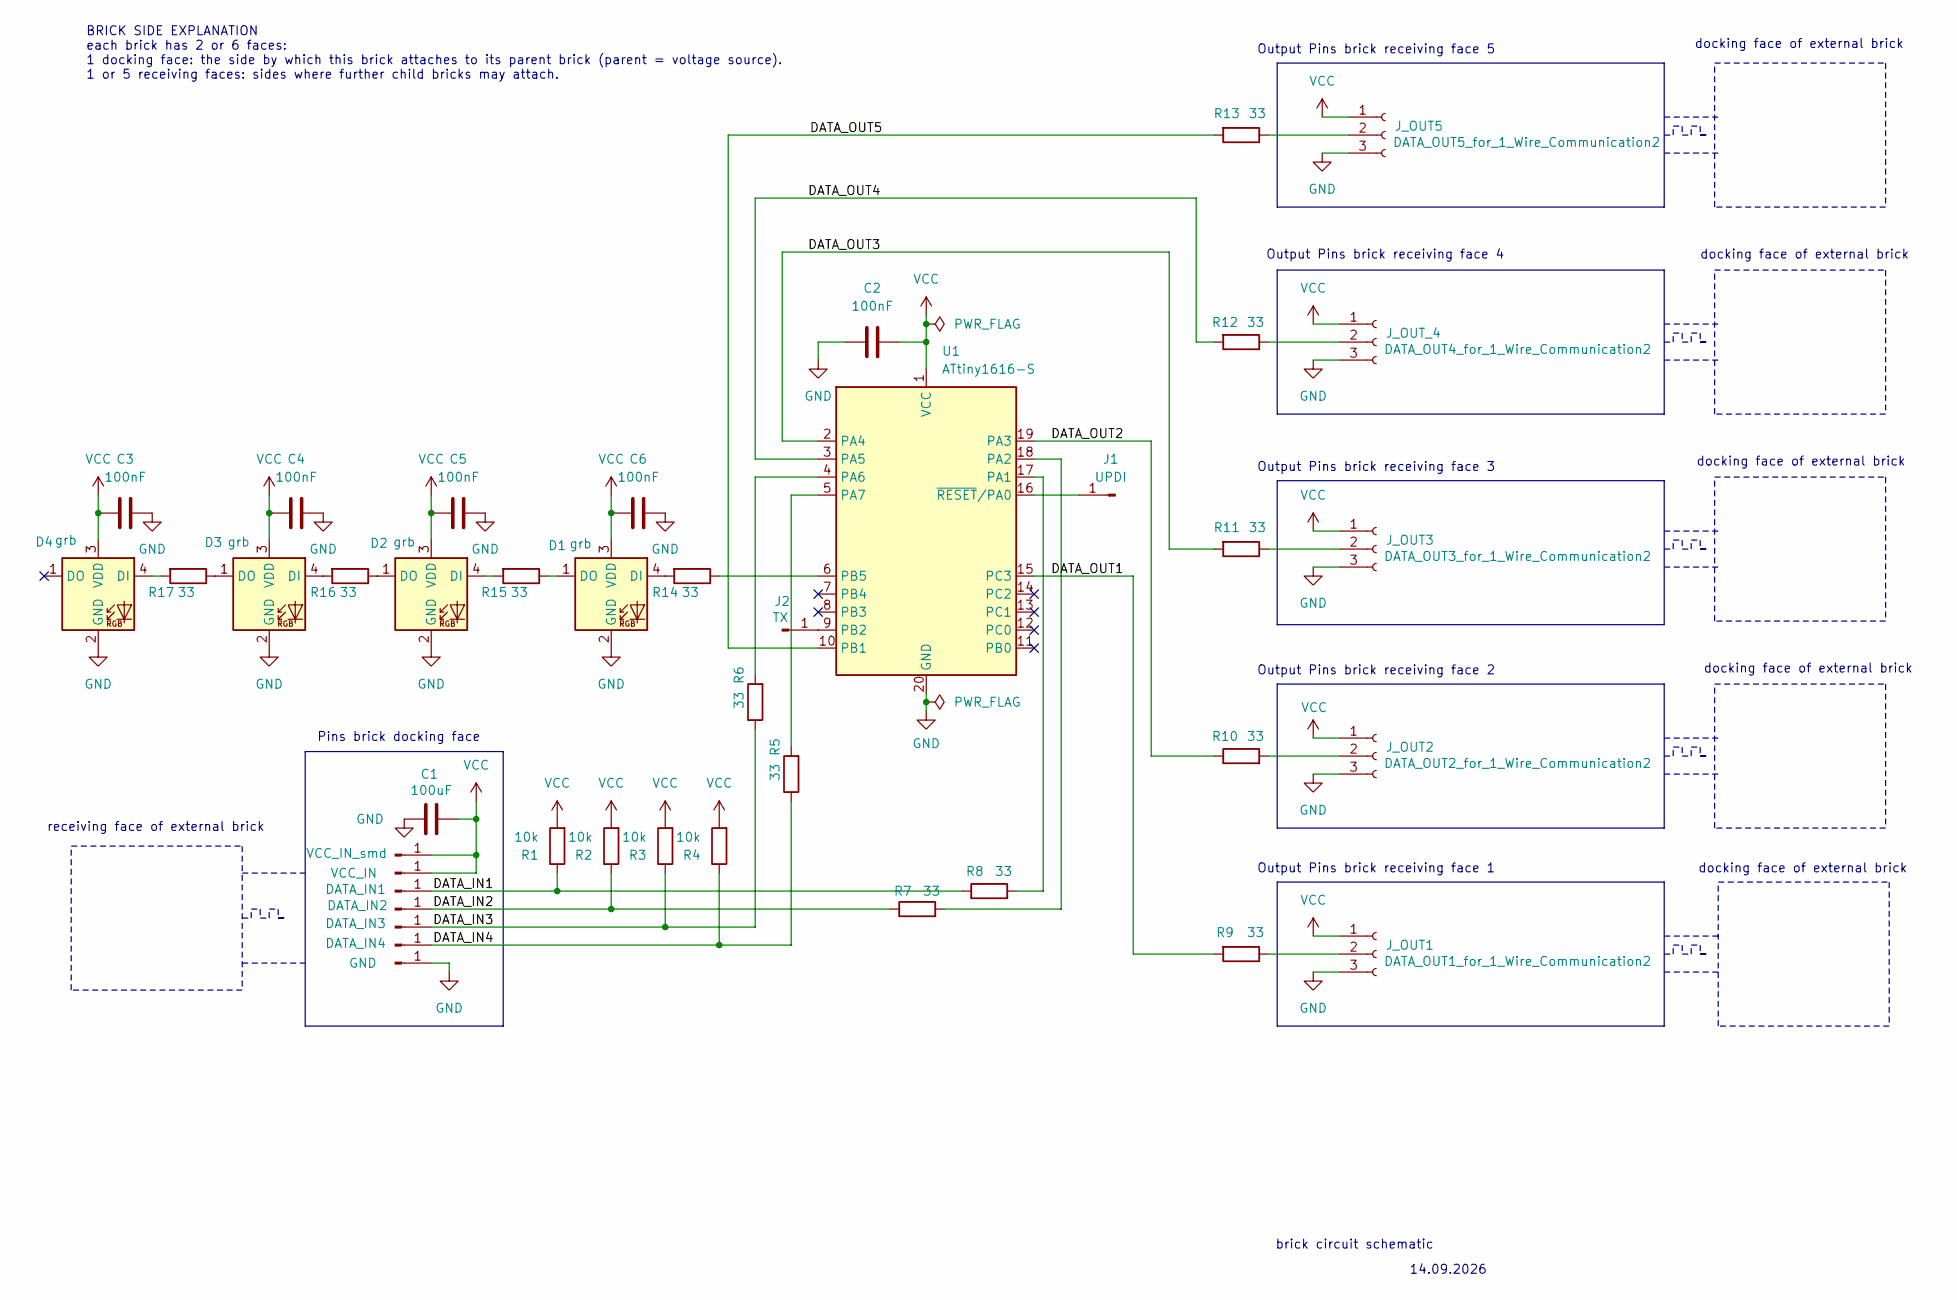
[picture p95: schematic brick_kicad.kicad_sch]

Parts:
C1: 100uF; C_1206_3216Metric_Pad1.33x1.80mm_HandSolder; MPN 885012108005
C2, C3, C4, C5, C6: 100nF; C_0805_2012Metric_Pad1.18x1.45mm_HandSolder; MPN 885012207016
D1, D2, D3, D4: grb; U_Wurth_WL-ICLED_1313210530000
J1: UPDI; PinSocket_1x01_P2.54mm_Vertical
J2: TX; PinSocket_1x01_P2.54mm_Vertical
J_GND1: GND; pogo_pad_IN
J_IN1: DATA_IN1; pogo_pad_IN
J_IN2: DATA_IN2; pogo_pad_IN
J_IN3: DATA_IN3; pogo_pad_IN
J_IN4: DATA_IN4; pogo_pad_IN
J_OUT1: DATA_OUT1_for_1_Wire_Communication2; Wuerth_WR-WTB_64800311622_1x03_P1.50mm_Vertical; MPN 64800311622
J_OUT2: DATA_OUT2_for_1_Wire_Communication2; Wuerth_WR-WTB_64800311622_1x03_P1.50mm_Vertical; MPN 64800311622
J_OUT3: DATA_OUT3_for_1_Wire_Communication2; Wuerth_WR-WTB_64800311622_1x03_P1.50mm_Vertical; MPN 64800311622
J_OUT5: DATA_OUT5_for_1_Wire_Communication2; Wuerth_WR-WTB_64800311622_1x03_P1.50mm_Vertical; MPN 64800311622
J_OUT_4: DATA_OUT4_for_1_Wire_Communication2; Wuerth_WR-WTB_64800311622_1x03_P1.50mm_Vertical; MPN 64800311622
J_VCC1: VCC_IN; pogo_pin_magnet
J_VCC2: VCC_IN_smd; pogo_pin_smd
R1, R2, R3, R4: 10k; R_0603_1608Metric_Pad0.98x0.95mm_HandSolder; MPN 560112116005
R5, R6, R7, R8, R9, R10, R11, R12, R13, R14, R15, R16, R17: 33; R_0603_1608Metric_Pad0.98x0.95mm_HandSolder; MPN 560112116034
U1: ATtiny1616-S; SOIC-20W_7.5x12.8mm_P1.27mm

Connections:
/DATA_IN1: J_IN1.1 (Pin_1_1), R1.1, R8.1
/DATA_IN2: J_IN2.1 (Pin_1_1), R2.1, R7.1
/DATA_IN3: J_IN3.1 (Pin_1_1), R3.1, R6.1
/DATA_IN4: J_IN4.1 (Pin_1_1), R4.1, R5.1
/DATA_OUT1: R9.2, U1.15 (PC3)
/DATA_OUT2: R10.1, U1.19 (PA3)
/DATA_OUT3: R11.2, U1.2 (PA4)
/DATA_OUT4: R12.2, U1.3 (PA5)
/DATA_OUT5: R13.2, U1.10 (PB1)
GND: C1.1, C2.2, C3.1, C4.1, C5.1, C6.1, D1.2 (GND), D2.2 (GND), D3.2 (GND), D4.2 (GND), J_GND1.1 (Pin_1_1), J_OUT1.3, J_OUT2.3, J_OUT3.3, J_OUT5.3, J_OUT_4.3, U1.20 (GND)
unnamed: D1.4 (DI), R14.2
unnamed: D1.1 (DO), R15.1
unnamed: D2.4 (DI), R15.2
unnamed: D2.1 (DO), R16.1
unnamed: D3.4 (DI), R16.2
unnamed: D3.1 (DO), R17.1
unnamed: D4.4 (DI), R17.2
unnamed: J1.1 (Pin_1_1), U1.16 (~RESET/PA0)
unnamed: J2.1 (Pin_1_1), U1.9 (PB2)
unnamed: J_OUT1.2, R9.1
unnamed: J_OUT2.2, R10.2
unnamed: J_OUT3.2, R11.1
unnamed: J_OUT5.2, R13.1
unnamed: J_OUT_4.2, R12.1
unnamed: R8.2, U1.17 (PA1)
unnamed: R7.2, U1.18 (PA2)
unnamed: R6.2, U1.4 (PA6)
unnamed: R5.2, U1.5 (PA7)
unnamed: R14.1, U1.6 (PB5)
VCC: C1.2, C2.1, C3.2, C4.2, C5.2, C6.2, D1.3 (VDD), D2.3 (VDD), D3.3 (VDD), D4.3 (VDD), J_OUT1.1, J_OUT2.1, J_OUT3.1, J_OUT5.1, J_OUT_4.1, J_VCC1.1 (Pin_1_1), J_VCC2.1 (Pin_1_1), R1.2, R2.2, R3.2, R4.2, U1.1 (VCC)

Notes on the sheet:
Output Pins brick receiving face 3
docking face of external brick
BRICK SIDE EXPLANATION each brick has 2 or 6 faces: 1 docking face: the side by which this brick attaches to its parent brick (parent = voltage source). 1 or 5 receiving faces: sides where further child bricks may attach.
14.09.2026
Output Pins brick receiving face 4
Output Pins brick receiving face 2
Output Pins brick receiving face 5
receiving face of external brick
Pins brick docking face
brick circuit schematic
Output Pins brick receiving face 1

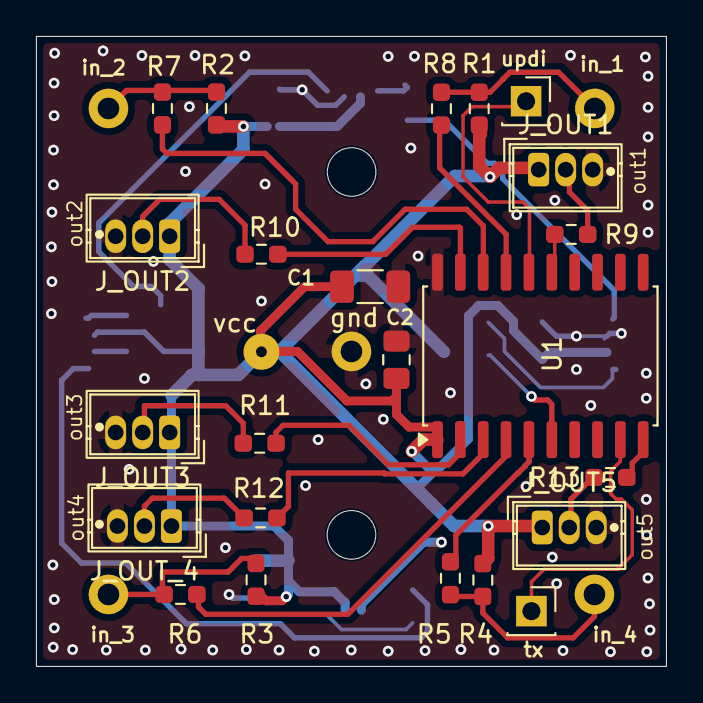
[picture p96: board brick_kicad.kicad_pcb from above]

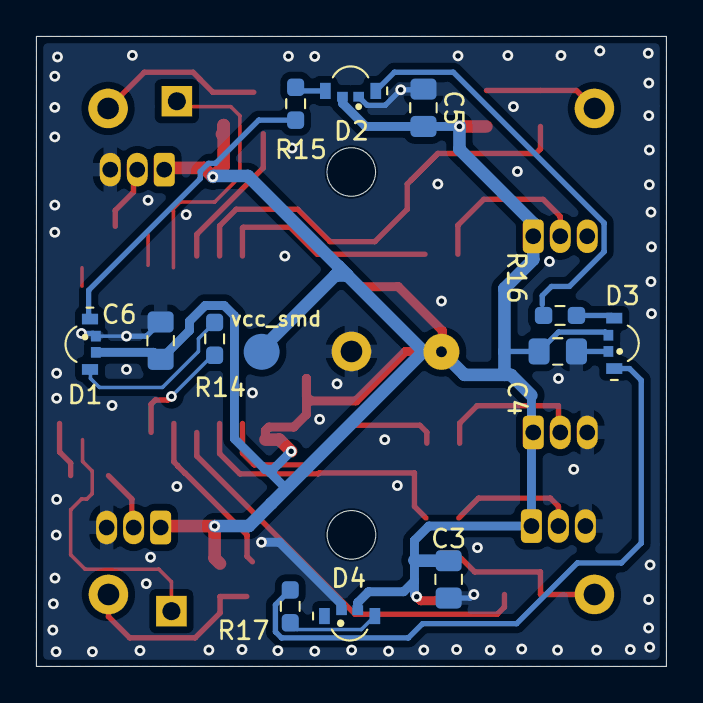
[picture p97: board brick_kicad.kicad_pcb from below]

Board: 2 copper layers, 35.0 x 35.0 mm, 42 parts (13 on the bottom side), 30 nets.
