elsp02/cubes-platformIO/hardware/pcb_files/baseplate/baseplate_circuit_diagram.kicad_sch

## KiCad design hardware/pcb_files/baseplate/baseplate_circuit_diagram.kicad_sch (2026-09-09)

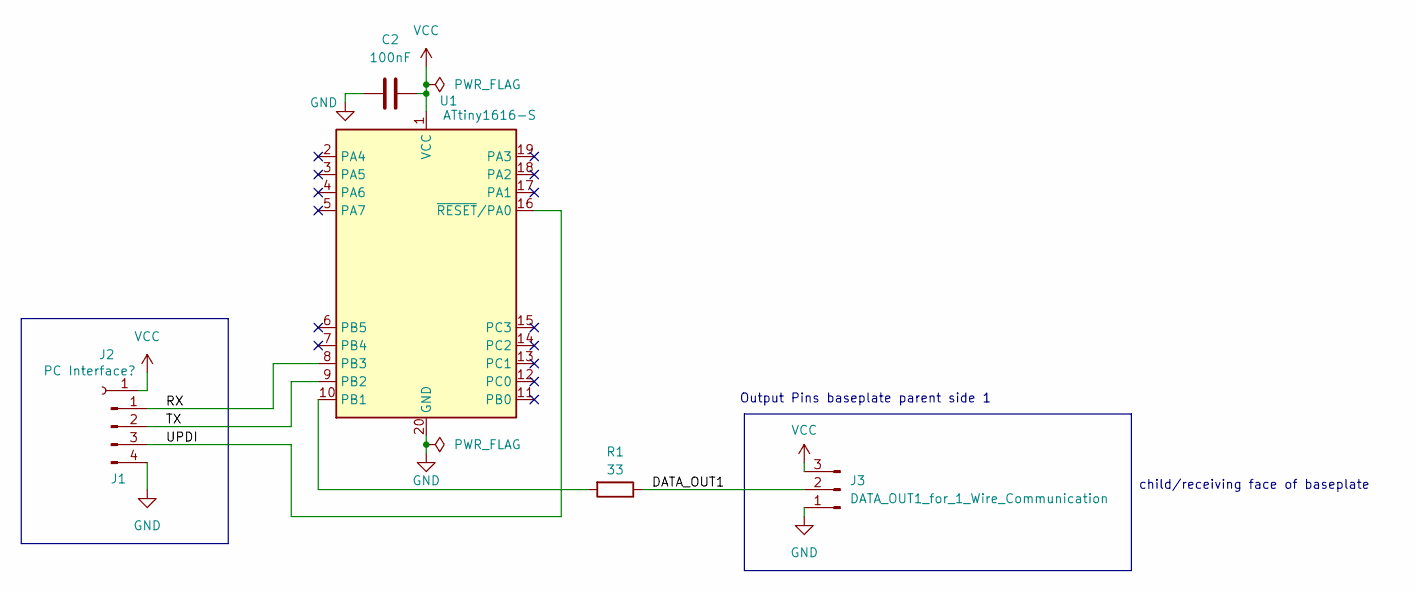
[picture p98: schematic baseplate_circuit_diagram.kicad_sch]

Parts:
C2: 100nF; C_0805_2012Metric_Pad1.18x1.45mm_HandSolder; MPN 885012207016
J1: (no value)
J2: PC Interface?
J3: DATA_OUT1_for_1_Wire_Communication
R1: 33
U1: ATtiny1616-S; SOIC-20W_7.5x12.8mm_P1.27mm

Connections:
DATA_OUT1: J3.2, R1.1
GND: C2.2, J1.4, J3.1, U1.20 (GND)
unnamed: R1.2, U1.10 (PB1)
RX: J1.1, U1.8 (PB3)
TX: J1.2, U1.9 (PB2)
UPDI: J1.3, U1.16 (~RESET/PA0)
VCC: C2.1, J2.1, J3.3, U1.1 (VCC)

Notes on the sheet:
child/receiving face of baseplate
Output Pins baseplate parent side 1
