elsp02/cubes-platformIO/hardware/pcb_files/baseplate/baseplate_kicad/baseplate_circuit_diagram.kicad_sch

## KiCad design hardware/pcb_files/baseplate/baseplate_kicad/baseplate_circuit_diagram.kicad_sch (2026-09-14)

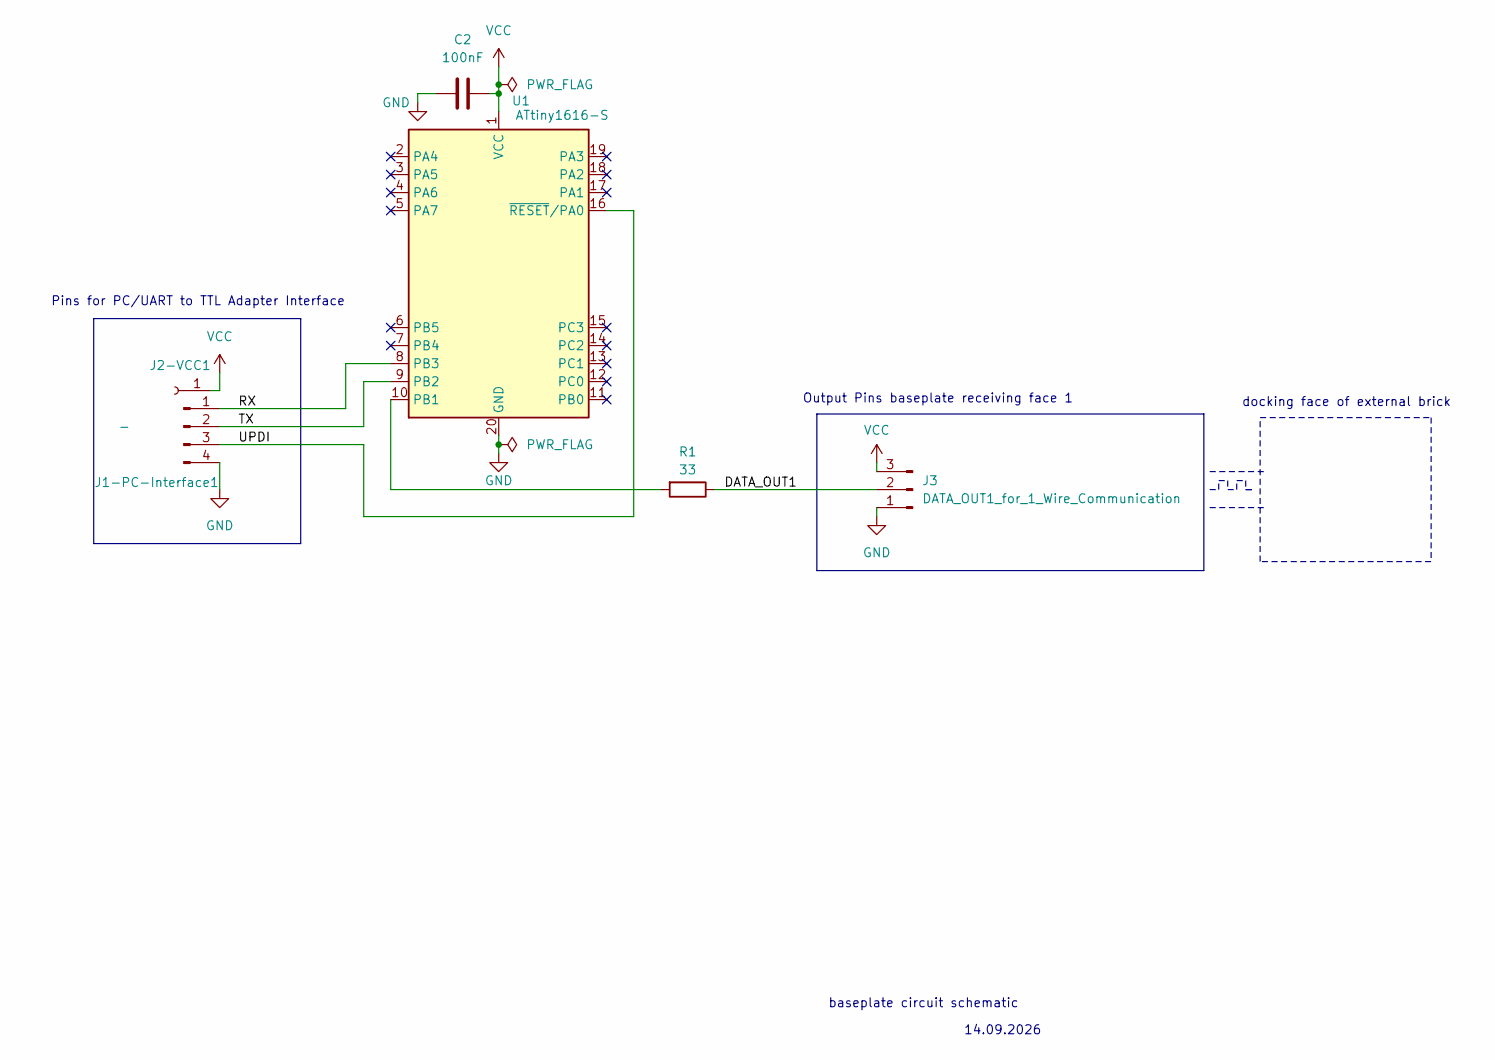
[picture p100: schematic baseplate_circuit_diagram.kicad_sch]

Parts:
C2: 100nF; C_0805_2012Metric_Pad1.18x1.45mm_HandSolder; MPN 885012207016
J1-PC-Interface1: -; PinHeader_1x04_P2.54mm_Vertical
J2-VCC1: VCC; PinSocket_1x01_P2.54mm_Vertical
J3: DATA_OUT1_for_1_Wire_Communication; PinHeader_1x03_P2.54mm_Vertical
R1: 33; R_0603_1608Metric_Pad0.98x0.95mm_HandSolder
U1: ATtiny1616-S; SOIC-20W_7.5x12.8mm_P1.27mm

Connections:
DATA_OUT1: J3.2, R1.1
GND: C2.2, J1-PC-Interface1.4, J3.1, U1.20 (GND)
unnamed: R1.2, U1.10 (PB1)
RX: J1-PC-Interface1.1, U1.8 (PB3)
TX: J1-PC-Interface1.2, U1.9 (PB2)
UPDI: J1-PC-Interface1.3, U1.16 (~RESET/PA0)
VCC: C2.1, J2-VCC1.1, J3.3, U1.1 (VCC)

Notes on the sheet:
Pins for PC/UART to TTL Adapter Interface
baseplate circuit schematic
docking face of external brick
14.09.2026
Output Pins baseplate receiving face 1
