elsp02/cubes-platformIO/(commit log)

2026-06-04 prototype_v2 final
2026-06-04 definition prototype_v3
2026-06-30 V4 IS CURRENTLY NOT WORKING BECAUSE OF DESYNCHRONIZATION - THEREFORE GO TO V2_2 or V5
2026-06-30 code of prototype_v2.2 +meshcat visualization added
2026-07-11 keine ahnung warums nicht funktioniert hat und jetzt wieder funktioniert
2026-07-15 uart communication between pc and attiny tested
2026-07-15 uart communication in existing baseplate code with sending payload frames
2026-07-15 uart communication with working threejs visualization
2026-07-15 feedback leds an
2026-07-18 prototype building page
2026-07-20 pcb added
2026-07-26 repository restructured and software wiring dpending on different cubes integrated
2026-07-27 pin configuration
2026-07-29 layout und cube model ausprobiert
2026-08-14 anforderungsanalyse und ID Logic
2026-08-31 incorrect organized files - firmware currently not working
2026-09-01 environment uart_baseplate with uart_main_baseplate.cpp and uart_cube with final_uart_main_cube.cpp working
2026-09-01 baseplate state machine correct until State RELAY_FEEDBACK
2026-09-01 state machine code logically adapted to uart_main_baseplate.cpp
2026-09-02 baseplate bug detected (150ms after each cycle) and uart_cube env working
2026-09-05 rgb led included
2026-09-05 cube with 1 led working
2026-09-07 baseplate bug explained in firmware readme current development status
2026-09-14 toggle pin added
2026-09-14 pcb files updated and old cube and baseplate folders deleted
2026-09-18 grb led cube and pcb files
